vrrrrs/RL-CAT/docs/00-overview.md

# 项目总览（Overview）

> **文档编号**：DOC-OV-001 ｜ **版本**：v1.0 ｜ **日期**：2026-10-09
>
> **状态**：🟡 骨架 + 部分内容。完整内容待后续补齐（见文末「待补充」）。

---

## 1. 项目是什么

**RL-CAT 是一只 12 自由度四足机器人**，目标是走通"机械设计 → 仿真 → 强化学习训练 → sim-to-real 部署"的完整链路。

| 项 | 值 |
|---|---|
| **自由度** | 12（每腿 3：髋外摆 + 髋俯仰 + 膝） |
| **整机质量** | 1.386 kg（CAD 实测） |
| **机身尺寸** | 200 × 72 × 58 mm |
| **站立高度** | 约 133 mm（仿真实测） |
| **执行器** | 12 × Feetech ST-3215-C018（12V 版）总线舵机 |
| **上位机** | 树莓派 5 (4GB) —— 跑 RL 策略 |
| **下位机** | STM32F103C8T6 —— 100 Hz 实时控制 |
| **控制频率** | 100 Hz |
| **观测 / 动作** | 47 维 / 12 维 |

### 1.1 设计优先级

```
功能  >  小巧美观
（机械必须小、好看，但功能优先）
```

来源：`archive/方案_v1.md` §0「设计优先级」

---

## 2. 系统架构

```
┌─────────────────────────────────────────────────────────────┐
│  树莓派 5 (4GB)                                              │
│  · 运行 RL 策略（PyTorch / ONNX）                            │
│  · 100 Hz 推理 → 输出 12 维关节目标角                        │
└────────────────────┬────────────────────────────────────────┘
                     │ UART 500 kbps（自定义帧协议，交叉接线）
                     │ 下行：CMD_JOINT   上行：TEL_FAST (47 维观测)
┌────────────────────┴────────────────────────────────────────┐
│  STM32F103C8T6                                               │
│  · 100 Hz 控制环                                             │
│  · 舵机总线时序（SyncWrite / SyncRead）                       │
│  · 传感器采集（IMU 姿态、电池电压）                            │
│  · 安全保护（低压 / 超温 / 失联 → 趴下）                       │
└───────┬──────────────────────────┬──────────────────────────┘
        │ UART 500 kbps            │ 软件 I2C
        │ 直连（RX→RX, TX→TX）      │
┌───────┴──────────┐        ┌──────┴────────┐
│ 舵机控制板        │        │  JY901P IMU   │
│ (Waveshare A)    │        │ （内部融合）   │
│ 跳线 A 位         │        └───────────────┘
└───────┬──────────┘
        │ 半双工总线
┌───────┴──────────────────────────────────────┐
│  12 × ST-3215-C018 总线舵机                   │
│  供电：3S 电池经 16 AWG 粗线直供（绕过控制板）  │
└──────────────────────────────────────────────┘
```

### 2.1 职责边界（⚠️ 必须严格）

| 职责 | 树莓派 | STM32 |
|---|---|---|
| 策略推理 | ✅ | ❌ |
| 关节目标角生成 | ✅ | ❌ |
| 舵机总线时序 | ❌ | ✅ |
| PD 位置闭环 | ❌ | ✅（舵机内部 PID） |
| 传感器采集 | ❌ | ✅ |
| 姿态解算 | ❌ | ❌（JY901P 内部完成） |
| **安全保护** | ❌ | ✅ **（不依赖上位机）** |

**⚠️ 最重要：安全保护必须在 STM32 上独立完成，链路断了要能自己识别并趴下。**

---

## 3. 子系统导航

| 子系统 | 文档 | 代码/CAD 位置 |
|---|---|---|
| 机械 | [`10-mechanical.md`](10-mechanical.md) | [`hardware/mechanical/`](../hardware/mechanical/) |
| 电子 | [`20-electronics.md`](20-electronics.md) | [`hardware/electronics/`](../hardware/electronics/) |
| 固件 | [`30-firmware.md`](30-firmware.md) | [`firmware/`](../firmware/) |
| 仿真与训练 | [`40-simulation.md`](40-simulation.md) | [`Sim/`](../Sim/) |
| 部署 | [`50-deployment.md`](50-deployment.md) | — |

---

## 4. 技术路线

```
机械设计（SolidWorks）
   ↓  导出 URDF（SW2URDF）
URDF + 质量属性修正
   ↓  构建仿真环境（Isaac Gym + legged_gym）
RL 训练（PPO）
   ↓  域随机化
策略导出（ONNX）
   ↓
真机部署：Pi 跑策略 → STM32 控舵机
   ↓  系统辨识 → 反哺仿真 → 重训（迭代）
sim-to-real 完成
```

### 4.1 当前进展（最后更新：2026-10-16）

| 阶段 | 状态 | 说明 |
|---|---|---|
| 机械设计 | ✅ v1 完成 | |
| 电子设计 | ✅ 完成 | |
| URDF | ✅ 完成 | 质量/惯量按 SolidWorks 实测修正 |
| 仿真环境 | ✅ 完成 | Isaac Gym + legged_gym `rlcat` task |
| **RL 训练** | ✅ **已训出可行走策略** | 见 §5 |
| **STM32 固件** | ✅ **已交付** | 7966 行 / 7 层；1028 C 单测 + 161 Python 全绿；**真机验收进行中** |
| **舵机标定** | ✅ **已完成**（2026-10-16） | 12 关节 `offset`/`dir` 全部实测确认；零位语义见 [`30-firmware.md`](30-firmware.md) §3.3.1 |
| **ESP32 无线桥** | ✅ **已交付并上真机验证** | TX 链路 300/300 帧零 CRC 错；A4~A23 待执行 |
| **树莓派侧（基础层）** | ✅ **已交付** | 链路/遥测/标定/点动/姿态；离线 117 项 + 物理层 90 万字节零误码 |
| **真机部署** | 🟡 **进行中** | 见 §4.2 |

### 4.2 ⚠️ 当前卡在哪

**舵机标定已过关。剩余阻塞项：**

| # | 阻塞项 |
|---|---|
| 1 | ⚠️ **IMU 读不到** —— `safety_reasons = 0x40`（`RLCA_SAFE_R_IMU_STALE`）。寄存器配置与字节序均已核实正确，怀疑 `imu_poll()` 的陀螺离群值保护在反复丢帧。**它挡住 ACTIVE 准入门第 ④ 条。** |
| 2 | **12 个舵机逐个设 ID** —— 出厂全是 1，直接接 12 个会总线冲突 |
| 3 | **电池 ADC 标定** —— 万用表比对，目标误差 < 50 mV |
| 4 | **舵机侧软限位** —— 上位机设 `Min/Max Angle Limit`（留 10~15% 余量，**勿动 `OFS`**）。这是独立于固件的最后一道保险 |

**⚠️ 详细步骤与最新勘误见 [`42-pi-setup.md`](42-pi-setup.md) §D。**

**⚠️ 已知的固件行为偏差（19 处）与安全风险（`MODE_STAND` 无准入门）见 [`42-pi-setup.md`](42-pi-setup.md) §D2 与 [`../pi/README.md`](../pi/README.md) §8。**

---

## 5. 已取得的成果（仿真）

**在 Isaac Gym 上从零搭起训练环境，训出可稳定行走的策略。**

| 验收项 | 结果 |
|---|---|
| 步态结构 | ✅ 标准对角小跑（非蹦跳/跛行） |
| 左右对称 | ✅ 占空比差 0.08~0.14 |
| **速度跟踪误差** | ✅ **0.060 ~ 0.099 m/s**（−0.3 ~ +0.5 m/s 全段，含后退） |
| 稳定性 | ✅ 32 环境 × 15 s **零摔倒** |
| 机身高度 | ✅ 0.105~0.120 m（目标 0.13） |

**训练规模**：2048 并行环境，12–19 万 steps/s，1000 迭代约 6–8 分钟（RTX 4060 Laptop）。

**完整报告**：[`Sim/RL/RL-CAT-训练实施报告.md`](../Sim/RL/RL-CAT-训练实施报告.md) —— 含 **9 轮调参的完整记录**，包括失败案例与根因分析。

---

## 6. 后续推进顺序

```
[已完成] 机械 → 电子 → URDF → 仿真环境 → RL 训练（仿真侧走通）
   ↓
[已完成] 三端软件交付
         · STM32 固件（7 层 / 1028 C 单测 + 161 Python 全绿）
         · ESP32 无线桥（130 主机测试 + 真机 TX 链路验证）
         · 树莓派基础层（链路 / 遥测 / 标定 / 点动 / 姿态）
   ↓
[已完成] ⭐ 舵机标定（2026-10-16）
         · 12 关节 offset / dir 全部实测确认
         · 零位语义固化：URDF 零位 = 弯腿站姿 = q 0；标定姿态 = 腿伸直
         · 新增 K（安全总览 + 零位/限位）、W（原始步数写）两条调试命令
   ↓
[当前]   真机打通（⚠️ 剩余阻塞项）
         ① IMU 读不到（挡住 ACTIVE 准入门）
         ② 12 个舵机逐个设 ID
         ③ 电池 ADC 标定
         ④ 上位机设舵机 Min/Max Angle Limit（最后一道保险）
   ↓
[下一步] 树莓派侧验收
         pi_hello → status_panel → acceptance → acceptance --move
   ↓
[下一步] （可选）传统步态 —— 逆运动学在 Pi 上算
   ↓
[下一步] 接入 ONNX 策略（⚠️ 需先解决 4 处 RL 契约不一致，见 42-pi-setup §D）
   ↓
[下一步] 真机部署（吊起 → 落地 → 低速 → 放开）
   ↓
[下一步] 系统辨识 → 反哺仿真 → 重训（迭代 2~3 轮）
```

**⚠️ 详细步骤见：**

| 阶段 | 文档 |
|---|---|
| 真机打通 + 树莓派验收 | [`42-pi-setup.md`](42-pi-setup.md) §D4 |
| STM32 上机验收 | [`34-firmware-acceptance.md`](34-firmware-acceptance.md) |
| 固件调试命令 | [`41-firmware-debug-commands.md`](41-firmware-debug-commands.md) |
| 树莓派操作 | [`../pi/使用说明.md`](../pi/使用说明.md) |

---

## 7. 待补充

**⚠️ 本节列出本文档还缺什么，供后续补齐时参考：**

```
□ 项目背景（为什么要做这个项目、灵感来源）
□ 设计约束的完整列表（尺寸上限、成本预算、重量上限）
□ 与同类项目的对比（为什么选四足而不是轮式/双足）
□ 各个关键设计选择的理由汇总
□ 里程碑时间线
□ 硬件物料清单（BOM）与成本
□ 图片 / 渲染图 / 实物照片
```

**⚠️ 部分内容可从归档文档提炼：**

| 来源 | 可提炼内容 |
|---|---|
| `archive/方案_v1.md` §0 | 设计优先级、项目概要 |
| `archive/方案_v1.md` §10 | 推进顺序（已并入 §6） |
| `archive/项目流程_v1.md` | 分工流程、交接点 |

---

**文档结束。**
