vrrrrs/RL-CAT/docs/30-firmware.md

# 固件设计索引（Firmware Index）

> **文档编号**：DOC-FW-001
> **版本**：v1.0
> **日期**：2026-10-09
> **面向对象**：STM32 固件开发者 / Agent
>
> **⭐ 本文件是固件开发的【单一入口】。** 固件开发时反复要查的 5 张表都集中在这里，不需要去别的文档里拼。

---

## 1. 入口：4 份详细文档

**这 4 份是固件的实现规格，务必完整阅读：**

| # | 文档 | 内容 | 什么时候读 |
|---|---|---|---|
| **01** | [固件设计书.md](../firmware/doc/固件设计书.md) | 架构、模块划分、100 Hz 时序、中断优先级、标定、安全、开发阶段 | **先读这个** |
| **02** | [协议规范_树莓派通信.md](../firmware/doc/协议规范_树莓派通信.md) | 帧格式、7 种消息的精确字节布局、CRC-16、接收状态机 | 实现 `link_pi` 前 |
| **03** | [伺服总线模块设计.md](../firmware/doc/伺服总线模块设计.md) | STS 协议、官方库 4 个缺陷、DMA+IDLE 方案、验收测试 | 实现 `servo_bus` 前 |
| **04** | [CubeMX配置清单.md](../firmware/doc/CubeMX配置清单.md) | 配置核对、待改项、上电自检 | **开工第一步** |

**工程位置**：`firmware/stm32/`（CubeMX 工程 + Keil 工程）

---

## 2. ⭐ 表一：关节索引 ↔ 名称 ↔ 舵机 ID

### 2.1 逻辑索引（固件与协议统一使用）

```
索引  0   1   2   3  │  4        5         6         7  │  8       9        10       11
名称  lf  lb  rf  rb │  lf       lb        rf        rb │  lf      lb       rf       rb
类型  髋外摆 ×4       │  髋俯仰 ×4                        │  膝 ×4
```

| 索引 | 关节名 | 类型 | 腿 |
|---|---|---|---|
| **0** | `lf_hip` | 髋外摆 | 左前 |
| **1** | `lb_hip` | 髋外摆 | 左后 |
| **2** | `rf_hip` | 髋外摆 | 右前 |
| **3** | `rb_hip` | 髋外摆 | 右后 |
| **4** | `lf_thigh` | 髋俯仰 | 左前 |
| **5** | `lb_thigh` | 髋俯仰 | 左后 |
| **6** | `rf_thigh` | 髋俯仰 | 右前 |
| **7** | `rb_thigh` | 髋俯仰 | 右后 |
| **8** | `lf_calf` | 膝 | 左前 |
| **9** | `lb_calf` | 膝 | 左后 |
| **10** | `rf_calf` | 膝 | 右前 |
| **11** | `rb_calf` | 膝 | 右后 |

**⚠️ 所有 12 维向量（观测、动作、协议负载）一律用这个顺序。**

### 2.2 ⚠️ 三套"顺序"不要混淆

| 体系 | 排列 | 用在哪 |
|---|---|---|
| **A. 逻辑索引**（上表） | 按关节类型分组 | **固件数组、协议、观测/动作** |
| **B. URDF 声明顺序** | 按腿分组 | URDF 文件书写顺序 |
| **C. 训练侧顺序** | 按名字查表，自动处理 | legged_gym（不需要映射） |

**B 的实际顺序：**

```
0 lf_hip   1 lf_thigh  2 lf_calf   3 lb_hip   4 lb_thigh  5 lb_calf
6 rf_hip   7 rf_thigh  8 rf_calf   9 rb_hip  10 rb_thigh 11 rb_calf
```

**A → B 映射：**

```c
// A 索引 -> B 索引
const uint8_t A2B[12] = {0, 3, 6, 9, 1, 4, 7, 10, 2, 5, 8, 11};
```

**⚠️ 导出到固件时的映射（训练侧报告 §4.3 给出）：**

```
A2C = [3, 0, 9, 6, 4, 1, 10, 7, 5, 2, 11, 8]
```

### 2.3 舵机 ID 分配（⚠️ 建议方案，需人确认）

| A 索引 | 关节名 | 建议舵机 ID |
|---|---|---|
| 0 | `lf_hip` | 1 |
| 1 | `lb_hip` | 2 |
| 2 | `rf_hip` | 3 |
| 3 | `rb_hip` | 4 |
| 4 | `lf_thigh` | 5 |
| 5 | `lb_thigh` | 6 |
| 6 | `rf_thigh` | 7 |
| 7 | `rb_thigh` | 8 |
| 8 | `lf_calf` | 9 |
| 9 | `lb_calf` | 10 |
| 10 | `rf_calf` | 11 |
| 11 | `rb_calf` | 12 |

**⚠️ 舵机出厂 ID 通常是 1，直接接 12 个会冲突。必须逐个改 ID（改完立刻拔掉，再接下一个）。**

**⚠️ 如果实际 ID 与此表不同，只改 `joint_cfg_t.servo_id` 字段，代码逻辑不动。**

---

## 3. ⭐ 表二：关节限位

### 3.1 ⚠️⚠️ 两个 URDF 的 thigh 上限不同 —— 固件必须用哪个？

| 关节 | 硬件 URDF<br>`hardware/mechanical/URDF/robot.urdf` | 训练 URDF<br>`Sim/RL/urdf/robot_sim.urdf` |
|---|---|---|
| `*_hip` | 0 ~ +40° | 0 ~ +40° |
| **`*_thigh`** | **−35° ~ +30°** | **−35° ~ +90°** ⚠️ |
| `*_calf` | −60° ~ +60° | −60° ~ +60° |

**⭐ 结论：固件应采用【训练 URDF 的 90°】。**

**理由：** 训练好的策略是在 **90°** 限位下训出来的，它的摆腿动作依赖这 90° 的空间。如果固件按硬件 URDF 的 30° 限幅，真机上策略会被硬性削掉摆腿幅度，导致行走异常。

**⚠️ 这个不一致需要回填到硬件 URDF** —— 但目前 `hardware/mechanical/` 由人工负责整理，此处只记录结论。

### 3.2 固件应实现的限位（弧度与度）

| 关节类型 | lower (rad) | lower (°) | upper (rad) | upper (°) |
|---|---|---|---|---|
| **`*_hip`**（外摆） | `0` | 0° | `0.6981317` | **+40°** |
| **`*_thigh`**（髋俯仰） | `-0.61086524` | −35° | `1.5707963` | **+90°** |
| **`*_calf`**（膝） | `-1.0471975` | −60° | `1.0471975` | **+60°** |

**⚠️ `*_hip` 是不对称的（0 ~ +40°），不做内摆（负方向）。**

### 3.3 关节零位与偏置

```
URDF 的 q = 0  ←→  机器人处于【弯腿站立姿态】
```

**✅ 已实测确认**（`Sim/RL/RL-CAT-训练实施报告.md` §4.3）：`default_joint_angles` 全为 0，机器人确实站立成功。

**⚠️ 因此 `q_default = [0]*12`。**

**转换公式：**

```c
// 关节角(rad) → 舵机步数
int16_t joint_to_servo(uint8_t idx, float q_rad) {
    float steps = q_rad * (4096.0f / (2.0f * 3.14159265f));
    float s = g_joints[idx].dir * steps + g_joints[idx].offset;
    return (int16_t)(s + 0.5f);
}
```

**⚠️ `dir` 字段处理左右腿舵机安装方向差异（`+1`/`-1`），不要在上层写 if。**

#### 3.3.1 ⭐⭐⭐ 三个"零"必须分清（2026-10-16 上机验证通过，标定关结束）

**这一节是踩过多轮坑之后定下来的。混淆这三者会导致"标定完立刻大幅运动"。**

| 名字 | 姿态 | 关节角 | 舵机编码器读数 |
|---|---|---|---|
| **URDF 零位** | **弯腿站姿**（`default_joint_angles` 全 0） | **q = 0** | **= `offset`** ⭐ |
| **标定姿态** | **腿伸直、垂直向下、髋水平** | q = ±`q_calib`（**幅值**） | **2048**（上位机里设的） |
| 编码器零 | 舵机自己的 0 位 | 无关 | 0 |

**⇒ `offset[i]` 的精确含义：URDF 零位（弯腿站姿）下，舵机 i 的编码器步数。**
**⇒ 换算恒等式：`step(q) = dir × q × STEPS_PER_RAD + offset`。**

**转换公式（标定姿态 → offset）：**

```
已知 step(q_calib) = 2048（项目负责人在上位机里把"腿伸直"设成 2048）
⇒ offset = 2048 − dir × q_calib × STEPS_PER_RAD
```

**⚠️⚠️ `q_calib` 是【幅值，全为正】，符号完全交给 `dir` 表达。**

**这是本项目最容易搞错的一处，务必记住：**

> `dir` 本身编码了"关节角增大 → 编码器增大(+1) 还是减小(−1)"。
> 如果再给 `q_calib` 加上左右镜像符号，两个符号会**互相抵消**，
> 于是左右两侧的 `offset` 跑到 2048 的**同一侧** —— 那是错的。

**实测证据（项目负责人用 `W` 命令把关节送到 offset 看姿态）：**

| 关节 | dir | q_calib | offset | 与 2048 |
|---|---|---|---|---|
| lf_thigh | +1 | 45° | 2048 − 512 = **1536** | **< 2048** ✅ |
| rf_thigh | −1 | 45° | 2048 + 512 = **2560** | **> 2048** ✅ |
| lf_calf | −1 | 90° | 2048 + 1024 = **3072** | **> 2048** ✅ |
| rf_calf | +1 | 90° | 2048 − 1024 = **1024** | **< 2048** ✅ |

**左右分居 2048 两侧 = 物理镜像对称。**

**⚠️ 标定时机器人必须真的处于"腿伸直"姿态** —— 因为固件按 `q_calib` 反推。
若标定时腿是自然下垂/被外力顶住的，`q_calib` 的假设就不成立。

#### 3.3.2 关节方向表（`dir`，实测确定）

**`dir` 不能只从 URDF 推断**（它取决于舵机安装朝向），**必须实测**。

**⚠️ 2026-10-16 最终确定值（按舵机 ID）：**

```
1↔+1   2↔−1   3↔−1   4↔+1      ← hip    外摆时编码器增/减
5↔+1   6↔+1   7↔−1   8↔−1      ← thigh  前摆时编码器增/减
9↔−1   10↔−1  11↔+1  12↔+1     ← calf   （相对 thigh 的符号关系）
```

**⚠️ calf 那四个（ID 9~12）在 2026-10-16 被**整体翻转**过一次** —— 初版按"与 thigh 同号"猜测，实测定为反向。**这是"不能靠推断、必须实测"的最好例证。**

**集中定义在 `firmware/stm32/Core/Inc/rlcat_config.h` 的 `RLCA_JOINT_DIR_INIT`。上层代码不含任何 `if (左/右)`。**

**⚠️ 验证方法（`W` 命令，见 `docs/41-firmware-debug-commands.md`）：**

```
T 1                 ← 打开手动力矩覆盖（否则 ⑥b 会掐断位置帧）
W <j> <offset_j>    ← 把关节 j 送到它自己的 offset
K                   ← 确认停住 + 目视姿态
```

**若送到的位置正好是"弯腿站姿里该关节该在的位置"，则 `dir` 与 `offset` 都正确。**

**标定方法：** 机器人自然站立 → 卸载力矩 → 等稳定 → 读 12 个舵机位置 → 存为 `offset`。详见设计书 §6。

---

## 4. ⭐ 表三：引脚分配

**MCU**：STM32F103C8T6（Blue Pill，LQFP48）

| 引脚 | 配置 | 用途 | 备注 |
|---|---|---|---|
| **PA0** | `ADC1_IN0` | 电池分压采样 | R1=100k / R2=20k |
| PA1 | — | 空闲 | |
| **PA2** | `USART2_TX` | **舵机控制板**（TX→TX 直连） | 1 Mbps |
| **PA3** | `USART2_RX` | **舵机控制板**（RX→RX 直连） | 1 Mbps |
| PA4 / PA5 | — | 预留 | |
| PA6 / PA7 | — | 空闲（预留 SPI IMU） | |
| **PA8** | GPIO 输出 | 心跳 | 标签 `HEARTBEAT` |
| **PA9** | `USART1_TX` | 树莓派 RX（**交叉**） | 500 kbps |
| **PA10** | `USART1_RX` | 树莓派 TX（**交叉**） | 500 kbps |
| PA11 / PA12 | — | 空闲（USB DM/DP） | |
| **PA13** | SWDIO | 调试 | ⚠️ **绝不复用** |
| **PA14** | SWCLK | 调试 | ⚠️ **绝不复用** |
| PA15 | — | ⚠️ 默认被 JTAG 占用 | 需 `JTAGDisable` 才可用 |
| **PC13** | GPIO 输出（**低电平点亮**）| 状态 LED（板载）| ⚠️ 原文档误写为 PB0 |
| PB1 | — | 备用 | |
| **PB2** | — | ⚠️ **BOOT1，必须悬空** | 不配任何功能 |
| PB3 / PB4 | — | ⚠️ 默认被 JTAG 占用 | 需 `JTAGDisable` |
| PB5 | — | 空闲 | |
| **PB8** | GPIO 开漏 | 软件 I2C SCL → JY901P | 外部 4.7k 上拉到 3.3V |
| **PB9** | GPIO 开漏 | 软件 I2C SDA → JY901P | 外部 4.7k 上拉到 3.3V |
| **PB10** | `USART3_TX` | ESP32-C3 | **115200**（低频调试通道）|
| **PB11** | `USART3_RX` | ESP32-C3 | **115200**（低频调试通道）|
| PB12–PB15 | — | 预留足底开关 / 急停输入 | ⚠️ **本次未实现**，见下 |

**⚠️ 急停输入：本次固件【不实现】，仅保留编译开关。**

```
固件里的位置：rlcat_config.h 的 RLCA_ESTOP_INPUT_EN（当前 = 0）
⚠️ 该宏目前【没有任何代码使用它】—— 刻意如此：
   "留一个没人用的开关"比"留一段没人测过的代码"安全。
   将来实现时，pb12~pb15 任选一个：上拉输入 + EXTI 下降沿，
   中断优先级不低于舵机总线，动作 = 立即进 ESTOP。

⚠️ 因此当前的软件急停路径是：
   ① 链路失联 > 100 ms（link_pi）→ app_safety 缓慢趴下
   ② 电压 ≤ 9.3 V / 舵机 > 70 °C（app_safety）→ 缓慢趴下
   ③ 上位机主动发 CMD_MODE(mode=ESTOP)
   —— 没有"一根线直接拉低"的硬路径。
```

**⚠️ 三路 UART 的接线方式不同：**

| 链路 | 接线 |
|---|---|
| USART1 ↔ 树莓派 | **交叉**（TX→RX、RX→TX） |
| USART2 ↔ 舵机控制板 | **直连**（TX→RX 端子丝印 → 一对一）⚠️ 跳线必须在 **A** 位 |

---

## 5. ⭐ 表四：观测 / 动作向量布局

### 5.1 观测：**47 维**（⚠️ 不是 50 维）

**⚠️ 旧交接文档写的 50 维是【设计值】，实际实现是 47 维（"方案 C"）。固件必须按 47 维拼接。**

| 索引 | 内容 | 维度 | 缩放 | 数据来源 |
|---|---|---|---|---|
| **0–2** | 重力向量（机身系） | 3 | 1.0 | IMU 四元数 → **Pi 反算** |
| **3–5** | 机身角速度（陀螺） | 3 | **×0.25** | IMU |
| **6–8** | 速度指令 (vx, vy, ωz) | 3 | 1.0 | **Pi 自己产生** |
| **9–20** | 关节位置（**相对 `q_default`**） | 12 | 1.0 | 舵机反馈 |
| **21–32** | 关节速度 | 12 | **×0.1** | 舵机反馈 |
| **33–44** | 上一帧动作 | 12 | **×4.0** | **Pi 自己缓存** |
| **45–46** | 步态相位 sin / cos | 2 | 1.0 | ⭐ **STM32 产生，经 TEL_FAST 下发** |
| | **合计** | **47** | | |

**⚠️ 三个关键点：**

| # | 要点 |
|---|---|
| 1 | **关节位置是相对 `q_default` 的**（即 `q - q_default`）。因为 `q_default = 0`，实际就是 `q` 本身 |
| 2 | **关节速度缩放是 ×0.1**，⚠️ upstream legged_gym 默认是 0.05，已按本项目改为 0.1 |
| 3 | ⭐ **步态相位由 STM32 产生**（不是 Pi）—— 理由见 §5.1.1 |

### 5.1.1 ⭐ 为什么步态相位由 STM32 产生

| # | 理由 |
|---|---|
| **1** | **唯一源头** —— 如果两边各产生一份，数值会不一致 |
| **2** | **时钟精度** —— STM32 的 TIM 精确到晶振级（±20 ppm）；Pi 5 的 Linux 用户态循环抖动 0.1~1 ms，**会累积相位误差** |
| **3** | **STM32 本来就是节拍源** —— 100 Hz 周期由 STM32 发起 |
| **4** | **成本极低** —— 查表或 `arm_sin_f32`，每周期 2 次 |

**⚠️ 相位算法（必须与训练侧严格一致，来自 `rlcat_env.py:104-106`）：**

```c
// 训练侧：phase = (phase + dt * gait_freq) % 1.0
//         sin_p = sin(2*pi*phase);  cos_p = cos(2*pi*phase)
// gait_freq = 3.0 Hz（rlcat_config.py 的 control.gait_freq）
// ⚠️ 每【控制周期】推进 3.0/100 = 0.03

#define GAIT_FREQ_HZ  3.0f
static float s_phase = 0.0f;

s_phase += GAIT_FREQ_HZ / 100.0f;      // += 0.03
if (s_phase >= 1.0f) s_phase -= 1.0f;

int16_t gait_sin = (int16_t)(arm_sin_f32(2.0f*PI*s_phase) * 32767.0f);
int16_t gait_cos = (int16_t)(arm_cos_f32(2.0f*PI*s_phase) * 32767.0f);
```

**⚠️ 推导（验证 0.03 正确）：**

```
训练侧每物理步推进：dt × f = (1/200) × 3.0 = 0.015
decimation = 2 → 每 2 个物理步组装一次观测
→ 每控制周期推进：2 × 0.015 = 0.03
一个完整周期 = 1/0.03 ≈ 33.3 周期 = 0.333 s  → 3.0 Hz  ✅ 自洽
```

**⚠️ 完整定义（含 TEL_FAST 字节偏移）见 [`firmware/doc/协议规范_树莓派通信.md`](../firmware/doc/协议规范_树莓派通信.md) §4.4.1。**

**⚠️ 旧文档的 50 维里那 3 个"保留维"，将来若要加，直接往后接（索引 47–49），已有顺序一字不动。**

**⚠️ legged_gym 原生 48 维里有 3 维机身线速度，已被**删除** —— 真机没有这个传感器，策略一旦依赖它在 sim-to-real 时必崩。**

### 5.2 动作：12 维

```
q_target[i] = q_default[i] + 0.25 * action[i]        // rad
然后 clamp 到软限位
```

**⚠️ `action` 经 tanh 后落在 [-1, 1]，所以单步最大改变 0.25 rad（14.3°）。**

**⚠️ `q_default = 0`，所以实际就是 `q_target[i] = 0.25 * action[i]`。**

### 5.3 策略网络

| 项 | 值 |
|---|---|
| 算法 | PPO |
| Actor | MLP [256, 128, 64] |
| Critic | MLP [256, 128, 64]（**部署时不需要**） |
| 控制频率 | **100 Hz**（decimation=2，sim dt=1/200） |
| **部署格式** | **ONNX**（⭐ 已决策：便于开源与跨平台） |
| 备用格式 | TorchScript（`policy.pt`）、numpy 权重（`policy_weights.npz`） |

**已导出的策略位置**：`Sim/RL/exported/`

**⚠️ ONNX 导出** —— 现有 `13_export_policy.py` 导出的是 TorchScript + numpy 权重，**需要补一条 ONNX 导出路径**（`torch.onnx.export`，`dynamic_axes=None`，固定 batch=1 × 47 维输入）。

**⚠️ 导出后必须做数值一致性验证：** 同一组输入下，ONNX 输出与 PyTorch 输出的最大偏差 **< 1e-5**。ONNX 导出偶有算子差异，这一步不能省。

---

## 6. ⭐ 表五：关键参数（频率 / 超时 / 阈值）

### 6.1 时序

| 参数 | 值 |
|---|---|
| **控制周期** | **100 Hz（10 ms）** |
| 物理步长（仿真） | 200 Hz |
| 舵机总线波特率 | 1 Mbps |
| 树莓派链路波特率 | 500 kbps |
| ESP32 链路波特率 | **115200**（2026-10-10 由 921600 下调，低频调试通道）|
| IMU 带宽 | 上位机设 `BANDWIDTH`@0x1F = 2（**98 Hz**，最高档） |
| IMU 输出速率 | 上位机设 `RRATE`@0x03 = 9（**100 Hz**）—— ⚠️ 默认仅 10 Hz |
| IMU 字节序 | **小端**（实测确认，手册未写）；`imu_i16()` 已按小端实现 |
| IMU 四元数 | 模块直接给 q0~q3@0x51~0x54（`raw/32768`），当前固件走欧拉角路径 |
| 系统时钟 | 72 MHz |

### 6.2 超时

| 参数 | 值 | 说明 |
|---|---|---|
| **舵机总线整帧超时** | **3 ms** | ⚠️ 官方库没有整帧超时，必须外挂 |
| IMU 读取超时 | 5 ms | |
| **树莓派链路失联（降级）** | **30 ms** | 连续 3 个周期无指令 |
| **树莓派链路失联（急停）** | **100 ms** | 强制趴下 |
| 协议帧接收超时 | 5 ms | 收半个帧后复位状态机 |

### 6.3 中断优先级（`NVIC_PRIORITYGROUP_4`）

| 中断 | 抢占优先级 | 状态 |
|---|---|---|
| `DMA1_Channel1`（ADC） | 5 | ✅ 已配 |
| **`USART2`（舵机总线）** | **6** | ⚠️ **待改**（当前是 0） |
| `USART1`（树莓派） | 7 | ⚠️ **待改**（当前是 0） |
| `USART3`（ESP32） | 8 | ⚠️ **待改**（当前是 0） |
| `TIM2`（1 kHz 节拍，可选） | 9 | 未配 |
| `SysTick` | 15 | ✅ 已配 |

**⚠️ 优先级数字越小 = 越高。舵机总线必须高于树莓派链路。**

### 6.4 电池电压阈值

| 电压 | 级别 | 动作 |
|---|---|---|
| > 10.5 V | 正常 | — |
| **≤ 10.5 V** | L1 警告 | LED 慢闪 + 上报 |
| **≤ 9.9 V** | L2 | 上报 + 限制动作幅度 |
| **≤ 9.3 V** | L3 强制 | **卸载力矩 → 趴下** |

**⚠️ 分压比 = (100 + 20) / 20 = 6.000。需两步标定：先量 3.3V 实际值填 `ADC_VREF`，再对比万用表微调分压比（目标误差 < 50 mV）。**

### 6.5 舵机参数

| 参数 | 值 |
|---|---|
| 型号 | **Feetech ST-3215-C018（12V 版）** ⚠️ 只有这个型号能用 3S |
| 位置分辨率 | 4096 步 / 360°（0.0879°/step） |
| 位置范围 | 0–4095（多圈会回绕，需处理） |
| 位置更新周期 | 最快 1 ms |
| 堵转扭矩 | 2.942 N·m @12V / 2.721 N·m @11.1V |
| 空载转速 | 45 RPM = 4.71 rad/s |
| URDF effort | 3 N·m（安全上限，略大于物理堵转） |
| URDF velocity | 8 rad/s（可收紧到 4.71） |
| 过流保护 | >2 A 持续 2 s 切断 |
| 过温保护 | >70 °C |

### 6.6 STS 协议关键地址（来自官方 `ST.h`，已核实）

| 地址 | 宏名 | 说明 |
|---|---|---|
| 40 | `SMS_STS_TORQUE_ENABLE` | 力矩使能 |
| 41 | `SMS_STS_ACC` | 加速度 |
| **42** | `SMS_STS_GOAL_POSITION_L` | **目标位置** |
| **46** | `SMS_STS_GOAL_SPEED_L` | 运行速度 |
| **55** | `SMS_STS_LOCK` | 锁标志（写 0 才能改 ID/偏置） |
| **56** | `SMS_STS_PRESENT_POSITION_L` | **当前位置反馈** |
| 58 | `SMS_STS_PRESENT_SPEED_L` | 当前速度 |
| 60 | `SMS_STS_PRESENT_LOAD_L` | 当前负载 |
| **62** | `SMS_STS_PRESENT_VOLTAGE` | 电压（0.1 V） |
| **63** | `SMS_STS_PRESENT_TEMPERATURE` | 温度（°C） |
| 66 | `SMS_STS_MOVING` | 移动标志 |
| 69 | `SMS_STS_PRESENT_CURRENT_L` | 电流 |
| **5 / 6** | `SMS_STS_ID` / `SMS_STS_BAUD_RATE` | EPROM：ID / 波特率 |
| **31–32** | `SMS_STS_OFS_L/H` | EPROM：中位偏置 |

**指令码**：`INST_PING=0x01`、`INST_READ=0x02`、`INST_WRITE=0x03`、`INST_REG_WRITE=0x04`、`INST_REG_ACTION=0x05`、**`INST_SYNC_READ=0x82`**、**`INST_SYNC_WRITE=0x83`**

**波特率索引（地址 6）**：`0`=1 Mbps、`1`=0.5M、`2`=250k、`3`=128k、`4`=115200、`5`=76800、`6`=57600、`7`=38400

---

## 7. 开工前必须确认的 4 件事

| # | 事项 | 怎么确认 |
|---|---|---|
| **1** | **舵机 ID 分配方案** | ⚠️ 需人确认（见 §2.3） |
| **2** | **HSE 晶振真的是 8 MHz** | 看板子丝印，或用 MCO 输出量 |
| **3** | **舵机控制板：跳线在 A 位；接线直连（RX→RX、TX→TX）** | 看硬件 + [官方文档](https://docs.waveshare.com/Bus_Servo_Adapter_A/Product-Wiring-Example) |
| **4** | **PB8/PB9 的外部 4.7 kΩ 上拉已装** | 看 PCB |

---

## 8. 推荐推进顺序

```
第 1 步  按 [CubeMX配置清单] 修配置 + 跑通上电自检      ← 时钟/中断/缓冲是地基
   ↓
第 2 步  BSP 层：UART 中断 + 环形缓冲，用串口自测
   ↓
第 3 步  servo_bus：先控 1 个舵机 → 再到 12 个         ← 最难，留足时间
   ↓
第 4 步  link_pi：PC 端写 Python 模拟树莓派，跑通帧协议
   ↓
第 5 步  关节标定：读舵机位置 → 存 Flash
   ↓
第 6 步  app_mode + app_safety（状态机 + 安全机制）
   ↓
第 7 步  与树莓派联调
```

**⚠️ 第 3 步和第 4 步可以并行**（一个调舵机、一个调通信），互不阻塞。

**⚠️ 但第 1 步必须先做完** —— 8 MHz 时钟或未配对的中断会让后面每一层性能不足，排查时容易误判。

---

## 9. ✅ 实施状态（2026-10-10 更新）

**七步已全部实现并离线验证完毕**，产物与验收单见：

| 步骤 | 状态 | 交付物 / 验收 |
|---|---|---|
| 第 1 步 CubeMX + 上电自检 | ✅ | [`34-firmware-acceptance.md`](34-firmware-acceptance.md) P2 节（8 项） |
| 第 2 步 BSP 层 | ✅ | 同上；三路 UART + DWT µs + 软件 I2C + Flash + 上电自检 |
| 第 3 步 servo_bus | ✅ | 同上 P3 节（9 项）；含 143 项假总线单测 |
| 第 4 步 link_pi | ✅ | 同上 P4 节（9 项）；含树莓派侧模拟器 `pi/sim_esp32.py` |
| 第 5 步 关节标定 | ✅ | 同上 P6-2；含完整标定状态机 + 假舵机端到端测试 |
| 第 6 步 app_mode + app_safety | ✅ | 同上 P6 节（6 项）；**含缓慢趴下与独立超时兜底** |
| 第 7 步 与树莓派联调 | 🟡 | 代码与模拟器就绪；**实际联调待硬件** |

**离线验证规模（PC 上可复现）：**

```
C 侧单元测试  1009 项全绿（6 个套件）
Python 侧测试  161 项全绿（协议自检 141 + 模拟器回环 20）
固件构建      0 error 0 warning，FLASH 65%、RAM 31%
```

**⚠️ 上线前必读两份新文档：**

| 文档 | 内容 |
|---|---|
| [`34-firmware-acceptance.md`](34-firmware-acceptance.md) | 逐项上机验收单（P2~P6，共 37 项） |
| [`35-firmware-deployment.md`](35-firmware-deployment.md) | ⭐ **联调与部署手册**：接口契约、调试顺序、故障决策树、部署步骤 |

**✅ 已核实并上机通过（2026-10-11）**：JY901P 手册到手（`reference/JY901P_I2C协议.md`）后
逐条核对，查出并修正 **3 个真 bug**（器件 ID 寄存器、角度换算系数、**字节序**）。
映射与量程集中在 `firmware/stm32/Core/Inc/rlcat_config.h` 的 §3b。
⚠️ 结论之一是 **I2C 寄存器是小端**（手册未写，靠上机原始字节实测确定）。
核对方法与实测证据见验收单 P5-2 与 [`39-firmware-handover.md`](39-firmware-handover.md) §5.7。

---

## 9. 三个最容易搞错的技术点

### 9.1 `SC.c` 和 `SCSerail.c` 是两个不同的文件

```
SC.c        = 协议层（组帧、校验、syncReadBegin、malloc 缺陷在这里）
SCSerail.c  = 串口底层（readSC、readSCTimeOut、IOTimeOut、SCDelay）← 拼写错误，实为 SCSerial
```

**搜超时相关代码去 `SCSerail.c`。**

### 9.2 官方 `uart.c` 必须整体替换

```
原因①：基于 StdPeriph 库，与 CubeMX 的 HAL 冲突
原因②：自带 USART1_IRQHandler / USART2_IRQHandler，与 stm32f1xx_it.c 重复定义
```

**确切签名（来自官方 `uart.h`）：**

```c
void    Uart_Init(uint32_t baudRate);
void    Uart_Flush(void);
int16_t Uart_Read(void);                      // ⚠️ 读【单字节】，空时返回 -1
void    Uart_Send(uint8_t *buf, uint8_t len); // ⚠️ len 是 uint8_t
```

### 9.3 ⚠️ 关节限位有个"两个 URDF 不一致"的坑

**见 §3.1：train URDF 的 thigh 上限是 90°，硬件 URDF 是 30°。固件用 90°。**

---

## 10. 相关文档（项目其他部分）

| 文档 | 路径 | 内容 |
|---|---|---|
| 项目总览 | [`docs/00-overview.md`](00-overview.md) | 项目全貌、路线图 |
| 电子设计 | [`docs/20-electronics.md`](20-electronics.md) | 电源架构、通信架构 |
| 机械设计 | [`docs/10-mechanical.md`](10-mechanical.md) | 关节构型、坐标系约定 |
| 仿真与训练 | [`docs/40-simulation.md`](40-simulation.md) | Isaac Gym、RL 流程 |
| 术语表 | [`docs/99-glossary.md`](99-glossary.md) | ⭐ **命名歧义澄清** |
| 设计决策记录 | [`docs/90-decisions.md`](90-decisions.md) | 为什么这么设计 |
| URDF | [`hardware/mechanical/URDF/robot.urdf`](../hardware/mechanical/URDF/robot.urdf) | 关节定义、质量属性 |
| 官方舵机库 | [`reference/servo/STServoBCL_keil_f103/`](../reference/servo/STServoBCL_keil_f103/) | 待移植的原始库 |
| 舵机规格书 | [`reference/servo/ST-3215-C018.pdf`](../reference/servo/ST-3215-C018.pdf) | 电气参数 |
| STM32 手册 | [`reference/stm32/STM32f103.pdf`](../reference/stm32/STM32f103.pdf) | 寄存器细节 |
| **已归档旧文档** | [`archive/README.md`](../archive/README.md) | ⚠️ 含已知错误的文档在这里，**不要作为设计依据** |

---

**文档结束。开工前请先读 4 份详细文档 + 确认 §7 的 4 件事。**
