vrrrrs/RL-CAT/docs/34-firmware-acceptance.md

# 固件上机验收单（Firmware Bring-up Acceptance）

> **文档编号**：DOC-FW-ACCEPT-001 ｜ **版本**：v1.0 ｜ **日期**：2026-10-10
> **面向对象**：执行上机验证的人（负责人）
> **配套文档**：[`33-firmware-plan.md`](33-firmware-plan.md)（施工方案）
>
> **用法：** 每完成一个阶段（P），本文档对应增加一节。**按顺序做，每条都要留下结论。**
> 固件方无法接触硬件，所以**这一份就是"代码是否真的能用"的唯一判据**。
> 任何一条不通过，把现象（含串口输出、示波器读数）贴回来，固件方据此修。

---

## 通用准备

```
□ 硬件
  · STM32F103C8T6（Blue Pill），已焊/已插好
  · USB-TTL 串口模块 1 个（3.3V 电平！不要 5V）
  · ST-Link（或其它 SWD 下载器）
  · 万用表
  · 3S 电池 + 舵机控制板 + 至少 1 个 ST-3215-C018 舵机（P3 需要）
  · 示波器（P2 的 I2C 项、P3 的总线项需要；没有的话按"替代判据"做）

□ 串口工具（PC 端）
  · 推荐 PuTTY / MobaXterm / minicom
  · 波特率 1000000（1 Mbps），8N1，无流控
  · ⚠️ 很多工具的下拉框没有 1000000，要手动输入
  · 必须打开"本地回显"或用能看到自己输入的模式，否则敲命令看不到字

□ 烧写
  · 固件：firmware/stm32/build/stm32.hex（armclang 命令行构建产物）
    或 Keil 构建产物
  · ⚠️ 第一次烧写前先确认 BOOT0 = 0（从 Flash 启动）
  · ⚠️ PB2 (BOOT1) 必须悬空或下拉
```

---

## P2 —— BSP 层与上电自检

**本阶段验证：** 时钟、微秒计时、三路 UART 收发、软件 I2C 总线、Flash 标定页、LED/心跳。
**本阶段不涉及：** 舵机、树莓派协议、IMU 解析、状态机。

### 接线

```
USART1 PA9 (TX) ──→ USB-TTL 的 RX
USART1 PA10(RX) ←── USB-TTL 的 TX
GND           ────  USB-TTL 的 GND
（PA0 接电池分压、PA2/PA3 接舵机控制板 本阶段可不接）
```

---

### P2-1 LED 与心跳 ← 最先确认"程序在跑"

| 项 | 内容 |
|---|---|
| 动作 | 上电（或按复位） |
| 预期 | **PC13 上的板载 LED 灭**（自检全通过）或**慢闪**（I2C 总线异常）；**PA8 心跳以 1 Hz 翻转**（亮 0.5 s / 灭 0.5 s）|
| 判据 | 心跳必须是**稳定的 1 Hz**。用手机秒表数 10 次翻转 ≈ 10 s |
| ❌ 不通过的现象 | **PC13 以约 10 Hz 快闪** = 进了 `Error_Handler()`（时钟或外设初始化失败）；**完全不亮也不闪** = 程序没跑（查 BOOT0、供电、晶振）|

> ⚠️ **PC13 快闪（10 Hz）与慢闪（1 Hz）一定要分清** —— 这是固件唯一能告诉你的"启动失败"信号。
> ⚠️ **板载 LED 在 PC13 且是【低电平点亮】**（引脚拉低才亮）。
> 固件用 `RLCA_LED_ACTIVE_LOW` 统一处理极性，全模块只通过一个
> `led_write()` 碰 LED 引脚 —— 换板子只改这一个宏。
> ⚠️ 早期版本把 LED 错配在 PB0 且按高电平点亮写，导致**状态灯永远不亮、
> 所有状态指示（含"启动失败"提示）全部静默**。详见
> [`39-firmware-handover.md`](39-firmware-handover.md)。

---

### P2-2 时钟 = 72 MHz

| 项 | 内容 |
|---|---|
| 动作 | 串口敲 `s` |
| 预期 | `sysclk_hz = 72000000`、`pclk1_hz = 36000000`、`pclk2_hz = 72000000` |
| 判据 | 三个数**完全相等**才算通过（差一点都是晶振或 PLL 配置不对） |
| 替代判据 | 心跳周期若明显不是 1 Hz（比如 2 倍快/慢），几乎一定是时钟不对 |

**⚠️ 这一条是所有后续测试的地基。** 时钟不对时，1 Mbps 波特率会有误差、微秒延时全错、
心跳周期也不对 —— 后面每一条都会跟着失败，排查时会误判成别的问题。

---

### P2-3 DWT 微秒计时

| 项 | 内容 |
|---|---|
| 动作 | 串口敲 `s` |
| 预期 | `dwt_ok = 1` |
| 判据 | 必须为 1。为 0 说明 Cortex-M3 的 DWT 没使能，舵机总线的 3 ms 整帧超时会退化成 1 ms 分辨率 |
| 失败后果 | P3 的总线超时会不精确（但不会崩） |

---

### P2-4 串口 shell 能收发

| 项 | 内容 |
|---|---|
| 动作 | 串口敲 `h` |
| 预期 | 打印出命令帮助（`RL-CAT STM32 shell`…） |
| 判据 | 能看到完整帮助文本 |

**⚠️ 如果乱码：** 99% 是波特率不对（工具没设成 1000000），或 USB-TTL 是 5V 电平。
**⚠️ 如果能收到但敲进去没反应：** 检查 PA10(RX) 是否接到 USB-TTL 的 TX。

```c
// 用这条命令看接收计数是否在动
动作：敲 s
看   ：pi_total 的值
```

| 项 | 内容 |
|---|---|
| 动作 | 敲任意几个字符，再敲 `s` |
| 预期 | `pi_total` 每次都比上次**大**（增量 = 你敲的字符数） |
| 判据 | 计数在涨 = RX 通路正常 |
| 关注 | `pi_overflow` 必须**保持 0**。不涨说明 512 B 环缓够用 |

---

### P2-5 三路 UART 自发自收 1 万字节无丢失 ⭐

**这是 P2 的门槛项**（固件设计书 §8 阶段 A 验收标准）。

| 项 | 内容 |
|---|---|
| 动作 | 串口敲 `p 10000` |
| 预期 | 固件会往 USART1 发 10000 个递增字节（0x00…0xFF 循环） |
| 判据 | PC 端收到 10000 字节，**无缺失、无错序** |

**做法（有 Python 的话最省事）：**

```python
# 把 COM 口改成你的
import serial, time
s = serial.Serial('COM3', 1000000, timeout=3)
s.reset_input_buffer()
s.write(b'p 10000\r')
data = s.read(10000)
print("got", len(data), "bytes")
expect = bytes(i & 0xFF for i in range(10000))
print("match:", data == expect)
# 如果 match=False，打印第一个不匹配的位置
if data != expect:
    for i,(a,b) in enumerate(zip(data, expect)):
        if a != b:
            print("first mismatch at", i, hex(a), hex(b)); break
```

**⚠️ USB-TTL 模块的注意点：** 很多 CH340/CP2102 模块在 1 Mbps 下会丢字节。
**丢字节时先换一个模块或换成 FT232 再判固件的问题** —— 别急着改固件。

**判据：**
```
□ 收到 10000 字节
□ 内容与期望序列完全一致
□ 固件侧 rx_overflow = 0（敲 s 看）
□ 固件侧 pi_errors    = 0
```

---

### P2-6 软件 I2C 总线电平与上拉 ⭐（不需要 IMU 就能查硬件）

| 项 | 内容 |
|---|---|
| 动作 | 串口敲 `i` |
| 预期 | `bus_released_high = 1`，且逐个探测 0x50 / 0x51 / 0x68 / 0x6A / 0x6B |
| 判据 | **`bus_released_high` 必须为 1** |

**⚠️ 这一条的价值：** `bus_released_high = 0` 说明 PB8/PB9 释放后没有被拉高
→ **外部 4.7 kΩ 上拉没装、或接错、或总线被拉死**。
这比"读不到 IMU 数据"要早得多、也明确得多。

| 现象 | 含义 | 处理 |
|---|---|---|
| `bus_released_high = 0` | 上拉缺失/短路 | 用万用表量 PB8、PB9 对 3.3V 的电阻，应为 4.7 kΩ |
| 有 ACK | IMU 在线且地址正确 | 把应答的那个地址记下来，P5 用 |
| 全部 no ack | IMU 没接好 / 地址不在这几个里 / 供电没上 | 查 JY901P 的 VCC 与 GND；查手册确认从机地址 |

**示波器项（有条件就做）：**

```
测点：PB8 (SCL)
动作：敲 i（会触发 I2C 访问）
看  ：SCL 频率
判据：100 ~ 400 kHz（固件设计书 §5.4 目标区间）
现状：BSP_I2C_HALF_US = 1 µs ⇒ 理论 ~500 kHz，实测因 GPIO/上拉会更低
调整：偏离区间时改 rlcat_config.h 附近的 bsp_softi2c.h 里的 BSP_I2C_HALF_US
```

---

### P2-7 Flash 标定页读写

| 项 | 内容 |
|---|---|
| 动作 ① | 初次上电后敲 `s` |
| 预期 ① | `loaded = 0`，`hdr : FF FF FF FF FF FF FF FF …`（整页擦除态） |
| 动作 ② | 敲 `e`（擦除） |
| 预期 ② | `erased`，`loaded` 仍为 0 |
| 判据 | `hdr` 全 FF = 页确实被擦干净了 |

**⚠️ 注意：** P2 阶段还没有"写标定"的命令 —— 写入要等 P6（标定流程）才有。
本阶段只验证**擦除与读取路径**通了。

**替代判据（没有串口时）：** 用 ST-Link 的调试器直接看 `0x0800FC00` 处的内存，
应为 `0xFF` 填满。

---

### P2-8 遥测统计合理性

| 项 | 内容 |
|---|---|
| 动作 | 敲 `s`，看 `servo_*` 与 `esp_*` 两组计数 |
| 预期 | 未接舵机控制板时 `servo_total` 应该**基本不涨**（总线静默）；`servo_overflow` 必须为 0 |
| 判据 | 悬空线不应该产生大量随机字节。若 `servo_total` 飞快上涨 → 有噪声/接地问题 |

**⚠️ 这一条能提前暴露"舵机总线接线错/地环路"的问题。**

---

### P2 验收结论表（请填写）

```
□ P2-1  LED + 心跳 1 Hz                         现象：____________
□ P2-2  时钟 72 MHz                             现象：____________
□ P2-3  DWT 可用                                现象：____________
□ P2-4  shell 收发 + pi_total 增长               现象：____________
□ P2-5 ⭐ 10000 字节自发自收无丢失               现象：____________
□ P2-6 ⭐ I2C bus_released_high = 1              现象：____________
□ P2-7  Flash 擦除 + hdr 全 FF                  现象：____________
□ P2-8  servo/esp 计数合理（无噪声）             现象：____________

不通过项的现象描述（越具体越好，附串口原始输出）：
____________________________________________________________
```

---

## P3 —— 舵机总线（servo_bus）

**本阶段验证：** 能否在真实总线上 Ping 到 12 个舵机、SyncWrite 12 个目标位置、SyncRead 12 份反馈。

### ⚠️ 开工前的三件事

```
① 舵机 ID 必须逐个改好（出厂默认都是 1，直接并接 12 个会全部冲突）
   用 Feetech 官方上位机：改一个 → 立刻拔掉 → 再接下一个
   目标 ID：逻辑索引 i → ID i+1
     索引 0..3  = lf_hip=1  lb_hip=2  rf_hip=3  rb_hip=4
     索引 4..7  = lf_thigh=5 lb_thigh=6 rf_thigh=7 rb_thigh=8
     索引 8..11 = lf_calf=9 lb_calf=10 rf_calf=11 rb_calf=12

② 舵机控制板跳线必须在【A 位】（A = UART 控制，B = USB 控制）

③ 接线是【直连】：PA2(TX) → 控制板 TX 端子、PA3(RX) → 控制板 RX 端子
   ⚠️ 控制板端子丝印是按 MCU 侧标注的，照丝印一对一接就是直连
   ⚠️ 与 USART1↔树莓派那条【交叉】接线不同，别搞混
```

### ⚠️ 安全（第一次上电务必这样做）

```
□ 机器人【吊起来】或【架空】，轮子不承重、腿能自由摆动
□ 3S 电池先不接舵机动力，只给控制板与 STM32 供电
   —— 先确认通信通了，再上舵机动力
□ 手边能随时拔掉动力线
```

---

### P3-1 总线 Ping（12 个 ID）⭐

| 项 | 内容 |
|---|---|
| 动作 | 串口敲 `A` |
| 预期 | 逐个打印 `id 1 -> ACK` … `id 12 -> ACK`，末尾 `found 12 / 12` |
| 判据 | **found = 12** |

**按现象定位问题：**

| 现象 | 最可能的原因 |
|---|---|
| `found 0`，全部 no response | ① 跳线不在 A 位 ② TX/RX 接反了（该直连却交叉了）③ 控制板没供电 ④ 没共地 |
| 只有 `id 1` 应答，其余全无 | **舵机 ID 没改**（12 个都是出厂 ID 1，同时接上就冲突） |
| 应答的 ID 与预期不符 | 改 ID 时记错了；固件侧只改 `RLCA_SERVO_ID(i)` 一个宏即可，逻辑不动 |
| 间歇性 ACK / 时好时坏 | 地环路、供电不足、或线太长；量一下逻辑地对电池负极的压差（应 < 50 mV） |

---

### P3-2 力矩卸载 / 使能

| 项 | 内容 |
|---|---|
| 动作 ① | 敲 `T 0` |
| 预期 ① | `torque OFF (all)`；**用手能轻松转动每个关节**（舵机变软） |
| 动作 ② | 敲 `T 1` |
| 预期 ② | `torque ON (all)`；**关节变硬、用手掰有明显阻力** |

**⚠️ 这一步必须先于任何控位动作** —— 力矩没使能时舵机不动，看起来会像"通信坏了"。

---

### P3-3 单关节控位 ⭐（验证方向与限幅）

| 项 | 内容 |
|---|---|
| 准备 | 敲 `T 1` 使能力矩 |
| 动作 | 敲 `P 8 0`（把逻辑索引 8 = `lf_calf` 写到步数 0） |
| 预期 | 该舵机移动到其编码器 0 位附近 |
| 再试 | `P 8 500`、`P 8 1000`，观察是否单调移动、方向是否与 URDF 正方向一致 |

**⚠️ 现在还没有标定，所以 `step` 是【编码器绝对位置】**，不是"相对站姿的角度"。
本步只验证"能控、能动、方向合理"，精确的角度对应关系要等 P6 标定。

| 判据 | 说明 |
|---|---|
| ✅ | 目标舵机动、其余不动 |
| ✅ | 给的步数变大时朝同一方向移动 |
| ❌ 现象：舵机嗡嗡响但不动 | 目标位置超出该舵机的机械/寄存器限位；换一个步数 |
| ❌ 现象：动了但方向与 URDF 相反 | **记下是哪个关节** —— 这就是 P6 要把 `RLCA_JOINT_DIR_INIT` 里对应项改成 `-1` 的依据 |

---

### P3-4 SyncWrite 12 个舵机同时动作 ⭐

| 项 | 内容 |
|---|---|
| 动作 | 敲 `F 2048 0` |
| 预期 | **12 个舵机同时**开始运动到 2048 附近（不是依次、不是有先有后） |
| 判据 | 同时性用肉眼判断；要量化就用示波器看信号线上的帧 |

**⚠️ 如果看到"依次动"**，说明帧被拆成了 12 条单机指令 —— 那是 `servo_bus_write_one` 的路径，
不是 `start_cycle` 的 SyncWrite 路径。检查 `P`/`F` 的用法区别。

**⚠️ 这一步会真的让 12 个舵机同时上电堵转电流**，务必确保电池能提供 ≥25 A 连续，
且舵机动力走 16 AWG 粗线直供（绕过控制板）。

---

### P3-5 SyncRead 反馈 + 统计 ⭐

| 项 | 内容 |
|---|---|
| 动作 | 等 1 秒，敲 `B` |
| 预期 | `state = 0`（空闲）、`ok_reads` 在稳定增长、`failed_reads`/`timeouts`/`crc_err` 保持很小 |
| 判据 | **连续跑 1 分钟，`crc_err` 与 `timeouts` 应该基本不涨** |

**关键字段解读：**

```
tx_frames     发出去的帧数（SyncWrite + SyncRead 各算一次）
rx_frames     成功解析的【舵机反馈帧】数（每轮正常是 12）
ok_reads      完整读回 12 帧的轮次  ← ⭐ 这个应该 ≈ tx_frames/2
failed_reads  没读全 12 帧的轮次
timeouts      整帧 3 ms 硬超时次数（应为 0）
idle_timeouts 靠"短暂静默"提前判结束的次数（正常情况会有，属正常）
crc_err       校验错（应为 0；不为 0 说明丢字节或噪声）
short         丢弃的杂散字节（正常为 0）
last_txn_us   上一轮事务耗时（预期 2000~3000 µs）
max_txn_us    最大事务耗时（预期 < 3000）
last_txn_us 必须 < 3000  ← ⭐ 验收 #12
```

**下面这行是最有信息量的：**

```
动作：敲 B
看  ：j0 id=1 pos=... spd=... load=... V=... T=... err=... V
判据：12 行末尾都应该是【V】（valid）
      pos 值应与你刚才 P/F 命令指定的步数接近
      V 列（电压，0.1 V 单位）应 ≈ 电池电压 × 10（例如 11.5 V → 115）
      T 列（温度）应接近室温
```

**⚠️ 若 `V=` 读数明显不对**（比如 0 或几百），说明反馈帧里的字节偏移理解错了 —— 把 `B` 的完整输出贴回来。

---

### P3-6 掉线恢复 ⭐（验收 #7）

| 项 | 内容 |
|---|---|
| 动作 ① | 保持 `B` 在跑，**热拔掉一个舵机的线** |
| 预期 ① | `failed_reads` 开始增长，`rx_frames` 每轮变 11；**其余 11 个舵机的 `V` 仍为 valid** |
| 动作 ② | 插回去 |
| 预期 ② | `failed_reads` 停止增长，`ok_reads` 恢复增长 |
| 判据 | **掉一个舵机不能让总线停摆**，也不能让 STM32 卡住 |

**⚠️ 关键点：** 拔掉一个舵机后，回复只有 11 帧。
固件用"短暂静默（200 µs）"判回复结束，所以**不需要等满 3 ms** 就能解析完 11 帧 ——
这也是 `partial round took xxxx us` 那类统计的意义。

---

### P3-7 总线断开（全部丢帧）⭐（验收 #8）

| 项 | 内容 |
|---|---|
| 动作 | **拔掉控制板的信号线**（或拔舵机总线），敲 `B` |
| 预期 | `timeouts` 开始增长；`last_txn_us ≈ 3000` 量级；`err_flags` 出现 BUS_TIMEOUT 位 |
| 判据 | **每一轮必须在 ~3 ms 内返回**，不能无限等 |

**⚠️ 这一条是官方库的致命缺陷所在**（伺服总线模块设计 §3 缺陷 1）：
官方 `readSC` 的超时是"字节间隔"，12 个舵机全失联会累计 6~12 ms，直接吃掉整个 10 ms 周期。
我们的实现是外层 3 ms 整帧硬超时。

**量化判据：**
```
□ last_txn_us ≤ 3200
□ max_txn_us  ≤ 3500
□   —— 超过就说明整帧超时没生效，必须回传
```

**⚠️ 还要看周期有没有被拖长：** 敲 `s` 看 `uptime_ms`，
让它跑 60 s，`uptime_ms` 应该涨 60000 左右（±1%）。若涨得慢很多，说明周期被阻塞了。

---

### P3-8 舵机错误码上报（验收 #9）

| 项 | 内容 |
|---|---|
| 动作 | 用手**按住/顶住**某个关节，让它憋住，然后敲 `T 1` + `P <j> <远处步数>`，观察 `B` |
| 预期 | 该舵机的 `err=` 变成非 0（过载/角度错误位），`err_accum` 增长 |
| 判据 | 错误码能被读出来并汇总上报 |

**⚠️ 不要长时间堵转**（过流 >2 A 持续 2 s 舵机会自己切断）。
顶 1~2 秒看到 `err` 非零就够了，然后立刻松开。

---

### P3-9 长时间稳定性（验收 #11）

| 项 | 内容 |
|---|---|
| 动作 | 让固件空跑 30 分钟（不接舵机动力也行，只跑总线事务） |
| 判据 | `timeouts`/`crc_err`/`short` 不出现单调增长；`uart_overflow` 保持 0 |

---

### P3 验收结论表（请填写）

```
□ P3-1 ⭐ Ping 12 个 ID          found = ___/12        现象：__________
□ P3-2    力矩卸载/使能                                 现象：__________
□ P3-3 ⭐ 单关节控位 + 方向                              现象：__________
          方向与 URDF 不一致的关节（如果有）：____________________
□ P3-4 ⭐ SyncWrite 12 个同时动作                        现象：__________
□ P3-5 ⭐ SyncRead 反馈 valid 全 1                       现象：__________
          last_txn_us = ______  max_txn_us = ______
□ P3-6 ⭐ 掉一个舵机，其余仍正常                         现象：__________
□ P3-7 ⭐ 总线断开 3 ms 内超时返回                       现象：__________
          last_txn_us（断开时）= ______
□ P3-8    舵机错误码可读                                现象：__________
□ P3-9    30 min 无累积错误                             现象：__________

不通过项的现象描述（附 B 命令的完整输出）：
____________________________________________________________
```

---

## P4 —— 与树莓派链路（link_pi）

**本阶段验证：** 100 Hz 双向收发、模型 A 的 4 ms 窗口、丢帧/错帧恢复、失联降级。

### ⚠️ 本阶段的两端准备

```
□ 固件侧：烧 firmware/stm32/build/stm32.hex
    ⚠️ shell 与协议帧可以共存于 USART1：
       shell 只吃可打印 ASCII，协议帧以 0xAA 开头，两者不会互相干扰。

□ PC 侧（先装依赖）：
    pip install pyserial
    只有装了这个才能跑串口模拟器；pi/selfcheck.py 不需要它。
```

---

### P4-1 协议一致性（不需要硬件）⭐

**这一步先证明"两端的字节布局是同一套"**，否则后面所有联调都在猜。

| 项 | 内容 |
|---|---|
| 动作 | 在项目根目录运行三条命令 |
| 命令 | `powershell -ExecutionPolicy Bypass -File firmware/tools/test-host.ps1`<br>`powershell -ExecutionPolicy Bypass -File firmware/tools/test-python.ps1` |
| 预期 | C 侧 4 个套件全绿（698 项）；Python 侧 2 个套件全绿（161 项） |
| 判据 | 全绿 |

**⚠️ 重点：`selfcheck.py` 里的期望字节与 `test_link_proto.c` 完全对应**
（TEL_FAST 的 86/88/90/92/94/95 偏移、CMD_JOINT 的 2/26/27/29 偏移）。
任一端改动而另一端没同步，这里立刻失败。

---

### P4-2 上行遥测能被 PC 收到 ⭐

| 项 | 内容 |
|---|---|
| 接线 | USART1：PA9→USB-TTL RX、PA10←USB-TTL TX、共地 |
| 动作 | `python pi/sim_esp32.py --port COM5 --seconds 10 --mode stand` |
| 预期 | 跑完后打印统计，`TEL_FAST` 计数 ≈ 1000（10 s × 100 Hz） |
| 判据 | **TEL_FAST > 900**，且 CRC 错 = 0 |

**按现象定位：**

| 现象 | 原因 |
|---|---|
| `TEL_FAST = 0` | ① 波特率不是 1000000 ② TX/RX 接反（这条是【交叉】接线）③ 没共地 |
| 计数只有一半左右 | 波特率不匹配（常见：工具默认 115200）或 USB-TTL 在 1 Mbps 下丢字节 |
| CRC 错很多 | 线太长/无屏蔽/地环路；或 USB-TTL 电平是 5V |
| `未知 TYPE` 很多 | 帧同步错位：检查固件是否真的在用 TEL_FAST（type=0x02） |

---

### P4-3 cycle_cnt 连续性（等价于"固件没丢周期"）⭐

| 项 | 内容 |
|---|---|
| 动作 | 同上，跑 30 s |
| 预期 | 报告里 `cycle_cnt 跳变` 接近 0 |
| 判据 | **丢帧总数 < TEL_FAST 总数的 1%** |

**⚠️ 这一项能区分两类问题：**
```
cycle_cnt 连续但 TEL_FAST 收得少  → 链路丢字节（物理层/上位机缓冲）
cycle_cnt 有跳变                  → 固件的 100 Hz 周期真的被吞了（固件问题）
```
> 协议 §4.4.1 设计 `cycle_cnt` 就是为了这个区分。

---

### P4-4 模型 A 的 4 ms 窗口 ⭐⭐（P4 最关键的一项）

| 项 | 内容 |
|---|---|
| 动作 | `python pi/sim_esp32.py --port COM5 --seconds 30 --mode active --verbose` |
| 预期 | 报告里打印"回复耗时"的 mean / P50 / P95 / P99 / max |
| 判据 | **P99 ≤ 4000 µs** |

模拟器会自动判定并打印：
```
✅ P99 xxxx us <= 4000 us —— 模型 A 可行
❌ P99 xxxx us > 4000 us —— 模型 A 不可行，需切模型 B
```

**看固件侧是否配合：**

| 项 | 内容 |
|---|---|
| 动作 | 跑模拟器的同时，另开一个串口终端敲 `L` |
| 预期 | `wait_timeouts` 保持很小（说明固件每次都在窗口内拿到指令） |
| 判据 | `wait_timeouts / cmd_joint` < 1% |

**⚠️ 若 PC 上 P99 就超 4 ms：**
先排除 PC 侧 Python 的 GIL/调度抖动（这跟 Pi 5 上的真实表现不同），
但**不能因此就认为没问题** —— 按 docs/33-firmware-plan.md §2① 的约定，
把 `RLCA_LINK_MODE_B` 改成 1 切到模型 B（代价是端到端延迟 +10 ms），
并把这个决定记进 ADR。

---

### P4-5 丢帧与错帧恢复（验收协议 §10 测试 4/5）⭐

| 项 | 内容 |
|---|---|
| 动作 | 跑模拟器时**中途拔掉 TX 线 1 秒再插回** |
| 预期 ① | 固件侧 `L` 的 `rx_timeouts` 增长（半帧超时复位），但**不卡死** |
| 预期 ② | 插回后 `rx_frames` 与 `cmd_joint` 恢复正常增长 |
| 预期 ③ | PC 侧 `接收超时` 增长，但链路自动恢复 |
| 判据 | **不需要复位固件**就能恢复 |

**⚠️ 这一条是协议 §6 容错③（整帧超时）的唯一真机验证机会。**
如果不能自动恢复，说明状态机卡在某个中间态 —— 必须回传。

---

### P4-6 失联降级与急停阈值 ⭐

| 项 | 内容 |
|---|---|
| 动作 ① | 让模拟器正常跑，然后 **Ctrl-C 停掉它**（固件不再收到任何指令） |
| 预期 ① | 30 ms 后 `STAT_LINK_OK` 位应清零 → TEL_STATUS 的 status 不再有 LINK_OK |
| 动作 ② | 保持 100 ms 不发指令 |
| 预期 ② | 固件侧 `link_pi_check_link()` 返回 2（应进入急停） |
| 判据 | 阈值准确：30 ms 是降级、100 ms 是急停 |

**怎么观察：**
```
① 停掉模拟器后，重新用串口终端敲 L
② 看 alive / lost_ms，以及 status 位
```
> ⚠️ **P4 阶段只上报状态位，不做"趴下"动作** ——
> 真正的保护动作在 P6 的 app_safety 里实现。
> 这一点负责人需要明确知情：**现在拔掉树莓派，机器人不会自己趴下。**

---

### P4-7 32 位 CRC 表与标准向量（两端一致）

| 项 | 内容 |
|---|---|
| 动作 | 两条测试命令（P4-1）已经覆盖 |
| 判据 | C 侧 `crc16("123456789") == 0x29B1`；Python 侧同一断言 |
| 说明 | 两端必须同源，否则每一帧都会被对方丢掉 |

---

### P4-8 1 万帧连续收发无误码（协议 §10 测试 9）

| 项 | 内容 |
|---|---|
| 动作 | `python pi/sim_esp32.py --port COM5 --seconds 100 --mode stand`（≈1 万帧） |
| 预期 | CRC 错 0、未知 TYPE 0、cycle_cnt 丢帧 < 1% |
| 判据 | 见上 |

**⚠️ 这项要 100 秒。可以只在最后联调时跑一次。**

---

### P4-9 固件侧资源占用没有恶化 ⭐

| 项 | 内容 |
|---|---|
| 动作 | 每次构建后看 `firmware/tools/build.ps1` 的输出 |
| 预期 | FLASH < 60 KB（当前 45.1%）、RAM < 18 KB（当前 27.6%） |
| 判据 | 构建脚本会在超预算时**直接把构建判失败** |

> 构建脚本内置了预算门禁：FLASH > 64 KB 或 RAM > 18 KB 就返回非 0。
> 所以"构建通过"本身就意味着资源还有余量。

---

### P4 验收结论表（请填写）

```
□ P4-1 ⭐ 两端协议一致性（C 698 项 / Py 161 项）        现象：__________
□ P4-2 ⭐ 上行 TEL_FAST 能被 PC 收到                     现象：__________
          TEL_FAST 计数 = ______ / 预期 ______
□ P4-3 ⭐ cycle_cnt 连续性                               现象：__________
          跳变 ______ 次，累计丢 ______ 帧
□ P4-4 ⭐⭐ 模型 A 的 4 ms 窗口
          P50 ______  P95 ______  P99 ______  max ______  (µs)
          固件侧 wait_timeouts = ______
□ P4-5 ⭐ 拔线 1 秒 → 自动恢复（不需复位）                现象：__________
□ P4-6    失联降级 30 ms / 急停 100 ms 阈值              现象：__________
          ⚠️ 确认已知：P4 阶段失联【不会】让机器人趴下
□ P4-7    CRC 标准向量两端一致                           现象：__________
□ P4-8    1 万帧连续收发无误码                           现象：__________
□ P4-9    资源占用 FLASH ______ / RAM ______            现象：__________

不通过项的现象描述（附模拟器的完整报告输出）：
____________________________________________________________
```

---

## P5 —— 传感器（IMU + 电池）

**本阶段验证：** JY901P 姿态能读对、电池电压准到 50 mV 以内、分级阈值正确。

### ✅ 本阶段的"未核实项"已关闭（2026-10-11）

```
早期状态：reference/ 里没有 JY901P 手册，所以 IMU 的寄存器映射是按
"WIT 标准 I2C 协议"的经验值猜的，【未经核实】。

现状：手册已到手（reference/JY901P_I2C协议.md），逐条核对 + 上机验证完毕。
      ⚠️ 结果查到 3 个真 bug —— 说明"猜"确实不可靠：
```

| # | 项 | 曾经的错 | 现在（已核实） |
|---|---|---|---|
| 1 | 器件 ID 寄存器 | 读 `0x00` | **`0x00` 是 SAVE（可写！）**；只读版本号在 **`0x2E`** |
| 2 | 角度换算 | `raw × 0.01°/LSB` | **`raw/32768 × 180°`**（原来的错了 1.83 倍） |
| 3 | ⭐ 字节序 | 按**大端**解析 | **实测是小端**（原来姿态全错、加速度模 15.6 g）|

**现在生效的映射**（`rlcat_config.h` §3b，全部已核实）：

```
RLCA_IMU_I2C_ADDR      0x50    7 位从机地址（手册 §IICADDR 默认 0x50）
RLCA_IMU_REG_VERSION   0x2E    VERSION，只读 16 位  ← 自检读这个，不校验固定值
RLCA_IMU_REG_ACC       0x34    AX/AY/AZ 各 16 位，连读 6 字节
RLCA_IMU_REG_GYRO      0x37    GX/GY/GZ 各 16 位，连读 6 字节
RLCA_IMU_REG_ANGLE     0x3D    Roll/Pitch/Yaw 各 16 位，连读 6 字节
RLCA_IMU_REG_QUAT      0x51    q0~q3（备用路径，模块已融合好）

⚠️ 字节序：【小端】（低字节在前）—— 手册没写，靠上机原始字节实测确定
⚠️ 量程：ACC ±16g、GYRO ±2000°/s、ANGLE 满量程 ±180°（与手册公式一致）
```

**⚠️ 两项必须在上位机设、固件改不了的：**

```
· 带宽   BANDWIDTH@0x1F = 2  （98Hz，上位机最高档）
· 回传速率 RRATE@0x03   = 9  （100Hz）
  ⚠️ 出厂默认 6 = 仅 10Hz，不改会让姿态观测呈阶梯状、策略会抖
  ⚠️ 面板里的"通讯速率"（4800）是【串口】波特率，I2C 用不到，不用改
```

**⭐ 排查姿态问题的正确姿势**：敲 `I` 看**原始字节**。
它会同时打印 `|BE:`（大端）与 `|LE:`（小端）两栏解释 ——
哪一栏数值合理，字节序就是哪种。只看换算后的数值区分不了
"地址错 / 字节序错 / 换算系数错"这三种病因。

---

### P5-1 IMU 能被探测到

| 项 | 内容 |
|---|---|
| 动作 | 串口敲 `i`（P2 就有的 I2C 自检） |
| 预期 | `bus_released_high = 1`，且 `probe 0x50 -> ACK` |
| 判据 | 0x50 应答 |

| 现象 | 原因 |
|---|---|
| `bus_released_high = 0` | 4.7 kΩ 上拉没装/接错（P2-6 已能查） |
| 0x50 无应答 | ① 从机地址不是 0x50（试 0x51/0x68/0x6A/0x6B）② IMU 没供电 ③ PB8/PB9 接反 |
| 有 ACK 但 `M` 全 0 | 地址对了但寄存器映射不对 → 见 P5-2 |

---

### P5-2 ✅ 寄存器映射核对（**2026-10-11 已通过**）

| 项 | 内容 |
|---|---|
| 准备 | 把机器人**水平静止**放好，**不要晃动**、不要手扶 |
| 动作 | 敲 `I`（看原始字节）再敲 `M`（看解析结果） |
| **关键判据** | `M` 最后一行 `gravity(body): ≈ 0.000 0.000 -1.000` |

#### ⚠️ 这一节的判据换过一轮（旧判据有两处是错的）

| 旧判据 | 为什么错 | 现在用什么 |
|---|---|---|
| `chip_id = 80`（0x50） | 固件原来读 `0x00` 当器件 ID，**而 0x00 是 SAVE**（可写，写它=重启/恢复出厂）。只读的版本号在 **`0x2E`**，且手册明说"不同产品版本号不一样" | 改看 **`I` 的 `VERSION (0x2E)`** 能否读到；**不校验固定值** |
| "**大端**解析对不对" | **实测是小端**。旧固件按大端解析，导致姿态全错、加速度模 15.6 g | 看 `I` 的 **`|BE:` 与 `|LE:` 两栏**，哪一栏数值合理就是哪种 |

**⭐ 用 `I` 的原始字节一次性定性三种病因：**

| 现象 | 结论 |
|---|---|
| `BE` 与 `LE` 差别巨大，且 `LE` 合理 | 字节序是**小端**（本例） |
| 原始值量级离谱（如 ACC 满量程） | 量程假设错，或寄存器地址错 |
| 原始值合理但换算结果不对 | 换算系数错 |

#### ✅ 实测通过的证据（2026-10-11）

```
IICADDR   (0x1A) = 50 00  -> LE 0x50      ✅ 从机地址
RRATE     (0x03) = 09 00  -> LE 9 = 100Hz ✅
BANDWIDTH (0x1F) = 02 00  -> LE 2 = 98Hz  ✅
ORIENT    (0x23) = 00 00  -> 水平安装      ✅
AXIS6     (0x24) = 00 00  -> 九轴          ✅

ACC   小端 -> (0.42, 0.16, 0.91) g, |a| = 1.013 g      ✅ 静止应为 ~1g
ANGLE 小端 -> roll +13.0°, pitch -16.5°                 ✅ 合理小角度

交叉验证（两条独立路径，必须一致）:
  加速度计推出的重力 = (-0.417, -0.154, -0.896)
  欧拉角推出的重力   = (-0.284, -0.216, -0.934)
  点积 = +0.988  ->  夹角 8.7°                          ✅ 一致
```

**⚠️ 那 8.7° 是正常的传感器融合偏差**（模块用陀螺积分 + 加计滤波），
不是错误。判据是"两条独立路径方向一致"，不是"逐位相同"。

#### ⚠️ 若 gravity 不是 (0,0,-1)，按这个表定位

| 现象 | 结论 | 怎么办 |
|---|---|---|
| `valid = 0`，`n_err` 一直涨 | I2C 读全失败 | 回到 P5-1 |
| `I` 的 `VERSION` 读不到 | I2C 不通（地址或接线） | 查 `i` 的 probe 与上拉 |
| `quat` 恒为 `1 0 0 0` | 角度寄存器读到全 0 | 查 `I` 的 `ANGLE` 原始字节 |
| gravity ≈ `(0, 0, +1)` | 符号反了 | 坐标系约定问题，**必须回传** |
| gravity ≈ `(0, ±1, 0)` | 轴映射不对 | 查 `I` 的 `ANGLE` 三轴顺序 |
| `BE` 与 `LE` 只有一栏合理 | 字节序 | 改 `imu_i16()` |
| `|acc|` ≈ 16 g | 量程假设错 | 查 `I` 的 `ACCRANGE` 与手册公式 |
| `n_spike` 持续增长 | 读到错位字节 | I2C 时序不稳（降 SCL 频率） |

#### ⚠️ 两项必须在上位机设（固件设不了）

```
① 带宽   BANDWIDTH@0x1F = 2  （98Hz，上位机最高档）
② 回传速率 RRATE@0x03   = 9  （100Hz）
   ⚠️ 出厂默认是 6 = 仅 10Hz；不改的话 100Hz 控制环会把同一份姿态读 10 次
⚠️ 面板里的"通讯速率"（4800）是【串口模式】的波特率，I2C 用不到，不用改
```

#### ⚠️ 两个遗留观察（不阻塞 P5-2，但值得跟）

| 项 | 现状 | 说明 |
|---|---|---|
| `RSW = 0x0008` | 只开了 ANGLE 输出 | 不影响固件（固件直接读寄存器）。但**开着 ACC/GYRO（改回 0x001E）能让你用 USB-TTL 接模块串口独立复现读数**，便于交叉验证 |
| `M` 的 `version` 显示 0 | 而 `I` 每次都能读到 `05 C1` | 逻辑上应显示 0xC105。**待重烧固件后复看**；若仍为 0 需深挖 |

### P5-3 I2C 时序实测（有条件就做）

| 项 | 内容 |
|---|---|
| 测点 | PB8（SCL） |
| 动作 | 敲 `M`（会触发 I2C 访问） |
| 判据 | **SCL 频率 100 ~ 400 kHz** |
| 现状 | `BSP_I2C_HALF_US = 1` ⇒ 理论 ~500 kHz，实测受 GPIO/上拉会更低 |
| 调法 | 偏离区间时改 `firmware/stm32/Core/Inc/bsp_softi2c.h` 的 `BSP_I2C_HALF_US`（值越大越慢） |

**⚠️ IMU 读一帧的耗时预算（固件设计书 §5.4）：**
```
读 acc(6) + gyro(6) + angle(8) = 20 数据字节，
加地址/寄存器/ACK 开销约 12 字节等效：
  @ 400 kHz ≈ 0.72 ms   ← 目标
  @ 100 kHz ≈ 2.9 ms    ← 占 10 ms 周期的 29%，偏多
```
**周期耗时怎么量：** 敲 `s` 看…（P5 还没有直接的周期耗时输出）
**替代判据：** 观察 `S`（心跳）是否仍然稳定 1 Hz；若明显变慢，说明 IMU 读占了太多时间。

---

### P5-4 ⭐ 电池电压标定（两步，必须做）

**第一步：量 3.3 V 实际值**

| 项 | 内容 |
|---|---|
| 动作 | 万用表量 STM32 模块的 3.3 V 引脚（对 GND） |
| 记录 | 实测值 = ________ mV（标称 3300，实际常 3260~3340） |
| 处理 | 若与 3300 差超过 20 mV，改 `rlcat_config.h` 的 `RLCA_ADC_VREF_MV` |

**第二步：对比电池电压**

| 项 | 内容 |
|---|---|
| 准备 | 接上 3S 电池（**舵机动力可以不接**，只给分压器供电） |
| 动作 ① | 万用表量**电池正负极**的实际电压，记 `V_meter` |
| 动作 ② | 串口敲 `V`，读 `mv_filtered`，记 `V_fw` |
| 判据 | **\|V_fw − V_meter\| < 50 mV** |

**不达标时怎么调：**

```
若 V_fw 系统性偏低/偏高一点 → 微调 rlcat_config.h 的 RLCA_BATT_DIV_NUM
   （默认 122.0，即 (100+22)；实际电阻有 1% 误差，可在 120~124 之间微调）
若偏差很大（> 200 mV）    → 先怀疑硬件：分压电阻值是否真是 100k/20k、
                             PA0 是否真的接到分压中点（docs/20-electronics.md §5 遗留项）
```

**⚠️ `adc_raw` 是对照标定的关键量**，`V` 命令会把它打出来。
一个健康的读数：电池 12.0 V 时 `adc_raw` 应约 2685（= 12.0 × 22/122 / 3.3 × 4095）。

---

### P5-5 ⭐ 分级阈值验证

| 项 | 内容 |
|---|---|
| 方法 A（推荐，安全） | 用可调直流电源代替电池，从 12.6 V 缓慢往下调 |
| 方法 B | 用真的 3S 电池放电到低于 10.5 V |

| 动作 | 预期 |
|---|---|
| 调到 10.6 V | `V` 的 `level = 0`（OK），`status_bits = 0` |
| 调到 **10.5 V** | `level = 1`（WARN），`status_bits = 16`（0x10） |
| 调到 **9.9 V** | `level = 2`（STOP），`status_bits = 48`（0x30） |
| 调到 **9.3 V** | `level = 3`（FORCE），`status_bits = 112`（0x70） |
| 调到 12.0 V | `level = 0`，`status_bits = 0`（恢复） |

**⚠️ 阈值语义是"≤ 触发"**，所以**恰好等于**阈值时必须触发（这一点有单测覆盖）。

**⚠️ P5 阶段只上报级别，不做任何动作** ——
L3 的"卸载力矩 → 趴下"在 P6 的 app_safety 里实现。
**这一点负责人需要明确知情：现在把电池拉到 9 V，机器人不会自己趴下。**

---

### P5-6 遥测里的姿态与电压

| 项 | 内容 |
|---|---|
| 动作 | `python pi/sim_esp32.py --port COM5 --seconds 10 --mode stand` |
| 预期 ① | 报告里 `电压 = xxxx mV` ≈ 万用表读数 |
| 预期 ② | `status` 的位标志里出现 **`READY,CALIBRATED,IMU_OK`**（如果已标定并且 IMU 在读） |
| 预期 ③ | 报告里最后几帧的 `quat` 随机身姿态变化（拿起来转一下再跑一次对比） |
| 判据 | 见上 |

**⚠️ 注意 `IMU_OK` 位**：它是 Pi 侧启动自检的硬条件
（`31-pi-runtime.md` §5.1 第④步）。**没有这个位，Pi 会拒绝进入 ACTIVE。**
这正是设计意图：没接 IMU 就别跑策略。

---

### P5-7 IMU 100 Hz 无丢帧（验收 固件设计书 §8 阶段 C）

| 项 | 内容 |
|---|---|
| 动作 | 让固件跑 5 分钟，期间每隔 30 s 敲一次 `M` |
| 预期 | `n_ok` 持续增长（每分钟约 6000 次）；`n_err` 与 `n_spike` 基本不涨 |
| 判据 | `n_err` 增长率 < 1% |

**⚠️ `n_ok` 每分钟只涨约 6000 而不是 60000** —— 因为 `imu_poll()` 是在
**100 Hz 控制周期里**调用的，不是主循环每圈都调。这是刻意的：
姿态只要 100 Hz，读太快纯属浪费总线时间。

---

### P5 验收结论表

```
✅ P5-1    IMU 能被探测到（0x50 ACK）
          bus_released_high = 1，probe 0x50 -> ACK              【已通过 2026-10-11】
✅ P5-2 ⭐⭐ 寄存器映射核对
          ⚠️ 判据已更新：不再看 chip_id（0x00 是 SAVE，不是器件 ID），
             改看 I 的 VERSION(0x2E) 能否读到（不校验固定值）
          IICADDR = 0x50   RRATE = 9(100Hz)   BANDWIDTH = 2(98Hz)
          ACC 小端 |a| = 1.013 g          （静止应 ~1g）
          ANGLE 小端 roll = +13.0 deg  pitch = -16.5 deg   （倾斜放置）
          加计推出重力 vs 欧拉角推出重力 夹角 = 8.7 deg   （应一致）
          待补：水平静止时的 gravity(body) = (______, ______, ______)  want (0,0,-1)
          待补：倾 90° 后 gravity = (______, ______, ______)
          待补：绕竖直轴转 90° 后 gravity 是否不变：是 / 否
          待补：n_spike 增长情况：__________
□ P5-3    SCL 实测频率 = ______ kHz（目标 100~400）       现象：__________
□ P5-4 ⭐  电池标定
          3.3V 实测 = ______ mV（固件里填的是 ______ mV）
          V_meter = ______ mV   V_fw = ______ mV   误差 = ______ mV（<50）
□ P5-5 ⭐  分级阈值 10.5 / 9.9 / 9.3 V 逐点触发           现象：__________
          ⚠️ 已知：P5 阶段低于阈值【不会】让机器人趴下
□ P5-6    遥测里能看到电压与姿态、status 含 IMU_OK        现象：__________
□ P5-7    IMU 5 分钟无丢帧（n_err < 1%）                 现象：__________

⚠️ 两个遗留观察（不阻塞 P5-2，但值得跟）：
   · RSW = 0x0008（只开了 ANGLE 输出）—— 不影响固件，
     但改回默认 0x001E 后可用模块串口独立复现读数做交叉验证
   · M 的 version 显示 0，而 I 每次都能读到 05 C1（应显示 0xC105）
     -> 待重烧固件后复看；若仍为 0 需深挖

不通过项的现象描述（附 I / M / V 命令的完整输出）：
____________________________________________________________
```

---

---

## P6 —— 关节标定 + 模式状态机 + 安全保护

**本阶段验证：** 标定能不能真的算出 offset/dir、模式能不能正确切换、
**⭐ 安全保护能不能在【拔掉树莓派】的情况下自己让机器人停下来。**

### ⚠️ 本阶段是"安全"的落地阶段，请按这个顺序做

```
① P6-1 先确认模式状态机（不发任何运动指令）
② P6-2 标定（机器人会动，幅度约 0.15 rad）
③ P6-3 安全触发逐项验证 ← ⭐ 本阶段最重要的部分
④ P6-4 缓慢趴下
⑤ P6-5 安全链路自检（拔掉树莓派）
```

### ⚠️ 安全前提（每一步都要遵守）

```
□ 机器人【吊起来或架空】，腿能自由摆动且不会砸到东西
□ 3S 电池能提供 ≥25 A；舵机动力走 16 AWG 粗线
□ 手边能随时拔掉动力线
□ 做 P6-3 的电压项时，用可调直流电源而不是真电池（要拉到 9.3 V 以下）
```

---

### P6-1 模式状态机 ⭐（不产生运动，先做这个）

| 项 | 内容 |
|---|---|
| 动作 | 敲 `R` |
| 预期 | 打印 `mode_requested` / `mode_active` / `torque_on` / `active_block` / `safety_*` / `calib_*` |

**逐个模式试一遍：**

| 动作 | 预期（看 `R` 的 `mode_active` 与 `torque_on`） |
|---|---|
| 敲 `N idle` | `mode_active = 0`，`torque_on = 0`（**关节可以用手轻松转动**） |
| 敲 `N stand` | `mode_active = 1`，`torque_on = 1`（**关节变硬，保持在站姿**） |
| 敲 `N damp` | `mode_active = 3`，`torque_on = 0`（关节软下去） |
| 敲 `N active` | ⚠️ **现在应该进不去**：`mode_active` 会停在 `1`（STAND） |

**⭐ 最关键的一条：`active_block` 必须解释"为什么进不了 ACTIVE"**

```
0 = 通过          1 = 未标定          2 = 链路不活
3 = IMU 不可用    4 = 安全层禁止      5 = 舵机反馈不新鲜
```

| 现象 | 含义 | 处理 |
|---|---|---|
| `active_block = 1` | 没标定 | 做 P6-2 |
| `active_block = 2` | 树莓派没连着/没发指令 | 正常（PC 上没 Pi）。跑 `python pi/sim_esp32.py` 就会有链路 |
| `active_block = 3` | IMU 不可用 | 回到 P5-1/P5-2 |
| `active_block = 5` | 舵机反馈读不全 | 回到 P3-5，看 `ok_reads` 是否在涨 |

**⚠️ ACTIVE 的设计意图就是"条件不满足就降级到 STAND，而不是掉到 IDLE"。**
站着比瘫着安全，而且操作者一眼能看出"力矩还在"。

---

### P6-2 ⭐ 关节标定

#### 方式 A（推荐先用）：手动零点

| 项 | 内容 |
|---|---|
| 准备 | 敲 `N idle` 卸力矩，**用手把机器人摆成装配好的弯腿站姿**（与 URDF 的 q=0 一致） |
| 动作 | 扶稳后敲 `C zero` |
| 预期 | `manual zero recorded from current positions` |
| 再敲 | `R` 看 12 行的 `off=` 值 |

**判据：**
```
□ 12 个 off= 值各不相同（完全相同说明读的是同一个舵机 → ID 有冲突）
□ off= 值在 0~4095 之间
□ 重新上电后敲 R，flash_loaded = 1，off= 值不变 ← 证明落盘成功
```

**⚠️ `C zero` 只定 offset，`dir` 保持默认（全 +1）。**
接着做方式 B 才能把方向测出来。

#### 方式 B：全自动（测方向）

| 项 | 内容 |
|---|---|
| 准备 | 机器人架空；清场，**每个关节会动约 0.15 rad** |
| 动作 | 敲 `C start` |
| 预期 | `calibration started (~10 s)`；约 10 s 后敲 `R`，`calib_state = 8`（DONE）、`calib_err = 0` |
| 判据 | 见下 |

**标定状态码（`R` 里的 `calib_state`）：**
```
0 IDLE  1 UNLOAD  2 SETTLE  3 SAMPLE  4 DIR_TEST
5 DIR_SETTLE  6 FINAL_READ  7 VERIFY  8 DONE  9 FAILED
```

**失败码（`calib_err`）：**
```
0 无错   1 读位置失败   2 写位置失败
3 舵机没动（力矩没使能/机械卡死）   4 位移太小，方向判不出   5 结果超出合理范围
```

| `calib_err` | 含义与处理 |
|---|---|
| 1 | 读位置失败 → 回到 P3-5 看反馈是否稳定 |
| 3 | **舵机没动** → 力矩没使能（查 12V 动力、`T 1`）、或机械卡死 |
| 4 | 位移太小 → 该关节阻力大/被限位挡着；确认它是自由的 |
| 5 | 结果不合法 → 把 `R` 的输出贴回来 |

**⭐ 标定成功的判据：**

```
□ calib_state = 8（DONE）、calib_err = 0
□ R 的 12 行 dir= 与【物理现实】一致：
    用手把某个关节往正方向推（关节角增大），读 R 的 off= 应该
      · dir=+1 → off 增大
      · dir=-1 → off 减小
  ⚠️ 这是"dir 到底对不对"的唯一真判据 ——
     如果反了，机器人会朝指令的反方向走，非常危险。
□ 重新上电后 flash_loaded = 1，off/dir 都被保留
```

---

### P6-3 ⭐⭐ 安全触发逐项验证（本阶段最重要）

**每一项只验证一个触发条件。**

#### ① 链路失联 → 100 ms 后趴下 ⭐（核心要求）

| 项 | 内容 |
|---|---|
| 准备 | PC 上跑 `python pi/sim_esp32.py --port COM5 --seconds 60 --mode stand`，让链路活起来 |
| 动作 | **Ctrl-C 停掉模拟器**（树莓派不再发任何指令） |
| 预期 ① | 30 ms 后：`safety_severity = 2`、`safety_reasons` 含 `LINK_LOST` |
| 预期 ② | 100 ms 后：`safety_severity = 3`、`sitdown_active = 1`，**机器人开始缓慢趴下** |
| 预期 ③ | 趴到位后：`sitdown_done = 1`、`sitdown_torque_off = 1`、`torque_on = 0` |
| 判据 | **全程不需要 PC 参与** —— 这正是"安全保护不依赖上位机"的证明 |

**⚠️ 这一条是 P6 的门槛项。不通过就不能上真机。**

#### ② 电池 L3（≤9.3 V）→ 强制趴下

| 项 | 内容 |
|---|---|
| 准备 | 用可调直流电源代替电池；先 `N stand` |
| 动作 | 从 12.0 V 缓慢往下调到 9.3 V |
| 预期 | 到 9.3 V 时 `safety_reasons` 出现 `VOLT_FORCE`，`severity = 3`，开始趴下 |
| 判据 | 阈值精确（9.4 V 不该触发） |

#### ③ 电池 L2（≤9.9 V）→ 只限幅，不趴下

| 项 | 内容 |
|---|---|
| 动作 | 调到 9.9 V |
| 预期 | `severity = 2`、`amp_scale_x100 = 50`（限幅到 50%）、**不趴下** |
| 判据 | `sitdown_active = 0` |

#### ④ 电池 L1（≤10.5 V）→ 只告警

| 项 | 内容 |
|---|---|
| 动作 | 调到 10.5 V |
| 预期 | `severity = 1`、`amp_scale_x100 = 100`、不趴下 |
| 判据 | 见上 |

#### ⑤ 舵机过温（>70 °C）→ 强制趴下

| 项 | 内容 |
|---|---|
| 动作 | 把某个舵机加热到 70 °C 以上（**或**轻堵转 1~2 秒让它自己升温） |
| 预期 | `servo_max_temp > 70`、`safety_reasons` 含 `OVERTEMP`、`severity = 3`、趴下 |
| 判据 | 见上 |
| ⚠️ | **不要长时间堵转**（过流 >2 A 持续 2 s 舵机自己会切断） |

#### ⑥ IMU 失效 → 禁 ACTIVE，但**不**趴下

| 项 | 内容 |
|---|---|
| 动作 | 拔掉 IMU 的 SDA 或 SCL |
| 预期 | `safety_reasons` 含 `IMU_STALE`、`blocks_active = 1`、`active_block = 3` |
| 判据 | **`sitdown_active` 必须为 0** —— IMU 坏了不该让机器人瘫倒 |

**⚠️ 这一条体现的是"分级"的设计意图：**
"姿态不可信"该拦的是"别跑策略"，而不是"现在就趴下"。
把它当急停会让"IMU 线松了"变成"机器人趴下"，既危险又掩盖真问题。

#### ⑦ 急停后能恢复

| 项 | 内容 |
|---|---|
| 动作 | 把原因修好（插回 IMU / 电压调回 12 V / 重跑模拟器），然后敲 `N stand` |
| 预期 | `severity` 回到 0、`torque_on = 1`，机器人重新站起来 |
| 判据 | **不需要复位固件** |

---

### P6-4 ⭐ 缓慢趴下（不是"直接断电"）

| 项 | 内容 |
|---|---|
| 目的 | 验证"趴下是插值下去的，不是砸下去的" |
| 动作 | 触发一次急停（例如停掉模拟器），**用手机录像** |
| 预期 | 机器人以稳定速度把腿收起来、机身下降；**录像里能看到明显的中间姿态**，约 2~3 s 到位 |
| 判据 | 不是"瞬间掉下去" |

**⚠️ 对照设计意图：** 直接卸力矩会让 1.386 kg 的机身从 133 mm 砸下，
可能摔坏舵机或结构。所以宁可多花 2~3 秒。

**⚠️ 独立兜底验证（重要）：**

| 项 | 内容 |
|---|---|
| 动作 | 把舵机动力**断掉**（保留 STM32 供电），然后触发急停 |
| 预期 | 舵机不动（没动力），但 `sitdown_torque_off` 必须在 **4 s 内**变成 1 |
| 判据 | **绝不允许"因为趴不下去就一直硬撑着使能"** |

---

### P6-5 安全链路自检（拔掉树莓派）

**这是把 P6-1~P6-4 合起来的一次端到端验证。**

```
□ 1. 上电，N stand，机器人站住
□ 2. 树莓派（或模拟器）在跑，链路活
□ 3. 直接【拔掉树莓派的串口线】（模拟上位机崩溃）
□ 4. 目视：100 ms 后机器人开始缓慢趴下，2~3 s 后趴平、力矩卸掉
□ 5. 敲 R：safety_reasons 含 LINK_LOST，sitdown_done = 1，torque_on = 0
□ 6. 插回串口线，重跑模拟器
□ 7. 敲 N stand：机器人重新站起来
```

**⚠️ 第 4 步全程不需要任何上位机参与 —— 这是本项目最重要的设计要求的验收。**

---

### P6-6 资源占用复核

| 项 | 内容 |
|---|---|
| 动作 | 看每次构建的输出 |
| 现状 | FLASH **42696 / 65536 B（65.1%）**、RAM **6304 / 20480 B（30.8%）** |
| 判据 | 构建脚本内置门禁：FLASH > 64 KB 或 RAM > 18 KB 直接判失败 |

**⚠️ Flash 已用到 65%。** 若 P7 逼近上限，第一步该砍的是 shell
（把 `RLCA_SHELL_EN` 置 0）—— 它占了不少字符串常量。

---

### P6 验收结论表（请填写）

```
□ P6-1 ⭐ 模式状态机 + active_block 解释        mode_active = ___  torque_on = ___
□ P6-2 ⭐ 标定
          A（C zero）：off= 各异：是/否   落盘后保留：是/否
          B（C start）：calib_state = ___   calib_err = ___
          ⭐ 手工核对 dir 与物理方向：一致 / 不一致
          不一致的关节：____________________
□ P6-3 ⭐⭐ 安全触发逐项
          ① 停掉树莓派 → 100 ms 后趴下        现象：__________
          ② ≤9.3 V → 强制趴下                 现象：__________
          ③ ≤9.9 V → 限幅 50%，不趴下          现象：__________
          ④ ≤10.5 V → 仅告警                  现象：__________
          ⑤ >70 °C → 强制趴下                 现象：__________
          ⑥ IMU 失效 → 禁 ACTIVE，不趴下       现象：__________
          ⑦ 修复后能恢复（不需复位）           现象：__________
□ P6-4 ⭐ 缓慢趴下（录像里有中间姿态）          现象：__________
          独立兜底：断动力后 4 s 内 torque_off：是/否
□ P6-5 ⭐⭐ 拔串口线端到端自检                 现象：__________
□ P6-6    资源 FLASH ______ / 65536   RAM ______ / 20480

不通过项的现象描述（附 R 命令的完整输出）：
____________________________________________________________
```

---

**文档结束。P7 验收单在 P6 通过后追加。**
