vrrrrs/RL-CAT/docs/51-opensource-plan.md

# 51 · 开源执行方案

> **状态：** 方案待评审，**尚未执行任何一步**。
> **日期：** 2026-10-18
> **适用范围：** 把当前仓库（377 跟踪文件 / 8.9 MB）整理成可公开发布的开源项目。

---

## 0 · 先给判断

### 0.1 这个项目值得开源，但卖点不是"算法"

| 卖点 | 稀缺性 | 说明 |
|---|---|---|
| **完整闭环** | 🔴 高 | 机械 + 电子 + 固件 + 树莓派 + 强化学习，**一条链全开源**的四足项目很少 |
| **25 个坑的根因分析**（`docs/49`） | 🔴 **很高** | 绝大多数开源项目只有"怎么用"，**没有"我们踩了什么、为什么"** |
| **可量化的验收方法**（`stand_test.py` 4 项指标） | 🟡 中 | "站住了"变成"到位 1.23°、漂移 0.00°"，比"能站稳"有说服力 |
| **1370 项无硬件测试** | 🟡 中 | 别人能 `run_checks.sh` 立刻验证，降低参与门槛 |
| 算法新颖性 | ⬜ 无 | 用的是 PPO + 标准 legged_gym 流程 |

**⇒ 定位建议：** **"一个完整、可复现、且诚实地记录了失败的四足机器人平台"**，而不是"一个新算法"。

### 0.2 三个阻塞项（不解决不能发）

| # | 阻塞项 | 严重性 |
|---|---|---|
| **B1** | **许可与第三方边界**没说清（legged_gym BSD-3 / isaacgym 专有 / 厂商 SDK） | 🔴 法律风险 |
| **B2** | **硬编码的个人环境**：`~/` 30+ 处、`C:\Users\<user name>\` 16+ 处 | 🔴 **别人 clone 下来跑不起来** |
| **B3** | **默认口令 / 个人信息**：AP 密码 `rlcat1234`、SSH 私钥路径 | 🟡 安全 |

**⚠️ B2 比 B3 更重要** —— 隐私只影响自己，**路径写死会让项目"看起来能跑、实际跑不了"，这是开源项目最常见的死因。**

---

## 1 · 许可选择（**需要你决定**）

### 1.1 三层许可（推荐组合）

| 层 | 推荐 | 备选 |
|---|---|---|
| **代码**（固件 / Pi / 训练脚本） | **Apache-2.0** | MIT（更宽松）/ GPL-3.0（更严格） |
| **硬件**（CAD / 电路 / URDF） | **CERN-OHL-S-2.0** | CERN-OHL-W（弱互惠）/ CC-BY-SA-4.0 |
| **文档** | **CC-BY-4.0** | CC-BY-SA-4.0 |

### 1.2 我的推荐理由

**代码选 Apache-2.0 而不是 MIT：**
- 多了**显式专利授权**和**专利报复条款** —— 机器人涉及舵机控制、步态，可能被别人申请专利
- 要求标注修改 —— 对"fork 后声称是自己做的"有一定约束
- 仍然允许商业使用（降低企业用户顾虑）

**⇒ 如果你更想要"最大传播"，选 MIT；如果担心"被人拿去申请专利再告你"，选 Apache-2.0。**

**硬件选 CERN-OHL-S：**
- 专为开源硬件写的，**明确覆盖"制造"这个行为**（CC 系列对硬件是模糊的）
- `-S`（强互惠）= 别人改了设计必须同样开源；`-W`（弱）= 只要求文件层面
- **⚠️ 如果你希望别人能做商业产品（卖机器人），选 `-W` 或 CC-BY-SA**

### 1.3 ⚠️ 第三方边界（**必须写进 NOTICE**）

| 组件 | 许可 | 我们怎么处理 |
|---|---|---|
| **legged_gym**（`Sim/legged_gym`） | 见其 `LICENSE`（BSD-3 系） | **保留原 LICENSE 与版权头**，在 NOTICE 里声明是衍生作品 |
| **Isaac Gym** | 🔴 **NVIDIA 专有 EULA，不可再分发** | **只 `import`，不复制**；README 明确要求用户自行向 NVIDIA 申请 |
| **STM32 HAL/CMSIS** | BSD-3（ST） | 已 `.gitignore`；README 说明用 CubeMX 重新生成 |
| **WitMotion SDK**（`reference/`） | 🔴 厂商资料 | 已 `.gitignore`，**永不发布** |
| **Waveshare / Feetech 资料** | 厂商 | 同上 |
| **Isaac Gym 示例资产**（`anymal_b` 等 mesh） | NVIDIA 资产 | 已 `.gitignore` |

**⚠️ 一条底线：不发布任何"别人没授权我们再分发"的二进制。**

---

## 2 · 清场（P0，阻塞项）

### 2.1 B2 · 硬编码路径（**优先做，因为它影响可用性**）

**现状：**

| 位置 | 问题 | 数量 |
|---|---|---|
| `Sim/RL/scripts/*.py` | `ASSET_ROOT = "$RLCAT_ROOT/urdf"` 等 | 10 个脚本 |
| `Sim/RL/scripts/env.sh` | `export RLCAT_ROOT="$RLCAT_ROOT"` | 1 |
| `Sim/RL/*.md` | 文档里全是 `~/...` 的 `cd` 命令 | 5 份 |
| `pi/*.md` | SSH 私钥绝对路径、`pi@169.254.100.2` | 3 份 |
| `firmware/esp32/*` | `C:\Users\<user name>\...`（说明 SUBST 绕过的原因） | 3 处 |
| `docs/36,38,42,90` | 同上 | 4 份 |

**处理方式：**

```
① 脚本改为"从环境变量读，缺省用相对路径"
     env.sh:  export RLCAT_ROOT="${RLCAT_ROOT:-$(cd "$(dirname "$0")/.." && pwd)}"
     脚本:    ASSET_ROOT = os.environ.get("RLCAT_URDF", os.path.join(ROOT, "urdf"))

② 文档里的绝对路径改成占位符
     $RLCAT_ROOT        →  $RLCAT_ROOT
     C:\Users\<user name>\...      →  <repo>
     ~/RL-CAT/pi         →  ~/RL-CAT/pi

③ 保留"为什么这么做"的解释（SUBST 绕过空格等），只去掉个人信息
     ⇒ 这些解释是本项目有价值的工程内容，不要删
```

### 2.2 B3 · 口令与个人信息

| 项 | 处理 |
|---|---|
| `RLCA_AP_PASSWORD "rlcat1234"` | 改为构建期可覆盖的弱默认，README 第一条警告"**改掉它**" |
| SSH 私钥路径（`pi/开发方式.md`） | 改成 `<your-key>` 占位 |
| 真实姓名 `<name>` | 🟡 **建议保留**（作者署名，开源项目正常）—— 但**桌面路径要改** |
| `169.254.100.2` | ✅ 保留（是配置示例，不是秘密） |
| `MDK-ARM/_quarantine/`、`startup_*.lst` | **不进 git**（含 Keil 本地绝对路径，且是构建产物） |

### 2.3 清场后的验收

```bash
# 这三个必须全部为空
git grep -n "C:\\\\Users"      -- ':!docs/49*'
git grep -n "/home/<user>"
git grep -n "rlcat1234"
```

---

## 3 · 仓库结构重构（P1）

### 3.1 现状问题

**当前是"个人工作区"结构：**

```
docs/          ← 好
firmware/      ← 好
hardware/      ← CAD 274 MB（不进 git）
pi/            ← 名字太随意，公共项目建议 software/ 或 raspberry_pi/
reference/     ← 厂商资料（不进 git）
Sim/           ← 大小写混用，且混了 scripts/ logs/ urdf/
archive/       ← 早期文档（对公共项目价值低）
```

### 3.2 建议的目标结构

```
RL-CAT/
├── README.md              ⭐ 英文为主 + 中文入口
├── README.zh-CN.md
├── LICENSE                (Apache-2.0)
├── LICENSE-hardware       (CERN-OHL-S)
├── LICENSE-docs           (CC-BY-4.0)
├── NOTICE                 ⚠️ 第三方组件声明（见 §1.3）
├── CONTRIBUTING.md
├── CITATION.cff
├── CHANGELOG.md
├── .github/
│   ├── workflows/ci.yml
│   ├── ISSUE_TEMPLATE/{bug,feature,question}.yml
│   └── PULL_REQUEST_TEMPLATE.md
│
├── docs/                  ← 保持现状（25 份），但：
│   ├── 00-overview.md
│   ├── ...
│   ├── 49-progress-review.md   ⭐ 项目的核心竞争力
│   └── pictures/          ← ⚠️ 新增：照片/框图/GIF
│
├── firmware/
│   ├── stm32/             (Core/ + tests/ + MDK-ARM 工程)
│   ├── esp32/             (src/ include/ test/ + platformio.ini)
│   └── tools/             (构建脚本)
│
├── software/              ← 原 pi/（改名，公共项目更清晰）
│   ├── rlcat_proto.py ... stand_test.py
│   ├── models/            (policy npz/onnx，400 KB)
│   ├── tests/
│   └── run_checks.sh
│
├── hardware/
│   ├── mechanical/
│   │   ├── URDF/          ⭐ URDF + STL（0.6 MB，进 git）
│   │   └── step/          ⚠️ STEP 导出（约 60 MB，进 Release 不进 git）
│   ├── electronics/       (原理图/PCB)
│   └── BOM.csv            ⚠️ 新增：物料清单
│
├── simulation/            ← 原 Sim/
│   ├── legged_gym/        (legged_gym + 我们的 rlcat env)
│   ├── rlcat/             (URDF 资源)
│   ├── scripts/           ⚠️ 已改为环境变量驱动
│   └── docs/              (训练报告、指南)
│
└── archive/               🟡 可选：早期方案（建议保留，见证演进）
```

**⚠️ 重命名 `pi/` → `software/` 会让所有文档里的路径失效** —— 要么一次性全改，要么**保留 `pi/`**。
**⇒ 我的建议：保留 `pi/`**（改动面太大，收益只是名字好看），**在 README 里解释"pi = 树莓派侧软件"**。

---

## 4 · 必须新增的文件（P1）

### 4.1 `README.md`（**决定 90% 的 star**）

**必需内容（按顺序）：**

```markdown
1. 一句话是什么 + 一张动图/GIF（⭐ 最重要，3 秒内决定别人要不要看）
2. 当前状态表（诚实）
     ✅ M1 地面站立（到位 1.23°、漂移 0.00°）
     🟡 行走策略训练中
     ⚠️ sim2real 尚未达到可用水平
3. 硬件规格（12 DOF、STM32F103、树莓派 5、ESP32-C3、380 mm 机身）
4. 架构图（一张 SVG/PNG）
5. 快速开始（三条命令）
     cd pi && ./run_checks.sh      # 无需硬件，1370 项
6. 目录说明（每个顶层目录一句话）
7. 复现路径（怎么从零到能站）
8. ⚠️ 已知限制（诚实列出 G1/G2）
9. 许可证与致谢
```

**⚠️ 反模式（要避免）：**
- 开头就讲"强化学习原理" → 读者想看的是"这东西能干嘛"
- 没有图 → 机器人项目没图等于不存在
- 夸大（"实现了自主行走"）→ 一旦被发现走不了，声誉损失远大于收益

### 4.2 其他必需文件

| 文件 | 作用 | 工作量 |
|---|---|---|
| `LICENSE` ×3 | 法律基础 | 10 分钟 |
| `NOTICE` | 第三方声明 | 30 分钟 |
| `CONTRIBUTING.md` | 怎么跑测试、提 PR 的规矩 | 1 小时 |
| `CITATION.cff` | 让论文能引用 | 20 分钟 |
| `CHANGELOG.md` | 从 `v0.1-m1-pass` 起 | 20 分钟 |
| `.github/workflows/ci.yml` | 自动跑 1370 项测试 | 1-2 小时 |
| `.github/ISSUE_TEMPLATE/*` | 减少无效 issue | 30 分钟 |
| `hardware/BOM.csv` | 别人能照着买 | 半天（要查价） |

---

## 5 · CI 方案（本项目的隐藏优势）

**⚠️ 很多机器人项目没法做 CI，因为依赖硬件。这个项目可以：**

| 测试 | 能否无硬件跑 | CI 命令 |
|---|---|---|
| 固件主机单测（7 套 1370 项） | ✅ | `gcc` 编译 + 运行 |
| Pi 侧 `run_checks.sh` | ✅ | `python3` 即可 |
| 策略对拍（`rl_policy.py --selftest`） | ✅ | 纯 numpy |
| 固件构建 | 🟡 | `arm-none-eabi-gcc` + 转 Makefile（现在只支持 Keil） |
| 训练环境 | ❌ | 需要 Isaac Gym（专有，CI 跑不了） |

**建议的 `ci.yml`：**

```yaml
jobs:
  host-tests:      # Ubuntu + gcc：firmware/tests 7 套
  pi-tests:        # Ubuntu + python3：pi/run_checks.sh
  policy-verify:   # 策略对拍仿真轨迹（验证观测布局没被改坏）
```

**⚠️ `policy-verify` 这一项特别有价值** —— 它保证"任何人都不会误改观测布局而不自知"。

**⚠️ 要补一个 Makefile 或 CMake 才能让固件在 CI 里构建**（现在只有 Keil 工程）。这是一个**中等工作量**（半天）但有长期收益的改动。

---

## 6 · 展示材料（P2，决定传播量）

| 材料 | 优先级 | 说明 |
|---|---|---|
| **站立视频 / GIF** | 🔴 **必须** | 5~10 秒，机器人站住不倒。GIF < 5 MB 放 README |
| 机器人照片 | 🔴 必须 | 正面 45°、有背景，不要纯白 |
| 架构图 | 🔴 必须 | 三个 MCU/SoC 的分工 + 数据流 |
| 关节坐标图 | 🟡 重要 | 12 关节编号 + 正方向（别人最容易搞错的） |
| 参数表 | 🟡 重要 | 质量、机身尺寸、舵机型号、电池 |
| 训练曲线 | 🟢 可选 | 9 轮调参的对比图 |

**⚠️ 视频必须诚实：** 如果只能吊着站，就拍吊着的；**不要剪成"看起来在走"**。

---

## 7 · 分阶段执行计划

### P0 · 清场（**阻塞项，1~2 天**）

| 步骤 | 产出 | 验收 |
|---|---|---|
| P0-1 | 脚本改用环境变量 + 相对路径 | `grep -r "/home/<user>" simulation/` 为空 |
| P0-2 | 文档路径占位符化 | `git grep "C:\\\\Users"` 只剩说明性引用 |
| P0-3 | AP 密码改为可覆盖 + README 警告 | `grep -r "rlcat1234"` 只剩注释 |
| P0-4 | 移除 `MDK-ARM/_quarantine`、`*.lst` | `git ls-files` 不含 |
| P0-5 | 新建干净仓库（**不带历史**，避免残留） | `git log` 只有 1 个提交 |

**⚠️ P0-5 需要你决定：保留当前 2 个提交的历史，还是重新开一个干净仓库？**
**⇒ 我建议【保留】** —— 当前只有 2 个提交且无敏感内容，历史干净且有价值（能看到 M1 通过这个节点）。

### P1 · 结构与许可（**2~3 天**）

| 步骤 | 产出 |
|---|---|
| P1-1 | 加 3 个 LICENSE + NOTICE |
| P1-2 | 加 `CONTRIBUTING.md`、`CITATION.cff`、`CHANGELOG.md` |
| P1-3 | 重写顶层 `README.md`（英文）+ `README.zh-CN.md` |
| P1-4 | 建 `.github/` + `ci.yml` |
| P1-5 | （可选）固件加 Makefile，让 CI 能构建 |

### P2 · 文档与展示（**3~5 天**）

| 步骤 | 产出 |
|---|---|
| P2-1 | 拍视频/照片，做 GIF + 架构图 |
| P2-2 | `hardware/BOM.csv` |
| P2-3 | CAD 导出 STEP，打成一个 Release 资产（~60 MB） |
| P2-4 | 修文档里的过时事实（波特率 1 Mbps→500k、分压比 22k→20k、测试 102→117） |
| P2-5 | （可选）把 `docs/49` 的坑整理成一篇英文博客 |

### P3 · 发布（**1 天**）

| 步骤 | 产出 |
|---|---|
| P3-1 | 先建**私有**仓库，推上去，自己 clone 一遍验证 | 
| P3-2 | 按 README 从零走一遍"快速开始"（**关键：用另一台干净机器或容器**） |
| P3-3 | 改公开 + 打 tag `v0.2.0-opensource` + Release（含 hex、npz、STEP） |
| P3-4 | 发公告（见 §9） |

---

## 8 · 需要你决定的 7 件事

| # | 问题 | 我的建议 |
|---|---|---|
| **1** | **代码许可：Apache-2.0 / MIT / GPL-3.0？** | **Apache-2.0**（专利保护，仍可商用） |
| **2** | **硬件许可：CERN-OHL-S（强互惠）/ -W（弱）/ CC-BY-SA？** | **CERN-OHL-W**（别人能做产品，降低门槛） |
| **3** | **文档许可证：CC-BY-4.0 / CC-BY-SA-4.0？** | **CC-BY-4.0** |
| **4** | **目录改名 `pi/` → `software/`？** | ❌ **不改**（改动面太大，收益小） |
| **5** | **保留 git 历史（2 个提交）？** | ✅ **保留**（干净且有 M1 节点） |
| **6** | **README 主语言？** | **英文为主 + `README.zh-CN.md`**（覆盖面最大） |
| **7** | **CAD 怎么给？** | **STEP 放 Release**（不进 git，~60 MB） |

---

## 9 · 发布与运营（P3 之后）

### 9.1 发布渠道

| 渠道 | 适合度 | 注意 |
|---|---|---|
| **GitHub** | ⭐ 首选 | 社区最大，Release/CI/Issue 齐全 |
| Hacker News（Show HN） | 🟡 中 | 英文、要诚实（"M1 standing, walking WIP"） |
| Reddit r/robotics | 🟡 中 | 同上 |
| 知乎 / B站 / 即刻 | 🟡 中 | 中文社区，视频优先 |
| **arXiv**（可选） | 🟢 低 | 除非要写成论文 |

**⚠️ 建议顺序：GitHub → 知乎（中文首发放这里，因为文档是中文）→ 英文社区。**

### 9.2 发布后要准备承受的

| 可能的质疑 | 准备 |
|---|---|
| "能走吗？" | 诚实回答：还不能，M1 站立已量化验收 |
| "为什么不用 XXX 算法" | 指向 `docs/46` 的方案取舍 |
| "舵机选型有问题" | 这正好是社区价值 —— 接受讨论 |
| "代码跑不起来" | **← 最关键**：P0 的清场就是为了这个 |

### 9.3 不要做的事

| ❌ 不要 | 原因 |
|---|---|
| 宣称"实现了 sim2real 行走" | 事实不支持，一旦被发现损失远大于收益 |
| 把 `reference/` 或 CAD SLDASM 传上去 | 许可问题 / 别人打不开 |
| 上传 402 MB 厂商 SDK | 同上 + 仓库会巨大 |
| 发布前不亲自 clone 验证 | **最常见的翻车点** |
| 一次性做完美再发 | 永远发不出去 —— 按 P0→P3 分阶段 |

---

## 10 · 最小可行路径（如果时间紧）

**如果只有 2 天，按这个顺序做，其余全部推后：**

```
Day 1 上午  P0-1 脚本环境变量化（让项目"能跑"）
Day 1 下午  P1-1 三个 LICENSE + P1-3 README（英文）
Day 2 上午  P2-1 拍视频 + GIF（让别人"想看"）
Day 2 下午  P3-1/2 私有仓库 → clone 验证 → 公开
```

**⇒ 这四步就能发出一个"能跑、有图、有许可、诚实"的项目。CI、BOM、文档修正都可以发布后再补。**

---

## 11 · 我的总体建议

**做，但按阶段做，而且把 P0 当成真正的门槛。**

**理由：**

1. **内容本身够格** —— 完整闭环 + 25 个坑的工程记录，这在开源四足里是稀缺的。
2. **最大风险不是"不够好"，而是"跑不起来"** —— 30+ 处 `~/` 会让 90% 的尝试者放弃，而且他们不会提 issue，直接关掉页面。
3. **诚实是资产** —— 明确写"sim2real 未达可用"，比含糊其辞更能获得信任；而且 `docs/49` 本身就是"我们失败过 25 次"的记录，这是最难得的部分。
4. **先发再完善** —— 开源项目在"半成品+诚实"状态下获得的第一批 issue，往往比自己闭门造车更有价值。

**⚠️ 唯一我不建议做的事：在 sim2real 没解决的情况下，把标题写成"能走的四足"。**
