vrrrrs/RL-CAT/docs/47-policy-export-report.md

# export_task 交付报告

> 执行环境：Ubuntu 22.04 / conda `isaacgym` / torch 1.12.1+cu113 / RTX 4060 Laptop
> 对应 [45-linux-tasks.md](45-linux-tasks.md) 的交付清单（§6）

---

## 0. 两个必须先说的发现

### ⚠️ 发现 1：文档推荐的检查点是**失败的那次训练**

45-linux-tasks.md §2.1 说：

> `Oct06_03-15-34_` 是后起的训练，通常是更优的那次。

**这条假设是错的。** `Oct06_03-15-34_` 正是本项目**第 8 轮实验**，我把它判定为失败并放弃了。实测三个候选的对比：

| run | 峰值平均回报 | 末期 episode 长度 | 末期 tracking(原始) | 判定 |
|---|---|---|---|---|
| `Oct06_02-58-05_`（第 7 轮） | 40.67 | 1909 | 0.801 | 可用，但中高速欠响应（误差 0.134/0.162） |
| **`Oct06_03-15-34_`（第 8 轮）** | **72.11 ← 全表最高** | **891 ← 会摔** | 0.547 | ❌ **失败** |
| **`Oct06_03-32-41_`（第 9 轮）** | 31.82 | **2002 ← 跑满** | 0.784 | ✅ **全部验收达标** |

**"峰值回报最高"的恰恰是坏的那个。** 原因：第 8 轮把 `tracking_lin_vel` 权重提到 6.0，训练后期机器人开始摔 —— episode 从 2002 掉到 891，惩罚累积变少，**平均回报反而被推高了**。

> 📌 **通用教训**：`Mean reward` 在不同 episode 长度下**不可比**。判断模型好坏必须
> **同时看 `Mean episode length`**；长度掉下来就是训练在变差，此时 reward 数字再高也没意义。

**⇒ 本次导出用的是 `Oct06_03-32-41_/model_500.pt`（第 9 轮，iter 499）。**
它经过完整的固定指令验收：−0.3 ~ +0.5 m/s 全段跟踪误差 0.060~0.099，零摔倒，左右占空比差 0.08~0.14。

### ⚠️ 发现 2：`export_policy.py` 有个 bug，"唯一不循环的检查"被静默跳过

`verify_with_rsl_rl()` 第 302 行原文：

```python
hidden = [W.shape[0] for W, _ in layers[1:]]      # ❌ 错
```

`layers[1:]` 包含了**输出层**，于是把输出维度 12 也当成隐藏层，构造出 `47→128→64→12→12` 的错误网络，`load_state_dict` 必然失败 → 异常被 `except` 吞掉 → **这段检查静默跳过**。

而 45-linux-tasks.md §2.4 明确说这条是"**唯一不循环的检查**"（前两个对比都建立在"层顺序假设"上，假设错了会一致地错）。**它被跳过 = 实际上没有独立验证。**

**已修复为 `layers[:-1]`**，并在旁边加了注释说明原因。修复后：

```
 ---- 可选：用 rsl_rl 真实 ActorCritic 复核 ----
   与 rsl_rl 真实 actor 的最大相对误差 = 0.000e+00
   ✅ 层顺序假设正确
```

---

## 1. §6 交付清单逐项回答

| # | 交付物 | 状态 |
|---|---|---|
| **1** | `pi/models/policy_rlcat_flat.npz` | ✅ **已产出**，199 KB |
| **2** | `pi/models/policy_rlcat_flat.onnx` | ✅ **已产出**，213 KB（opset 13） |
| **3** | 导出脚本完整输出（含三方验证 + rsl_rl 复核） | ✅ 见 §3 |
| **4** | L2 树莓派环境报告 | ⛔ **无法完成**（本机不是 Pi，也没有 Pi 的 SSH 访问） |
| **5** | L3 策略在仿真里能走吗 | ✅ 能走，见 §4 |
| **6** | `replay/*.npz` 轨迹 | ✅ **已产出**，364 KB |

---

## 2. 产物位置

```
pi/models/
├── policy_rlcat_flat.npz      199 KB  ← 拷到树莓派（Pi 运行时）
└── policy_rlcat_flat.onnx     213 KB  ← 提交进仓库（发布格式）

replay/
└── rlcat_flat_obs_action_trace.npz   364 KB
       obs(1000,47) action(1000,12) q_target(1000,12) q(1000,12) qd(1000,12)
       base_v(1000,3) base_w(1000,3) phase(1000,2) cmd(1000,3) dt meta
       条件：vx=+0.3，无噪声、无域随机化、平地，10 秒 / 1000 步
```

**npz 结构**（键名与 `pi/rl_policy.py` 的约定一致）：

```
n_layers = 4
W0 (256, 47)   b0 (256,)      47 → 256   ELU
W1 (128, 256)  b1 (128,)     256 → 128   ELU
W2 (64, 128)   b2 (64,)      128 → 64    ELU
W3 (12, 64)    b3 (12,)       64 → 12    无激活
参数总数 = 54220  ✅ 与文档 §2.3 的期望值完全一致
```

---

## 3. 导出脚本完整输出（修复后）

```
 rsl_rl → onnx + npz  策略导出
 输入 : ~/legged_gym/logs/rlcat_flat/Oct06_03-32-41_/model_500.pt
 onnx : pi/models/policy_rlcat_flat.onnx
 npz  : pi/models/policy_rlcat_flat.npz

 actor 结构：
   0: 47    → 256    ELU                  W(256, 47) b(256,)
   1: 256   → 128    ELU                  W(128, 256) b(128,)
   2: 128   → 64     ELU                  W(64, 128) b(64,)
   3: 64    → 12     （输出层，无激活）    W(12, 64) b(12,)
   参数总数 = 54220

   ONNX 导出成功（opset 13）
   大小 213 KB
   ✅ 已保存 pi/models/policy_rlcat_flat.npz（199 KB）

 ---- 三方一致性验证（torch / onnx / numpy）----
   #0  torch[0:3]=[ 1.892757  4.818825 -2.981021]  numpy[...]  rel=1.48e-07  onnx_rel=2.97e-07
   #1  torch[0:3]=[-1.988016 -1.312943  3.221242]  numpy[...]  rel=1.38e-07  onnx_rel=4.84e-07
   #2  torch[0:3]=[-0.110675 -1.026836 -1.676311]  numpy[...]  rel=1.29e-07  onnx_rel=4.18e-07
   #3  torch[0:3]=[ 1.34896   4.446736 -2.658054]  numpy[...]  rel=1.61e-07  onnx_rel=3.22e-07
   #4  torch[0:3]=[ 5.16248   4.109583 -3.386164]  numpy[...]  rel=1.82e-07  onnx_rel=1.82e-07

   torch vs numpy : 最大绝对 9.537e-07  最大相对 1.817e-07
   torch vs onnx  : 最大绝对 3.338e-06  最大相对 4.835e-07
   ✅ 一致（容差 1e-05）

 ---- 可选：用 rsl_rl 真实 ActorCritic 复核 ----
   与 rsl_rl 真实 actor 的最大相对误差 = 0.000e+00
   ✅ 层顺序假设正确

 ✅ 导出完成且验证通过
```

### §2.4 判据对照

| 检查 | 期望 | 实测 | 判定 |
|---|---|---|---|
| 第一层 `47 → 256` | 47 入、256 出 | ✅ | 通过（没选错检查点） |
| 最后一层 `→ 12` | 12 出 | ✅ | 通过 |
| 参数总数 | 54220 | **54220** | 通过 |
| `torch vs numpy` 相对误差 | = 0 | 1.8e-07 | 通过（浮点舍入，非算法差异） |
| `torch vs onnx` 相对误差 | < 1e-6 | 4.8e-07 | 通过 |
| **`rsl_rl 真实 actor` 相对误差** | **< 1e-5** | **0.000e+00** | ✅ **通过（这条之前是被跳过的）** |

---

## 4. L3 · 策略在仿真里能走吗

**能走，且已经过完整验收。**

| v_cmd (m/s) | −0.20 | 0.00 | +0.20 | +0.30 | +0.50 |
|---|---|---|---|---|---|
| 实测 vx | −0.204 | −0.021 | 0.159 | 0.239 | 0.418 |
| **跟踪误差** | **0.064** | **0.060** | **0.066** | **0.081** | **0.099** |

- 32 环境 × 15 秒，**全速度段零摔倒**
- 步态：标准对角小跑（`lb+rf` 与 `lf+rb` 两组配对），触地占空比 `[0.41, 0.19, 0.38, 0.32]`
- 左右占空比差 0.08~0.14
- 机身高度 0.105~0.120 m

> 视频与更细的数据见仓库根目录的 `videos/`、`plots/`、`RL-CAT-训练实施报告.md`。

---

## 5. L2 / L4 无法完成的原因

这两项需要**树莓派上的 shell 访问**（`ssh <pi>`）。当前 Linux 机器上：

```bash
$ ssh <pi> ...        # 没有可用的 Pi 地址/密钥
$ cat /proc/device-tree/model    # 这不是 Pi（是 x86 笔记本）
```

**L2（依赖 + CPU governor）和 L4（Pi 侧测试）必须在 Pi 上执行**，我这边做不到。
L2/L4 的命令原文在 45-linux-tasks.md §3 和 §5，照着跑即可 —— 它们都不依赖本次导出。

---

## 6. 一个额外的提醒：部署前必须补驱动器延迟

`45-linux-tasks.md` §9 提到"机器人必须在地面上稳定站住"这个前置条件。**还有一个同等重要的：**

**现在仿真里的舵机是"理想伺服"** —— 给了目标角度下一个物理步就到位。真机上：
- 总线 SyncWrite 约 1 ms
- 舵机内部 PID 响应
- 总延迟约 **1~3 个控制周期（10~30 ms）**

**后果**：真机上会震荡，而仿真里完全看不出来。建议在仿真里加一个动作延迟队列并纳入域随机化（每次 reset 随机 1~3 步），重训一版再部署。

这也和 45-linux-tasks.md 里"至今所有测试都是吊起的"呼应 —— 吊起时机器人不承重，延迟的影响被掩盖了，**落地后才会暴露**。
