vrrrrs/RL-CAT/archive/README.md

# 归档说明（Archive）

> 本目录存放**已退役**的文档。它们不再维护，但仍保留作为设计历史的追溯依据。
>
> **⚠️ 请勿以本目录中的任何内容作为当前设计依据。** 每份文件下方都注明了退役原因和替代文档。

---

## 退役文档清单

| 文件 | 原位置 | 退役原因 | 替代文档 |
|---|---|---|---|
| [`方案_v1.md`](方案_v1.md) | 根目录 `方案.md` | 结构与定位混乱：混合了"设计决策日志"和"设计规格书"两种角色；机械部分尺寸与实际模型不符；含大量讨论中间产物。 | 拆分为 `docs/00-overview.md`、`docs/10-mechanical.md`、`docs/20-electronics.md`、`docs/90-decisions.md` |
| [`机械设计规格_v0.md`](机械设计规格_v0.md) | 根目录 `机械设计规格.md` | **内容已失效**：文中腿长为 120 mm，实际模型为 180 mm（大腿 75 + 小腿 105）。多项参数与实际不符。 | `docs/10-mechanical.md`（待重写）；权威参数见 `hardware/mechanical/参数.xlsx` |
| [`项目流程_v1.md`](项目流程_v1.md) | 根目录 `项目流程.md` | 属于**过程管理**文档（分工流程、交接点、验收节点），不是技术设计文档，不适合放在 `docs/`。 | 无需替代；如需保留流程管理内容，另建 `docs/95-workflow.md` |
| [`RL-CAT项目交接文档_v1.md`](RL-CAT项目交接文档_v1.md) | 根目录 `RL-CAT项目交接文档.md` | **含已被实测证伪的结论**（详见下方勘误）。且同时承担了项目概述、硬件规格、URDF 说明、仿真流程四种角色。 | `docs/00-overview.md`、`docs/10-mechanical.md`、`docs/30-firmware.md`、`docs/40-simulation.md` |

---

## ⚠️ 勘误（重要）

### 勘误 1：`*_thigh` 关节限位不是阻塞项

**`RL-CAT项目交接文档_v1.md` 中的错误结论：**

> §0 最容易踩的坑：「`*_thigh` 的 +30° 上限 < 站立所需的 +31.19°」→ 标为 🔴 阻塞
> §13 关键提醒：「`*_thigh` 限位 +30° < 站立所需 +31.19° → 站立姿态超出限位，必须先放宽」

**实际情况（已由仿真实测证伪）：**

```
文档混淆了两个不同的角：
  · 大腿连杆相对竖直方向的绝对夹角（几何量）
  · 关节相对 CAD 零位的转角（URDF 的 q）

实际上：q = 0 就是装配好的站立姿态，
        所以站立时 thigh 关节角 = 0，离 +30° 上限还有 30° 余量。
```

**实测证据：** 机器人以原始 URDF 在 Isaac Gym 中成功站立并行走（见 `Sim/RL/RL-CAT-训练实施报告.md` §3.1、§3.2）。

**正确结论：** `*_thigh` 上限放宽到 90° 是**为了给摆腿留空间**，不是为了修复"站立够不到"。

### 勘误 2：观测向量是 47 维，不是 50 维

**`RL-CAT项目交接文档_v1.md` §12 写的是 50 维**（含 3 个"保留/待定"维）。

**实际实现是 47 维**（"方案 C" = 50 维设计的前 47 维），见 `Sim/RL/RL-CAT-训练实施报告.md` §4.1。

**当前有效的 47 维布局：**

```
 0– 2   重力向量（IMU 姿态反算）        3
 3– 5   机身角速度（陀螺）              3
 6– 8   速度指令 (vx, vy, ωz)           3
 9–20   关节位置（相对 q_default）      12
21–32   关节速度                       12
33–44   上一帧动作                     12
45–46   步态相位 sin/cos               2
                                      ──
                                      47
```

**⚠️ 固件侧的观测拼接必须按 47 维实现。**

### 勘误 3：URDF 关节零位的性质

**`RL-CAT项目交接文档_v1.md` §6.3 写的是"推断 q=0 是站立姿态，必须实测验证"。**

**现已实测确认**（`Sim/RL/RL-CAT-训练实施报告.md` §4.3）：
`default_joint_angles` 全为 0，且机器人确实站立成功。

---

## 相关但未归档的文档

| 文档 | 位置 | 说明 |
|---|---|---|
| `RL-CAT项目交接文档.md` | `Sim/RL/` | ⚠️ 与已归档的 v1 内容相同。**Sim/ 目录暂不整理**，待 sim 工作完成后再一并处理 |
| `RL-CAT-训练实施报告.md` | `Sim/RL/` | ✅ **有效**，是本项目质量最高的技术记录 |
| `RL-CAT-IsaacGym训练流程方案.md` | `Sim/RL/` | ✅ 有效 |
| 5 份固件文档 | `firmware/doc/` | ✅ 有效 |

---

## 归档原则

```
① 归档 ≠ 删除。设计历史对追溯"为什么这么定"有价值。
② 每份归档文档都必须注明：退役原因 + 替代文档 + 已知错误。
③ 归档文档不再更新。发现新问题只在替代文档里修。
④ 归档目录不计入"项目现行文档"，不参与文档索引。
```
