vrrrrs/RL-CAT/archive/RL-CAT项目交接文档_v1.md

# RL-CAT 项目交接文档

> **用途**：交给 Ubuntu 上的 AI agent（或未来的自己），使其能在没有 Windows 端上下文的情况下接手仿真与训练工作。
>
> **生成日期**：2026-10-05
> **当前阶段**：URDF 已完成，准备进入 Isaac Gym 仿真验证

---

## 0. 给 Ubuntu Agent 的阅读指南

**你现在要做的事（按优先级）：**

```
1. 读第 5 节（URDF 现状）→ 了解资产文件在哪、结构如何
2. 读第 7 节（Isaac Gym 加载要点）→ 知道有哪些坑
3. 读第 9 节（当前待办）→ 明确下一步
4. 需要背景时查第 2/3/4 节
```

**⚠️ 两个必读警告：**

| # | 警告 | 位置 |
|---|---|---|
| 1 | **`q = [0]*12` 很可能就是站立姿态，但必须实测验证** | §6.3 |
| 2 | URDF 只描述了力矩/速度饱和，**延迟必须手工加** | §8.1 |

**⚠️ 最容易踩的坑（按优先级）：**

| 优先级 | 事项 | 位置 |
|---|---|---|
| 🔴 | **`*_thigh` 限位 +30° < 站立所需 +31.19° → 站立姿态超出限位，必须先放宽** | §5.6 / §9 步骤 6 |
| 🔴 | `q_default` 未验证（推断是 `[0]*12`） | §9 步骤 5 |
| 🟡 | DOF 顺序与文档索引不同，必须做映射 | §2.4 |
| 🟡 | 驱动器延迟未实现 | §8.1 |

**⚠️ 已排除的疑点（不要重复怀疑）：**

| 项 | 结论 | 证据 |
|---|---|---|
| **mesh 路径** | ✅ 已是相对路径 `meshes/part_N.stl` | 新版 `robot.urdf` |
| **mesh 单位** | ✅ **新版 STL 是毫米，`scale="0.001 0.001 0.001"` 是【必需的】** | 实测顶点：新版 76.0（mm）vs 旧版 0.076（m） |
| XML 语法 / link 数 / joint 数 | ✅ 正确 | 13 / 12，引用全部有效 |
| 质量属性数值 | ✅ 与 SolidWorks 实测一致 | 总质量 1.386 kg |
| 关节限位 | ✅ 已重新生成，12 个全部包含站立姿态 (q=0) | §5.3 |

**⚠️ 勘误记录：** 本文档早期版本曾说"STL 是米、不要加 scale"——那个判断来自**旧版**文件（旧版 STL 确实是米）。**新版 STL 改成了毫米，所以 `scale="0.001"` 必须保留。** 详见 §7.2。

---

## 1. 项目概述

**RL-CAT** 是一只 12 自由度四足机器人：

```
形态：四足，每腿 3 关节（髋外摆 + 髋俯仰 + 膝）
尺寸：机身 200 × 72 × 58 mm，站立高度 216 mm
重量：CAD 计 1.386 kg（含 12 个舵机、Pi 5、电池、PCB）
算力：树莓派 5 (4GB) 跑策略，STM32F103C8 做下位机
执行：12 个 Feetech ST-3215-C018 总线舵机
目标：强化学习训练 → sim-to-real 部署
```

**整体技术路线：**

```
SolidWorks 建模 → URDF → Isaac Gym 仿真 → PPO 训练 → 域随机化
                                                          ↓
真机部署 ← 系统辨识 ← 仿真验证 ←───────────────────────────┘
```

---

## 2. 硬件规格（影响仿真的部分）

### 2.1 执行器：Feetech ST-3215-C018

| 参数 | 值 | 对仿真的意义 |
|---|---|---|
| **型号** | **ST-3215-C018（12V 版）** | ⚠️ 只能用这个型号，C001/C044 是 7.4V 会被 3S 过压保护切断 |
| 尺寸 | 45.2 × 24.7 × 35 mm | 质量 55±1 g |
| 供电 | 6–14 V | 用 3S（9.0–12.6 V） |
| **堵转扭矩** | **30 kg·cm / 2.942 N·m @12V** | URDF 里 effort 设 3 N·m |
| 额定扭矩 | 10 kg·cm / 0.981 N·m | 站立时关节力矩应远小于此 |
| **空载转速** | **45 RPM = 4.71 rad/s** | ⚠️ 真机速度上限，仿真里要加限制 |
| 堵转电流 | 2.7 A | |
| 额定电流 | 900 mA | |
| 力矩常数 Kt | 11 kg·cm/A ≈ 1.079 N·m/A | 用于从电流反推力矩 |
| **编码器** | **12-bit 磁编码器**（非电位器） | 0.088°/step，4096 步/360° |
| 回程间隙 | ≦0.5° | 仿真里可加小死区 |
| 通信 | 半双工异步串口 8N1，默认 1 Mbps | |

**可读回的反馈量（用于系统辨识）：**

```
Present Load      (地址 60/61)   → 力矩
Present Position  (地址 56/57)   → 位置
Present Speed     (地址 58/59)   → 速度
Present Voltage   (地址 62)      → 电压
Present Temperature(地址 63)     → 温度
Moving            (地址 66)
Present Current   (地址 69/70)
```

**保护机制（真机行为，仿真里可选模拟）：**

```
过流：>2 A 持续 2 s → 切断输出
过压：>14 V 或 <4 V
过温：>70 °C
```

### 2.2 控制系统架构

```
┌──────────────┐  UART 1 Mbps   ┌──────────────┐  总线 1 Mbps  ┌─────────┐
│ Raspberry Pi 5│ ─────────────→ │ STM32F103C8  │ ────────────→ │ 12 舵机 │
│  (策略推理)   │ ←───────────── │  (100 Hz 控制)│ ←──────────── │         │
└──────────────┘                └──────────────┘               └─────────┘
                                        │
                                        │ 软件 I2C (PB8/PB9)
                                        ↓
                                   JY901P IMU
                                   (内部融合，输出姿态)
```

| 参数 | 值 |
|---|---|
| **控制频率** | **100 Hz** |
| 通信方式 | USART1 → Pi (1 Mbps)、USART2 → 舵机 (1 Mbps)、USART3 → ESP32-C3 (921600) |
| IMU | JY901P，**内部做姿态融合**，MCU 只需读结果 |
| ⚠️ IMU 波特率 | 必须设成 921600（默认 115200 会占 19% CPU） |

**时序预算（1 Mbps，12 舵机）：**

```
SyncWrite 下发：1.02 ms
syncRead 回读： 1.53 ms
合计 2.55 ms = 100 Hz 周期的 26%    ← 可接受
```

### 2.3 电池与供电

| 参数 | 值 |
|---|---|
| 电池 | 3S1P 18650，**必须 ≥25 A 连续放电**（Molicel P26A / Sony VTC5A / P28A） |
| 电压范围 | 9.0 – 12.6 V |
| 容量 | 约 27.8 Wh，续航约 14 min |
| ⚠️ 低压阈值 | 10.5 V 警告 / 9.9 V 建议停 / 9.3 V 强制趴下 |

### 2.4 关节定义

**腿编号：lf = 左前、lb = 左后、rf = 右前、rb = 右后。**

**⚠️ 三套"顺序"是不同的，不要混淆：**

| 顺序体系 | 排列方式 | 用途 |
|---|---|---|
| **A. 固件/训练索引** | **按关节类型分组**（0–3 外摆、4–7 髋俯仰、8–11 膝） | 观测/动作向量、固件数组 |
| **B. URDF 声明顺序** | **按腿分组**（lf_hip, lf_thigh, lf_calf, lb_hip, …） | URDF 文件里的书写顺序 |
| **C. Isaac Gym DOF 顺序** | 待实测，可能等于 B，也可能重排 | `get_asset_dof_names()` 的返回顺序 |

**👉 推荐做法：以 A 为"逻辑索引"，把 B/C 都视为物理顺序，在代码里做映射。**

#### A. 固件/训练索引（推荐作为逻辑索引）

```
0–3   髋外摆 (abduction)：lf_hip, lb_hip, rf_hip, rb_hip
4–7   髋俯仰 (hip pitch)：lf_thigh, lb_thigh, rf_thigh, rb_thigh
8–11  膝     (knee)     ：lf_calf, lb_calf, rf_calf, rb_calf
```

#### B. URDF 声明顺序（实测，共 12 个）

```
索引: 0        1         2         3        4          5         6
名字: lf_hip   lf_thigh  lf_calf   lb_hip   lb_thigh   lb_calf   rf_hip

索引: 7         8         9        10        11
名字: rf_thigh  rf_calf   rb_hip   rb_thigh  rb_calf
```

**即"按腿分组"（lf → lb → rf → rb，每条腿内 hip → thigh → calf），与 A 的"按类型分组"完全不同。**

#### ⚠️ 映射表（A ↔ B）

**从逻辑索引 A 到 URDF/物理索引 B：**

```python
# A 索引 -> URDF 名
A_to_name = [
    "lf_hip", "lb_hip", "rf_hip", "rb_hip",           # 0-3  外摆
    "lf_thigh", "lb_thigh", "rf_thigh", "rb_thigh",   # 4-7  髋俯仰
    "lf_calf", "lb_calf", "rf_calf", "rb_calf",       # 8-11 膝
]

# URDF 声明顺序（B）
B_names = [
    "lf_hip", "lf_thigh", "lf_calf",
    "lb_hip", "lb_thigh", "lb_calf",
    "rf_hip", "rf_thigh", "rf_calf",
    "rb_hip", "rb_thigh", "rb_calf",
]

# 建立映射：A 索引 -> B 索引
A2B = [B_names.index(n) for n in A_to_name]
# 实测结果（Isaac Gym 若与 URDF 声明顺序一致）：
# A2B = [0, 3, 6, 9, 1, 4, 7, 10, 2, 5, 8, 11]
```

**⚠️ 如果 Isaac Gym 的 DOF 顺序不等于 B，先做 B→C 的映射，再套 A2B。**

**机身坐标系：X 向前、Y 向左、Z 向上，原点 = 机身中段中心的地面投影。**

---

## 3. 机械关键参数

### 3.1 设计目标值（来自设计文档，⚠️ 与实测模型有偏差，见 §3.3）

| 参数 | 值 |
|---|---|
| **腿长 L** | **180 mm**（大腿 75 mm + 小腿 105 mm，比值 1.40） |
| 站立姿态 h/L | 0.88 → 髋高 158.4 mm |
| **站立膝夹角** | **122.4°**（大腿与小腿之间的夹角，此时腿是弯的） |
| 大腿与垂直夹角 | 34.03° |
| 小腿与垂直夹角 | 23.6° |
| 膝力矩臂 | 42.0 mm |
| 站立时膝力矩 | 0.432 N·m（@1.386 kg 总重，动态系数 2.5） |
| **膝可动范围** | **距完全伸直 0° ~ 120°** ⚠️ 见下方说明 |
| 髋外摆范围 | 0° – +30°（**不对称，不做内摆**） |
| 髋间距 | **横向 ±55 mm；纵向 ±100 mm**（前轴到后轴 200 mm） |
| 机身 | 200 × 72 × 58 mm |
| 足端 | 球形橡胶，半径 9 mm |

### 3.2 ⚠️ 关于"膝角"的两个不同参考（极易混淆）

**必须区分这两个角，它们的参考系不同：**

| 名称 | 参考 | 站立时的值 | 说明 |
|---|---|---|---|
| **膝夹角** | 大腿与小腿之间的夹角 | **122.4°** | 180° = 完全伸直 |
| **膝屈曲量** | 距完全伸直的旋转量 | **57.6°** | = 180° − 122.4° |

**所以"膝活动范围 60°–150°"这个说法本身是矛盾的：**

```
如果它指【膝屈曲量】：站立需要 57.6°，而 60° 下限 > 57.6° → 站立姿态【够不到】
如果它指【膝夹角】  ：站立 122.4° 落在 60–150 内 ✅，但 150° 意味着腿比站立还弯
```

**👉 结论：设计文档里那个"60°–150°"的取值范围定义不清晰，必须以仿真实测为准（见 §6.4）。**

**可用的物理约束（更可靠）：**

| 约束 | 值 | 来源 |
|---|---|---|
| 膝最大屈曲 | 腿最短时 ≈ 60° 膝夹角（深蹲） | 设计目标 |
| 膝完全伸直 | 180° 膝夹角（= 屈曲 0°，机械上可能顶死） | 机构 |
| **站立** | **122.4° 膝夹角** | 必须可达 |

### 3.3 ⚠️ 设计目标值 vs URDF 实测值（对不上，以 URDF 为准）

**从 URDF 的 joint `<origin>` 反推出的实际连杆长度：**

| 量 | 设计值 | **URDF 实测** | 说明 |
|---|---|---|---|
| 髋外摆轴 → 髋俯仰轴 | ~20 mm（外摆臂） | **64.96 ~ 71.07 mm** | ⚠️ 这段含的外摆臂 + 髋部结构，不等于纯外摆臂长 |
| **髋俯仰轴 → 膝轴** | 大腿 75 mm | **63.61 ~ 64.96 mm** | 偏短约 10~15% |
| **膝轴 → 踝/足端** | 小腿 105 mm | **75.78 mm** | ⚠️ 偏短约 28% |

**⚠️ 这个偏差说明：**

```
① 设计文档里的 75/105 是"连杆的物理长度"（零件外形尺寸）
② URDF origin 长度是"关节轴心之间的距离"
③ 两者不等，因为轴心不在零件端点（舵机输出轴有偏心、踝部有偏置）
```

**👉 计算站立姿态的关节角时，必须用 URDF 的轴心距（63.61 / 75.78），不能用 75/105。**

**⚠️ 用 §3.1 的 34.03° / 57.6° 等角度值之前，要用实际轴心距重新算一遍。**

### 3.4 堵转扭矩的三个数值（都对，参考条件不同）

| 值 | 条件 | 用途 |
|---|---|---|
| **2.942 N·m** | 12 V（舵机标称电压） | 官方规格书值 |
| **2.721 N·m** | 3S 标称 11.1 V | 实际电池下的估算（电压低 → 扭矩低） |
| **3.0 N·m** | — | **URDF `effort` 设的上限，取整并留余量** |

**⚠️ URDF 的 `effort = 3.0` 略大于物理堵转扭矩，这是有意为之：** 它作为安全上限，真正的限幅由 PD 控制器和舵机自身的过流保护完成。

---

## 4. 质量属性（已实测，已写入 URDF）

**总质量：1.386 kg**（13 个 link 之和）

| link | 质量 (kg) | CoM (m) | 惯性量级 (kg·m²) |
|---|---|---|---|
| `base_link` | 0.730 | (0, 0, 0.013404) | 1e-3 |
| `lf_hip` | 0.080 | (0.004612, 0.005229, 0.046914) | 5e-5 |
| `lb_hip` | 0.080 | (0.004612, 0.005229, -0.045414) | 5e-5 |
| `rf_hip` | 0.080 | (0.004612, -0.005229, 0.045414) | 5e-5 |
| `rb_hip` | 0.080 | (0.004612, -0.005229, -0.045414) | 5e-5 |
| `lf_thigh` | 0.070 | (0.037957, 0.035159, -0.005235) | 3e-5 |
| `lb_thigh` | 0.070 | (0.039072, 0.033916, -0.005235) | 3e-5 |
| `rf_thigh` | 0.070 | (0.037513, 0.035632, 0.005235) | 3e-5 |
| `rb_thigh` | 0.070 | (0.039182, 0.033788, 0.005235) | 3e-5 |
| `lf_calf` | 0.014 | (0.028656, -0.031667, 0.007971) | 2e-5 |
| `lb_calf` | 0.014 | (0.030331, -0.030067, 0.007971) | 2e-5 |
| `rf_calf` | 0.014 | (0.029120, -0.031241, -0.007971) | 2e-5 |
| `rb_calf` | 0.014 | (0.031189, -0.029175, -0.007971) | 2e-5 |

**⚠️ 惯性张量来源**：SolidWorks 实测值，单位 kg·mm²，**已 ×1e-6 转换为 kg·m²**。
**⚠️ 参考系**：每个 link 自己的坐标系（不是 base_link）。

**⚠️ 已知待确认项：**

| # | 问题 | 影响 |
|---|---|---|
| 1 | `rb_hip` 的 CoM 原始数据缺失（导出为 0,0,0），现用 `lb_hip` 镜像值 | 影响小 |
| 2 | 电池/线缆等附加质量未完全计入，真机可能比 1.386 kg 重 | 需重新称重 |

---

## 5. URDF 现状（⭐ Ubuntu Agent 必读）

### 5.0 已验证的基线（截至交接时）

**以下项目已在 Windows 端验证通过，Ubuntu 端可以信任：**

| # | 检查项 | 结果 |
|---|---|---|
| 1 | **XML 语法** | ✅ 解析成功，无报错 |
| 2 | **link 数 / joint 数** | ✅ 13 / 12 |
| 3 | **joint 的 parent/child 引用** | ✅ 全部有效，无悬空引用 |
| 4 | **mesh 引用数** | ✅ 26 个（13 visual + 13 collision） |
| 5 | **质量属性单位** | ✅ 质量 kg、CoM m、惯性 kg·m² |
| 6 | **总质量** | ✅ 1.3860 kg（13 个 link 之和） |
| 7 | **关节 limit / effort / velocity** | ✅ 12 个关节全部有值，无 0/0 死锁 |
| 8 | **限位包含站立姿态 (q=0)** | ✅ **12 个关节全部包含 0** |
| 9 | **mesh 路径** | ✅ 已是相对路径 `meshes/part_N.stl`，Isaac Gym 可直接用 |
| 10 | **mesh 单位 / scale** | ✅ STL 是 mm，`scale="0.001"` 已正确写入 |
| 11 | **`lf_thigh` 的转轴方向** | ✅ 正向运动学验算为世界 Y 轴（正确） |
| 12 | **`lf_calf` 的 axis** | ✅ 新版已改为 +1，与同侧其他关节一致（旧版的 -1 已消失） |

**⚠️ 以下项目【未】验证，是 Ubuntu 端的首要任务：**

| # | 待验证项 | 见 |
|---|---|---|
| 1 | 其余 11 个关节的转轴方向 | §9 步骤 4 |
| 2 | `q = [0]*12` 是否为站立姿态 | §9 步骤 5 |
| 3 | **限位的运动学余量是否够用**（已知：髋俯仰/膝各只有约 27° 余量） | §5.6 |

### 5.1 ⭐ 用这一版：`Mechanic/URDF/urdf/`

**⚠️ 项目里有两版 URDF，用【新的】这一版：**

| 版本 | 路径 | 状态 |
|---|---|---|
| **✅ 新版（用这个）** | `Mechanic/URDF/urdf/` | 限位已按运动学重新设定、mesh 是相对路径、scale 正确、visual/collision offset 完整 |
| ❌ 旧版（弃用） | `Mechanic/URDF/CAT_defeature.SLDASM/` | 限位错误、mesh 用 `package://`、无 scale。**仅作历史参考** |

#### 新版的目录结构

```
Mechanic/URDF/urdf/
├── robot.urdf              ← ⭐ 主文件（12 KB，334 行）
├── meshes/                 ← 26 个 STL，文件名 part_1.stl ~ part_26.stl
│   ├── part_1.stl    ← base_link 的 visual
│   ├── part_2.stl    ← base_link 的 collision
│   ├── part_3.stl    ← lf_hip 的 visual
│   ├── part_4.stl    ← lf_hip 的 collision
│   └── ... （每个 link 两个：奇数 visual、偶数 collision）
├── parts.json              ← 零件清单（15 KB）
├── user_model.json         ← 用户模型数据（24 KB）
└── export_report.json      ← 导出报告（状态 ok，无 warning）
```

**⚠️ 新版把每个 link 的视觉和碰撞网格【分开导出**（part_1/part_2 是同一个 link 的两份），所以是 26 个文件而不是 13 个。这是正常的。

#### export_report.json 的内容

```json
{
  "status": "ok",
  "coordinate_schema_version": 3,
  "coordinate_frame": "z_up_x_forward",
  "rotation_convention": "Rz(yaw) * Ry(pitch) * Rx(roll)",
  "rpy_unit": "radian",
  "warnings": [],
  "errors": [],
  "urdf_file": "robot.urdf",
  "mesh_mode": "per_part"
}
```

**✅ `warnings` 和 `errors` 都是空的。**

#### ⚠️ 要拷贝的目录

**把整个 `Mechanic/URDF/urdf/` 目录拷到 Ubuntu 即可**，目录内的相对结构（`robot.urdf` + `meshes/`）必须保持原样。

**⚠️ 加载时 `asset_root` 指向 `urdf/` 目录本身**（见 §7.1）。

### 5.2 树结构（13 link / 12 joint）

```
base_link (根)
├── lf_hip ──→ lf_thigh ──→ lf_calf
├── lb_hip ──→ lb_thigh ──→ lb_calf
├── rf_hip ──→ rf_thigh ──→ rf_calf
└── rb_hip ──→ rb_thigh ──→ rb_calf
```

### 5.3 关节参数（新版 `robot.urdf` 的实际值）

| 关节类型 | axis | lower (rad) | upper (rad) | effort (N·m) | velocity (rad/s) |
|---|---|---|---|---|---|
| `*_hip` | `0 0 ±1` | **0** | **0.6981317 (40°)** | 3 | 8 |
| `*_thigh` | `0 0 ±1` | **-0.61086524 (-35°)** | **0.52359878 (30°)** | 3 | 8 |
| `*_calf` | `0 0 ±1` | **-1.0471975 (-60°)** | **1.0471975 (60°)** | 3 | 8 |

**✅ 全部 12 个关节的限位都包含 0（站立姿态），无死锁。**

**⚠️ 但见 §5.6：`*_thigh` 的 +30° 上限小于站立所需的 +31.19°，站立姿态超出限位。**

**axis 符号规律（规律清晰）：**

```
lf_hip   : +1        lb_hip   : +1        rf_hip   : -1        rb_hip   : -1
lf_thigh : +1        lb_thigh : +1        rf_thigh : -1        rb_thigh : -1
lf_calf  : +1        lb_calf  : +1        rf_calf  : -1        rb_calf  : -1
```

**✅ 左侧三关节统一 +1、右侧统一 -1。**

**⚠️ 旧版里 `lf_calf = -1` 的异常已在新版修正。**

### 5.4 各关节的 origin（相对父 link，⚠️ 以新版 `robot.urdf` 为准）

| joint | origin xyz (m) | origin rpy (rad) | \|origin\| (mm) |
|---|---|---|---|
| `lf_hip` | (0.0395, 0.05523, 0.017865) | (0, 1.5707963, 0) | 70.21 |
| `lb_hip` | (-0.041, 0.05523, 0.017865) | (0, 1.5707963, 0) | 71.07 |
| `rf_hip` | (0.041, -0.05523, 0.017865) | (0, 1.5707963, 0) | 71.07 |
| `rb_hip` | (-0.041, -0.05523, 0.017865) | (0, 1.5707963, 0) | 71.07 |
| `lf_thigh` | **(0.01965, 0.02, 0.0586)** | (-1.5707963, 0, 0) | 64.96 |
| `lb_thigh` | **(0.01965, 0.02, -0.0571)** | (-1.5707963, 0, 0) | 63.61 |
| `rf_thigh` | **(0.01965, -0.02, 0.0571)** | (-1.5708, 0, 0) | 63.61 |
| `rb_thigh` | **(0.01965, -0.02, -0.0571)** | (-1.5707963, 0, 0) | 63.61 |
| `lf_calf` | **(0.055242405, 0.051169979, 0.0085)** | (0, 0, 0) | 75.78 |
| `lb_calf` | **(0.056865099, 0.049360415, 0.0085)** | (0, 0, 0) | 75.78 |
| `rf_calf` | **(0.054596062, 0.05185904, -0.0085)** | (0, 0, 0) | 75.78 |
| `rb_calf` | **(0.057025443, 0.049175084, -0.0085)** | (0, 0, 0) | 75.78 |

**⚠️ 只有 `*_hip` 的 origin 在左右腿间不同（x = ±0.0395/0.041），`*_thigh` 和 `*_calf` 都是"x/y 对称、z 取 ±"。**

**⚠️ 表里的 `|origin|` 是关节轴心距，不是零件长度 —— 见 §3.3。**

### 5.5 已验证的转轴方向

**用正向运动学验算过（结果为世界坐标系下的方向）：**

```
lf_thigh 的 axis=(0,0,1)  →  世界坐标 (0, 1, 0) = 沿 Y 轴 = 左右方向
                          →  大腿【前后摆】  ✅ 正确
```

**⚠️ 其余关节未逐一验算，需在 Isaac Gym 里实测（见 §9 步骤 4）。**

**⚠️ 新版 URDF 的 axis 符号（已修正，与旧版不同）：**

```
lf_hip  +1    lf_thigh  +1    lf_calf  +1
lb_hip  +1    lb_thigh  +1    lb_calf  +1
rf_hip  -1    rf_thigh  -1    rf_calf  -1
rb_hip  -1    rb_thigh  -1    rb_calf  -1
```

**✅ 左侧三关节统一 +1、右侧统一 -1 —— 规律清晰（旧版里 `lf_calf = -1` 的异常已修正）。**

### 5.6 ⚠️ 运动学余量分析（新限位的关键检查）

**我用 §5.4 的轴心距（63.61 / 75.78 mm）和站立髋高 158.4 mm 反推了站立姿态，再和限位对比：**

#### 站立姿态需要的关节角（估算）

**输入（全部来自 §5.4 的实测轴心距）：**

```
大腿（髋俯仰轴 → 膝轴）  A = 63.61 mm
小腿（膝轴 → 踝轴）      B = 75.78 mm
腿总长                    L = 139.39 mm
站立髋高（h/L = 0.88）    h = 122.66 mm
```

**计算过程（已用余弦定理和正弦定理交叉验证）：**

```
① 形成三角形：A=63.61, B=75.78, 第三边 h=122.66
② 大腿与垂直夹角 α（余弦定理）:
     cos α = (A² + h² − B²) / (2·A·h) = (4046.2 + 15045.5 − 5742.6) / (2×63.61×122.66)
           = 13349.1 / 15606.5 = 0.8553
     α = 31.19°

③ 膝夹角 θ（余弦定理）:
     cos θ = (A² + B² − h²) / (2·A·B) = (4046.2 + 5742.6 − 15045.5) / (2×63.61×75.78)
           = −5256.7 / 9640.7 = −0.5453
     θ = 123.05°

④ 站立时的膝关节屈曲量（正弦定理验证一致）:
     β = arcsin(A·sin α / B) = arcsin(63.61 × 0.5179 / 75.78) = 25.76°
```

| 量 | 结果 |
|---|---|
| 大腿与垂直夹角 α | **31.19°** |
| 膝夹角 θ | **123.05°** |
| **站立时的髋俯仰关节角** | **≈ +31.19°** |
| **站立时的膝关节角** | **≈ +25.76°** |

**⚠️ 这与 §3.1 的 34.03° / 122.4° 略有差异（因为轴心距 ≠ 设计连杆长度）。以本节为准，但仿真里必须实测确认。**

#### 余量对比

| 关节 | 限位 | 站立值 | **正向余量** | **反向余量** |
|---|---|---|---|---|
| `*_hip` | 0° ~ +40° | 0° | 40.0° | 0° ⚠️ |
| `*_thigh` | −35° ~ +30° | **≈ +31.19°** | **−1.19°** ⚠️⚠️ | 66.19° |
| `*_calf` | −60° ~ +60° | **≈ +25.76°** | 34.24° | 85.76° |

#### ⚠️⚠️ 结论：**髋俯仰的 +30° 上限【不够】—— 站立姿态超出限位**

```
站立姿态需要 +31.19°
而限位上限是 +30.00°
→ 站立姿态【超出限位 1.19°】！
→ 在严格限位的物理引擎里，机器人无法维持站立姿态
```

**这比"余量不足"更严重 —— 是【站立姿态本身不可达】。**

**👉 强烈建议把 `*_thigh` 的 `upper` 从 `0.52359878`(30°) 放宽。**

| 建议值 | 理由 |
|---|---|
| **`1.5707963`（90°）** | 与设计文档的原始意图一致，给摆腿、抬脚留足余量 |
| `1.0471975`（60°） | 最小可用值 |
| ~~`0.52359878`（30°）~~ | ❌ **不可用**，站立都够不到 |

**修改位置：`robot.urdf` 里 4 个 `*_thigh` joint 的 `<limit upper="...">`。**

**一行命令批量替换：**

```bash
# 先备份
cp robot.urdf robot.urdf.bak
# 把所有 thigh 的 upper 从 30° 改成 90°
sed -i 's|<limit lower="-0.61086524" upper="0.52359878" effort="3" velocity="8" />|<limit lower="-0.61086524" upper="1.5707963" effort="3" velocity="8" />|g' robot.urdf
# 校验：应该输出 4
grep -c 'upper="1.5707963"' robot.urdf
```

**⚠️ 但这个结论建立在"站立髋高比 h/L = 0.88"的假设上。**

**如果实际站立姿态比这个更高（腿更直），需要的角度会更小：**

```
h/L = 0.975（接近伸直） →  站立只需 +22.6°
h/L = 0.902             →  站立需要 +25.8°
h/L = 0.880（本假设）    →  站立需要 +31.2°
```

**所以仍然以 §9 步骤 5 的实测为准。** 但无论如何，**+30° 都太紧了**。

**⚠️ 另外 `*_calf` 的 ±60° 决定了下蹲能力：**

```
膝 0°   →  髋高 135.9 mm（接近伸直）
膝 +25.76°（站立）→ 髋高 125.7 mm
膝 +60°（上限）  →  髋高 102.5 mm
```

**如果训练需要更深蹲姿，膝盖上限可放宽到 +80° ~ +90°。**

---

## 6. ⚠️ 坐标系与关节零位（最容易搞错的部分）

### 6.1 URDF 的关节角定义

```
URDF revolute joint 的角度 = 该 link 相对【建模姿态】的旋转量

建模姿态 = SolidWorks 装配体里零件被装配好的那个姿态
```

### 6.2 本项目的零位

**从 URDF 的 `<origin>` 长度反推：**

```
hip   → thigh 的 origin 长度 = 64.96 mm   →  0° 时大腿【竖直朝下】
thigh → calf  的 origin 长度 = 75.78 mm   →  0° 时小腿【折着】
```

**结论：`q = 0` 时，机器人处于【弯腿站立姿态】。**

### 6.3 ⚠️ 这意味着什么（⚠️ 必须实测验证）

| 概念 | 含义 |
|---|---|
| **URDF 关节角 0** | CAD 装配姿态 —— **很可能就是弯腿站立姿态** |
| **`q_default`** | **理论上 = [0]*12**，但**必须实测验证** |
| **腿完全伸直** | 需要膝关节反向转约 **-0.6 ~ -1.0 rad** |

**⚠️⚠️ 以下是本文档里最需要小心的一条：**

```
【推断】q = 0 就是站立姿态  →  q_default = [0]*12
【依据】§6.2 的 origin 长度分析 + §5.6 的运动学余量分析
        （站立需要的关节角 +31.19° / +25.76° 与限位量级接近，说明零位在站立姿态附近；⚠️ 其中 +31.19° 恰好超出 +30° 上限）
【风险】这是【推断】，不是实测
```

**👉 必须做的验证（§9 步骤 5）：**

```
在 Isaac Gym 里下发 q = [0]*12，观察机器人姿态：

  ✅ 腿微弯、机身水平、四脚着地   →  零位 = 站立姿态，q_default = [0]*12
  ❌ 腿伸直 / 腿折叠 / 机身歪斜 / 倒下  →  零位不是站立姿态
                                          →  必须实测出真实的 q_default
```

**⚠️ 如果验证失败，§5.6 的整个余量分析都要重做 —— 因为它假设了零位在站立姿态附近。**

### 6.4 ✅ 限位已经修正（新版 `robot.urdf`）

**旧版那个错误的膝限位（`[1.0472, 2.6180]`）已经在网页版工具里重新生成，现在是：**

| 关节 | 新限位 | 含 0 |
|---|---|---|
| `*_hip` | 0 ~ +40° | ✅ |
| `*_thigh` | −35° ~ +30° | ✅ |
| `*_calf` | −60° ~ +60° | ✅ |

**✅ 12 个关节全部包含 0，站立姿态可达。**

**⚠️ 但见 §5.6：`*_thigh` 的 +30° 上限小于站立所需的 +31.19°，站立姿态超出限位 —— §9 步骤 6 有修复命令。**

**如果需要调整限位，直接改 `robot.urdf` 里对应 `<joint>` 的 `<limit lower=".." upper="..">`。**

**旧版备份（供参考，不要用）：**

```
Mechanic/URDF/CAT_defeature.SLDASM/urdf/CAT_defeature.SLDASM.urdf
Mechanic/URDF/CAT_defeature.SLDASM/urdf/CAT_defeature.SLDASM.urdf.bak
Mechanic/URDF/CAT_defeature.SLDASM/urdf/CAT_defeature.SLDASM.urdf.bak_limit
```

### 6.5 固件侧的对应关系

**真机部署时需要标定一个偏移量：**

```c
// 关节角 -> 舵机角
servo_angle[i] = joint_angle[i] + joint_offset[i];

// 标定方法：让机器人自然站立，读舵机位置
//   因为站立时 joint_angle == 0，所以 joint_offset == 舵机读数
```

**⚠️ 标定姿态就是站立姿态 —— 这是本设计的优点，不需要特殊夹具。**

**⚠️ 绝对不要用"腿完全伸直"作标定姿态**（机器人站不住、且是运动学奇异点）。

---

## 7. ⚠️ Isaac Gym 加载要点（避坑清单）

### 7.1 ✅ mesh 路径已经是对的（不需要改）

**新版 `robot.urdf` 里已经是相对路径：**

```xml
<mesh filename="meshes/part_1.stl" scale="0.001 0.001 0.001" />
```

**✅ 不需要做任何替换。** 旧版那个 `package://` 问题在新版里不存在。

**相对路径的解析基准是 `gym.load_asset` 的 `asset_root` 参数：**

```python
asset_root = os.path.expanduser("~/rlcat/urdf")     # 该目录下必须有 meshes/
asset = gym.load_asset(sim, asset_root, "robot.urdf", asset_options)
```

**⚠️ `asset_root` 指向包含 `robot.urdf` 和 `meshes/` 的那个目录。**

**校验命令：**

```bash
cd ~/rlcat/urdf
ls robot.urdf meshes/ | head            # 应看到 robot.urdf 和 meshes
ls meshes/*.stl | wc -l                 # 应该是 26
grep -c 'filename="meshes/' robot.urdf  # 应该是 26
```

### 7.2 ✅ mesh 单位已确认：毫米，`scale="0.001"` 必需

**实测两个版本的 STL 原始顶点数据（同一个 base_link 零件）：**

| 版本 | 第一个顶点 | 包围盒 | 单位 |
|---|---|---|---|
| 旧版 `base_link.STL` | `(0.0760, −0.0652, 0.0050)` | 0.164 × 0.130 × 0.068 | **米** |
| **新版 `part_1.stl`** | `(76.0000, −65.2300, 5.0000)` | **164.0 × 130.5 × 68.0** | **毫米** |

**⚠️⚠️ 关键：两版的 STL 原始单位【不同】，相差 1000 倍。**

```
新版 STL 用毫米      →  URDF 里 scale="0.001"  →  最终 0.164 m   ✅
旧版 STL 用米        →  URDF 里【没有】scale    →  最终 0.164 m   ✅

两版最终结果【相同】，但【不能混用】：
  把旧版 STL 配新版 URDF（有 scale） → 机器人缩小 1000 倍 ❌
  把新版 STL 配旧版 URDF（无 scale） → 机器人放大 1000 倍 ❌
```

**👉 必须【整套使用】：`urdf/robot.urdf` + `urdf/meshes/` 是配套的，不要和旧版混用。**

**加载后的校验判据：**

```
base_link 的包围盒应该是 0.164 × 0.130 × 0.068 m
如果看到 164 或者 0.000164  →  STL 和 URDF 不配套
```

**⚠️ 勘误：** 本文档早期版本曾误判"STL 是米、不要加 scale"——那是基于**旧版**文件得出的，对**新版不适用**。请以本节为准。

### 7.3 建议的加载参数

```python
asset_options = gymapi.AssetOptions()
asset_options.fix_base_link = False          # 调试 PD 时设 True
asset_options.default_dof_drive_mode = gymapi.DOF_MODE_POS
asset_options.use_mesh_materials = True
asset_options.vhacd_enabled = False          # 关闭凸分解（太慢）
asset_options.replace_cylinder_with_capsule = True
asset_options.thickness = 0.001
```

### 7.4 仿真参数（和固件对齐）

```python
sim_params = gymapi.SimParams()
sim_params.dt = 1.0 / 200.0                  # 物理 200 Hz
sim_params.substeps = 2                      # → 控制 100 Hz（和固件一致）
sim_params.up_axis = gymapi.UP_AXIS_Z
sim_params.gravity = gymapi.Vec3(0, 0, -9.81)
sim_params.physx.solver_type = 1
sim_params.physx.num_position_iterations = 4
sim_params.physx.num_velocity_iterations = 1
sim_params.physx.use_gpu = True
```

### 7.5 ⚠️ 碰撞体要换成基本几何体

**URDF 的 `<collision>` 用的是 STL 网格 → PhysX 处理极慢。**

```
视觉（visual）  → 保持 STL
碰撞（collision）→ 换成 box / sphere
    · base_link、thigh、calf  →  box
    · 足端                    →  sphere（半径 9 mm）
```

**⚠️ 尤其足端不能用网格，否则接触检测会出问题。**

### 7.6 ⚠️ DOF 顺序必须核对

**Isaac Gym 可能重排 DOF 顺序。加载后立刻打印：**

```python
print(gym.get_asset_dof_names(asset))
```

**和 §2.4 的定义对照。如果顺序不一致：**

```
❌ 不要改 URDF
✅ 在代码里建重映射表
```

---

## 8. 仿真环境需要"手工补上"的东西

### 8.1 URDF 不描述的内容

| 缺失项 | 补法 | 参数初值 |
|---|---|---|
| **PD 增益** | `dof_props["stiffness"]` / `["damping"]` | stiffness 20, damping 0.5 |
| **力矩饱和** | `dof_props["effort"]` | 3.0 N·m |
| **速度饱和** | `dof_props["velocity"]` | 8.0 rad/s（可收紧到 4.71） |
| **纯延迟** | 动作队列，延迟 N 步 | 1–3 步 |
| **回程间隙** | 位置死区 | ≦0.5°（可先不做） |
| **摩擦** | `dof_props["friction"]` / `["damping"]` | 先 0，标定后填 |

### 8.2 驱动器模型参考实现

```python
# PD 控制
tau = stiffness * (q_target - q) - damping * qd
tau = clip(tau, -effort, effort)

# 纯延迟
action_buffer.append(action)
delayed_action = action_buffer.pop(0)

# 速度饱和（Isaac 内部处理，但要确认 effort 设对）
```

**⚠️ PD 增益的物理来源：**

```
Kt = 1.079 N·m/A
额定电流 900 mA → 额定力矩 0.97 N·m
堵转 2.7 A → 2.9 N·m

stiffness 从"能站住的最小值"试起（15 ~ 25）
damping  ≈ stiffness / 20 ~ stiffness / 40
```

---

## 9. ⭐ 当前待办（Ubuntu Agent 从这里开始）

### 步骤 1：拷贝文件

**把整个 `Mechanic/URDF/urdf/` 目录拷到 Ubuntu（例如 `~/rlcat/urdf/`）：**

```bash
mkdir -p ~/rlcat
# 从 Windows 传输（三选一）：
#   A. scp（推荐）
scp -r "<user>@<Windows的IP>:'<repo>/Mechanic/URDF/urdf'" ~/rlcat/
#   B. 打包后 U 盘 / 网盘
#      Windows 端把 urdf/ 整个目录压成 zip，拷过去后 unzip
#   C. rsync（若已配 SSH）
rsync -avz user@win-host:"/c/Users/<user name>/Desktop/RL-CAT/Mechanic/URDF/urdf/" ~/rlcat/urdf/
```

**拷完后目录布局应该是：**

```
~/rlcat/urdf/
├── robot.urdf          ← 主文件
├── meshes/             ← 26 个 part_N.stl
├── parts.json
├── user_model.json
└── export_report.json
```

**⚠️ `robot.urdf` 和 `meshes/` 必须保持同级关系（URDF 里用的是相对路径 `meshes/part_N.stl`）。**

**⚠️ 不要带旧版目录 `CAT_defeature.SLDASM/`（限位错误、路径是 ROS 格式）。**

### 步骤 2：校验文件完整性

**新版 URDF 的路径已经是相对的，不需要做任何替换。** 直接校验：

```bash
cd ~/rlcat/urdf
ls meshes/*.stl | wc -l                 # 应该输出 26
grep -c 'filename="meshes/' robot.urdf  # 应该输出 26
grep -c 'scale="0.001 0.001 0.001"' robot.urdf   # 应该输出 26
```

**⚠️ 如果第三个命令不是 26，说明 `scale` 丢了 —— 那会得到 1000 倍大的机器人。**

### 步骤 2.5：离线检查 URDF（不用加载进仿真）

| 方式 | 依赖 | 说明 |
|---|---|---|
| **check_urdf** | `liburdfdom-tools` | `sudo apt install liburdfdom-tools && check_urdf robot.urdf`，验证语法和树结构 |
| **在线预览** | 浏览器 | 把目录打包成 zip 拖到 urdf.online。⚠️ 只能看，不能测物理 |
| **Isaac Gym viewer** | Isaac Gym | 最权威 —— 加载并渲染，同时能打印所有属性 |

**推荐顺序：`check_urdf` 验语法 → Isaac Gym 加载验物理。**

**`check_urdf` 的期望输出：**

```
root Link: base_link has 4 child(ren)
    child(1):  lf_hip
    child(2):  lb_hip
    child(3):  rf_hip
    child(4):  rb_hip
```

**⚠️ 如果 `check_urdf` 就报错，不要继续往下走 —— 先修 URDF 语法。**

### 步骤 3：写最小加载脚本，打印信息

**脚本要输出：**

```python
print("刚体数 :", gym.get_asset_rigid_body_count(asset))     # 期望 13
print("DOF 数 :", gym.get_asset_dof_count(asset))            # 期望 12
print("刚体名 :", gym.get_asset_rigid_body_names(asset))
print("DOF 名 :", gym.get_asset_dof_names(asset))
props = gym.get_asset_dof_properties(asset)
for i, n in enumerate(gym.get_asset_dof_names(asset)):
    print("  %-12s lower=%8.4f upper=%8.4f" % (n, props['lower'][i], props['upper'][i]))
print("总质量 :", sum(gym.get_asset_rigid_body_mass(asset, i)
                    for i in range(gym.get_asset_rigid_body_count(asset))))
```

**期望结果：**

| 项 | 期望值 |
|---|---|
| 刚体数 | **13** |
| DOF 数 | **12** |
| **总质量** | **1.386 kg** |
| DOF 名顺序 | 与 §2.4 的 B 表对照 |
| hip 限位 | 0 ~ 0.6981317 |
| thigh 限位 | -0.61086524 ~ 0.52359878 |
| calf 限位 | -1.0471975 ~ 1.0471975 |

**⚠️ 同时报告所有 warning / error。**

### 步骤 4：验证轴向（⚠️ 最重要）

**给每个关节一个正角度（如 +0.3 rad），观察运动方向：**

| 关节 | 期望运动 |
|---|---|
| `*_hip` | 腿**向外摆**（左右开合） |
| `*_thigh` | 大腿**前后摆** |
| `*_calf` | 小腿**弯曲** |

**⚠️ 关键判据：四条腿的运动方向必须【对称】。**

```
左前腿向外摆  →  右前腿也应该向外摆
如果有腿往反方向动  →  该关节的 axis 需要取负
```

**⚠️ 还要注意：`*_thigh` 的限位上限只有 +30°，给 +0.3 rad（17.2°）没问题，但不要给太大。**

### 步骤 5：确定 `q_default`（⭐ 决定后面所有工作）

**下发 `q = [0]*12`，看机器人姿态：**

```
✓ 腿微弯、机身水平、四脚着地  →  q_default = [0]*12  ✅ 与文档推断一致
✗ 腿伸直 / 腿折叠 / 机身歪斜 / 倒下  →  零位不是站立姿态
                                      →  必须实测出真实的 q_default
```

**⚠️ 如果结果不是"站立"，请立刻回传，因为 §5.6 的余量分析要重做。**

### 步骤 6：⚠️ 放宽 `*_thigh` 的限位上限（必须做）

**§5.6 的计算显示：站立姿态需要 `*_thigh ≈ +31.19°`，而限位上限是 +30° —— 站立姿态超出限位。**

```bash
cd ~/rlcat/urdf
cp robot.urdf robot.urdf.bak                       # 备份
sed -i 's|upper="0.52359878"|upper="1.5707963"|g' robot.urdf
grep -c 'upper="1.5707963"' robot.urdf             # 应该输出 4
```

**⚠️ 如果步骤 5 的实测显示站立姿态不是 `q=0`（例如需要负角度），上面的替换会不适用 —— 请先回传实测结果。**

**⚠️ 放宽限位不会引入风险**：真正的限幅由 PD 控制器和舵机过流保护完成，URDF 的 limit 只是仿真里的软约束。

### 步骤 7：换碰撞体

**新版 URDF 已经有独立的 collision mesh（`part_2/4/6/...`），但仍建议换成 box / sphere 以提升物理性能（见 §7.5）。**

### 步骤 8：PD 站立测试

```python
asset_options.fix_base_link = True    # 先焊死
q_target = q_default                  # 站立姿态
# 观察：关节是否稳定、力矩大小是否合理
```

**然后放开底座（`fix_base_link = False`），看能否站住。**

---

## 10. 后续路线图

```
[已完成] 机械设计 → URDF 导出 → 质量属性修正 → 限位修正（部分）
   ↓
[当前]   §9 的 8 个步骤（Isaac Gym 加载 + 验证）
   ↓
[下一步] PD 控制验证（不开 RL）
   ↓
[下一步] 环境工程化：并行环境、观测(50维)、动作(12维)、奖励
   ↓
[下一步] PPO 训练：站立 → 转向 → 行走 → 全向 → 地形
   ↓
[下一步] 域随机化（质量、摩擦、延迟、PD 增益、IMU 噪声）
   ↓
[下一步] 仿真压力测试（扰动、延迟扫描、长时间运行）
   ↓
[下一步] 真机系统辨识（阶跃响应、扫频、摩擦、延迟）
   ↓
[下一步] 反哺仿真 → 重训（迭代 2~3 轮）
   ↓
[最后]   真机部署（吊起 → 落地 → 低速 → 放开）
```

**⚠️ 三个最容易被跳过、但代价最大的环节：**

| # | 环节 | 后果 |
|---|---|---|
| 1 | **PD 控制验证** | RL 学不会时分不清是奖励问题还是物理问题 |
| 2 | **驱动器模型（延迟/饱和）** | 仿真里舵机是理想的，真机上震荡 |
| 3 | **系统辨识** | sim-to-real 差距全靠域随机化硬扛，策略过度保守 |

---

## 11. 附录：已有的工具脚本

**位置**：`Mechanic/URDF/`（Windows 端）

| 脚本 | 功能 | 用法 |
|---|---|---|
| `patch_mass.py` | 用实测值替换 URDF 的 mass / inertia | `python patch_mass.py` |
| `patch_limits.py` | 按关节类型批量补全 limit / effort / velocity | `python patch_limits.py` |

**⚠️ 两个脚本都会自动备份原文件（`.bak` / `.bak_limit`）。**

**质量属性原始数据**：`Mechanic/质量属性.txt`

---

## 12. 附录：观测/动作定义（RL 接口）

### 观测（50 维，⚠️ 固件与仿真必须位对齐）

| 索引 | 内容 | 缩放 | 维度 |
|---|---|---|---|
| **0–2** | **重力向量（机身系，从四元数反算）** | 1.0 | 3 |
| **3–5** | **机身角速度（陀螺）** | ×0.25 | 3 |
| 6–8 | 速度指令 (vx, vy, ωz) | 1.0 | 3 |
| 9–20 | 关节位置 (12) | 1.0 | 12 |
| 21–32 | 关节速度 (12) | ×0.1 | 12 |
| 33–44 | 上一帧动作 (12) | **×4.0** | 12 |
| 45–46 | 步态相位 sin / cos | 1.0 | 2 |
| **47–49** | **保留 / 待定** ⚠️ | — | **3** |
| | | **合计** | **50** |

**⚠️ 勘误：** 本文档早期版本的表格漏了第 47–49 行的 3 维，导致相加只有 47 维。**50 维是设计值，那 3 维的具体用途待定**（候选：机身线速度估计、足端接触标志、上一帧力矩）。

**⚠️ 关于 ×4.0 的解释：** 动作的实际尺度是 `0.25 rad/单位`（见下），所以观测里的"上一帧动作"要做**逆缩放**——把"被缩放后的动作"还原成约 ±1 的量级，即除以 0.25 = **×4.0**。两者是配套的，不是矛盾。

**⚠️ 关于 ×0.25 / ×0.1：** 这些缩放系数是让各维度的数值量级相近，便于网络学习。**固件和仿真必须用同一套系数**，否则策略行为不一致。

**⚠️ 重力向量不要用欧拉角**（±90° 附近有奇异）。

### 动作（12 维）

```
q_target[i] = q_default[i] + 0.25 * action[i]     # rad
然后 clamp 到软限位
```

**⚠️ `action` 经过 tanh 后落在 [-1, 1]，所以单步最大改变 0.25 rad（14.3°）。**

**⚠️ 软限位 = 硬限位再内缩一点**（例如内缩 5°），防止策略把关节顶到硬限位。**具体数值待定。**

### 策略网络

```
Actor:  MLP [256, 128, 64]
Critic: MLP [256, 128, 64]
算法:   PPO
推理:   ~200 Hz（真机上），导出 ONNX
```

**⚠️ 控制频率是 100 Hz（见 §2.2）—— "200 Hz" 指策略推理能力，实际下发仍按 100 Hz 控制周期。两者不冲突。**

---

## 13. 关键提醒汇总

**按新版权威文件（`Mechanic/URDF/urdf/robot.urdf`）重新评估：**

| # | 提醒 | 严重度 | 状态 |
|---|---|---|---|
| 1 | **`*_thigh` 的 +30° 上限 < 站立所需的 +31.19°** —— 站立姿态超出限位 | 🔴 阻塞 | **§9 步骤 6 有修复命令** |
| 2 | `q_default` 必须实测验证（推断是 `[0]*12`） | 🔴 高 | 待验证 |
| 3 | 其余 11 个关节的轴向未验证 | 🔴 高 | 待验证 |
| 4 | DOF 顺序几乎肯定与 §2.4 的分组顺序不同，必须做映射 | 🟡 中 | 已给映射表 |
| 5 | 驱动器**延迟**必须手工加（URDF 里没有） | 🟡 中 | 待实现 |
| 6 | `velocity = 8` 高于真机空载 4.71 rad/s，可按需收紧 | 🟡 中 | 可选 |
| 7 | 碰撞体建议换成 box / sphere（已独立导出，但仍较大） | 🟡 中 | 待优化 |
| 8 | 观测第 47–49 维的用途待定 | 🟡 中 | 待定义 |
| 9 | `rb_hip` 的 CoM 是镜像推断值 | 🟢 低 | 可接受 |
| 10 | 总质量 1.386 kg 可能比真机轻（电池/线缆未完全计入） | 🟢 低 | 待重新称重 |

**✅ 已解决、不用再管的问题：**

| # | 曾经的疑点 | 现状 |
|---|---|---|
| 1 | mesh 路径 `package://` | ✅ 新版已是相对路径 |
| 2 | mesh 单位 / `scale` | ✅ 已确认是 mm，`scale="0.001"` 已写入 |
| 3 | 限位数值错误（膝 60°~150°） | ✅ 新版已重新生成 |
| 4 | `lf_calf` 的 axis 符号异常 | ✅ 新版已统一 |
| 5 | 12 个关节限位是否含 0 | ✅ 全部包含 |
| 6 | XML 语法 / 引用有效性 | ✅ 已验证 |

---

**文档结束。有问题请在 §9 的步骤中标注，或直接向 Windows 端的作者提问。**
