vrrrrs/RL-CAT/archive/方案_v1.md

# RL-CAT 强化学习四足机器人 — 方案基准

> 本文档汇总方案讨论阶段的全部结论。
> **标注规则**
> - ✅ **已定稿** — 已经过推导或规格书确证，可以直接据此设计
> - ⚠️ **待实测** — 需要硬件到手后验证，验证方法已写明
> - ❌ **已否决** — 讨论中排除的方案，附否决理由（避免以后重复讨论）
>
> 最后更新：方案讨论阶段结束

---

## 0. 项目概要

| 项 | 内容 |
|---|---|
| 目标 | 12 自由度舵机四足，可做强化学习（sim-to-real） |
| 总重 | **≈ 1.775 kg** |
| 尺寸 | 腿长 120 mm；机身芯 230 × 80 × 58 mm；整体站立高 ≈ 164 mm |
| 控制环 | **100 Hz**（STM32 侧），策略推理 100 Hz（Pi 侧） |
| 上位机 | Raspberry Pi 5 4GB（已有） |
| 下位机 | STM32F103C8（复用 Cat 项目那块） |
| 舵机 | Feetech ST-3215-C018 × 12（12V 版） |
| 电源 | 3S 21700（11.1 V 标称） |
| ROS 2 | **不使用**（日后接 LiDAR 时再引入） |

### 设计优先级
**功能最优先，力求小巧美观。** 外观优化推迟到功能跑通之后。

---

## 1. 机械尺寸与关节距离

### 1.1 坐标约定

```
机身坐标系（世界坐标，单位 mm）
  原点 = 机身中段中心在地面上的投影
  X 轴 = 向前（机头方向）
  Y 轴 = 向左
  Z 轴 = 向上（地面 = 0）

腿的横向位置：左前 LF / 左后 LH 在 y > 0；右前 RF / 右后 RH 在 y < 0
```

### 1.2 关节轴定义

| 关节 | 转轴方向 | 功能 |
|---|---|---|
| **髋外摆** Hip Abduction | **沿 X（前后）** | 腿在额状面内外摆 |
| **髋俯仰** Hip Pitch | **沿 Y（左右）** | 腿在矢状面前后摆 |
| **膝** Knee | **沿 Y（左右）** | 小腿前后摆 |

> ⚠️ 这是本节最容易搞错的地方。外摆轴是**前后方向**，所以外摆舵机的输出轴指向前后，其 40.2 mm 的机体长度落在**机身长度方向**上，不是宽度方向。

### 1.3 站立姿态下的关节坐标（以左前腿 LF 为例）

| 关节 | X | Y | Z |
|---|---|---|---|
| 髋外摆轴 | +75 | +30.2 | 105.6 |
| 髋俯仰轴 | +75 | +40 | 90.6 |
| 膝 | +103.5 | +40 | 37.8 |
| 足端 | +75 | +40 | 0 |

左后腿 LH 的 X 取 −75，Y 相同。

### 1.4 关节间距离（核心）

| # | 距离 | 数值 | 说明 |
|---|---|---|---|
| 1 | 髋外摆轴 → 髋俯仰轴 | **16.6 mm** | 水平外偏 9.8，垂直下沉 15.0 |
| 2 | **髋俯仰轴 → 膝（大腿）** | **60.0 mm** | 轴心到轴心 |
| 3 | **膝 → 足端（小腿）** | **60.0 mm** | 轴心到足端 |
| 4 | **髋俯仰轴 → 足端（总腿长 L）** | **120.0 mm** | 站立姿态直线距离 |
| 5 | 足端相对髋俯仰轴的水平偏移 | **0 mm** | 站立时足在髋正下方 |
| 6 | **足端相对膝的水平偏移（膝力臂 b）** | **28.5 mm** | 决定膝扭矩的几何量 |

### 1.5 髋轴间距

| 项 | 数值 |
|---|---|
| **纵向髋距 Lh**（前轴到后轴） | **150 mm**（= 1.25 × 腿长） |
| **横向髋距 Wh**（左轴到右轴） | **60.4 mm** |
| 横向髋距（靠髋俯仰轴算） | 80 mm |

⚠️ **建议把外摆臂从 16.6 mm 加大到 20~22 mm**，横向髋距变成 74~78 mm，静态侧向稳定裕度大幅改善；**外摆扭矩只从 19 mN·m 涨到 28 mN·m，仍可忽略。**

### 1.6 站立姿态关节角

| 关节 | 角度 | 说明 |
|---|---|---|
| 髋外摆 | 0° | 腿平面竖直 |
| 髋俯仰 | 28.4° | 与垂直方向夹角 |
| **膝** | **123.3°** | 大腿与小腿夹角（落在 90~130° 力矩最优区） |
| 站姿比 h/L | 0.88 | 髋高 105.6 / 腿长 120 |
| 大腿与垂直夹角 α | 28.4° | |
| 小腿与垂直夹角 β | 28.4° | |

### 1.7 工作空间

| 项 | 数值 |
|---|---|
| 腿完全伸直长度 | 120 mm |
| **建议膝活动范围** | **60° ~ 150°** |
| 对应腿长范围 | 60 ~ 120 mm |
| 对应站高范围 | 52.8 ~ 114 mm |
| 足端可达半径 | 60 ~ 120 mm |
| 足端形式 | 球形橡胶足，半径 8~10 mm |
| **足端预留（v1 不装，只留结构）** | 脚垫内留 **8×8×3 mm 空腔**给微动开关；小腿/大腿侧面留 **2×3 mm 走线槽**；**膝、髋两处各留 ≥15 mm 的走线松弛环** |

### 1.8 机身尺寸

| 项 | 数值 |
|---|---|
| **机身芯（长×宽×高）** | **230 × 80 × 58 mm** |
| 含肩部总宽 | ≈ 125 mm（舵机嵌入侧壁可到 105） |
| 含肩部总长 | ≈ 250 mm |
| 整体站立高度 | ≈ 164 mm |
| 机身底面离地 | ≈ 47.7 mm |

**宽度由 3S 电池横排决定**：Pi 5 板宽 56 → 需求 68；**3S 21700 ×3 横排 66 → 需求 78**；PCB 58 → 需求 70。取最大 = 78~80 mm。

**高度下限 66 mm（逐层堆叠），认真优化后 58 mm**：
```
底部 PCB(元件朝下) 5.6 + 间隙 3 + Pi5 17 + 散热片 5 + 间隙 3
+ 21700(横向2颗) 21.3 + 支架 3 + 间隙 3 + 顶盖 2 ≈ 63 mm
降到 58 mm 的办法：Pi 竖装(-12) / 电池拆分 2+1(-9) / 连接器侧开窗(-3)
```

### 1.9 重心与稳定性

| 项 | 数值 | 评价 |
|---|---|---|
| 重心高度 | **≈ 54 mm** | 远低于髋轴 105.6 mm ✅ 有利 |
| 支撑多边形 | 150 × 60.4 mm | |
| 静态稳定裕度（侧向） | 30.2 mm | 偏小，靠加大外摆臂改善 |

⚠️ **机身长度 230 mm 和横向偏移 40 mm 必须用 CAD 试装配确认**，其余是从运动学唯一解出的。

---

## 2. 重量预算

| 项 | 重量 | 备注 |
|---|---|---|
| 舵机 ST-3215-C018 × 12 | **660 g** | 规格书实测 55±1 g |
| 21700 电芯 × 3 | 210 g | P42A / 40T 级 |
| 3S 电池支架 + 镍带 | 50 g | |
| Pi 5 + 主动散热 + 128G SSD | 135 g | |
| STM32 + IMU + PCB + 电源 | 60 g | |
| 结构件（机身 + 4 腿 + 髋支架） | 380 g | 尼龙 / PETG |
| 舵盘 / 轴承 / 紧固件 × 12 组 | 100 g | **舵盘必须金属**（25T/OD5.9） |
| 线缆 / 接插件 / 去耦 | 90 g | |
| 外壳 / 防撞 / 足垫 | 90 g | |
| **合计** | **≈ 1775 g** | |

**注意：舵机占总重 37%**，这是小型四足无法回避的物理约束。

---

## 3. 舵机选型

### 3.1 选定型号：**Feetech ST-3215-C018**

| 参数 | 值 | 来源 |
|---|---|---|
| 名称 | 12V 30KG.CM 塑料壳金属齿磁编码双轴 TTL 串型舵机 | 规格书 |
| 工作电压范围 | **6 ~ 14 V** | 规格书 |
| 典型工作电压 | 12 V | 规格书 |
| 空载速度 | 0.222 sec/60°（45 RPM） | 规格书 |
| 空载电流 | 200 mA | 规格书 |
| **堵转扭矩** | **30 kg·cm = 2.942 N·m** @12V | 规格书 |
| **堵转电流** | **2.7 A** | 规格书 |
| 静态电流 | 30 mA | 规格书 |
| **额定扭矩** | **10 kg·cm = 0.981 N·m** | 规格书 |
| **额定电流** | **900 mA** | 规格书 |
| Kt 常数 | 11 kg·cm/A | 规格书 |
| 电机内阻 | 7.9 Ω | 规格书 |
| 角度传感器 | **12 Bit 磁编码**（非电位器）✅ | 规格书 |
| 齿轮材质 | **铜**（金属齿） | 规格书 |
| 轴承 | 滚珠轴承 | 规格书 |
| **齿轮虚位 Back Lash** | **≦ 0.5°** ✅ | 规格书 |
| 出力轴 | 25T / OD 5.9 mm | 规格书 |
| 尺寸 / 重量 | **45.2 × 24.7 × 35 mm / 55±1 g** | 规格书 |
| 分辨率 | 0.088°（360°/4096） | 规格书 |
| 反馈字段 | Load / Position / Speed / 电压 / **电流** / 温度 | 规格书 |
| 控制算法 | PID（**支持修改**） | 规格书 |
| 接口 | 5264-3P，线长 15 cm | 规格书 |
| 引脚定义 | **1=GND, 2=Vcc, 3=Signal/TTL** | 规格书 |
| 协议 | 半双工异步串行，8bit/1stop/无校验 | 规格书 |
| 波特率 | 38400 ~ 1 Mbps（**出厂默认 1 Mbps**） | 规格书 |
| **最大位置更新率** | **1 ms** | 规格书 |
| 信号电平 | 高 2~5 V，低 0~0.45 V（**3.3V 直连兼容**） | 规格书 |
| **过流保护** | **>2 A 持续 2 s → 关输出**（可自定义） | 规格书 |
| 过压保护 | >14 V 或 <4 V 进入保护 | 规格书 |
| 过热保护 | >70 °C 关扭矩输出 | 规格书 |
| 可设波特率 | 1000000 / 500000 / 250000 / 128000 / 115200 / 76800 / 57600 / 38400 | 官方文档 |

### 3.2 为什么选 C018（同系列三款的对比）

| 型号 | 额定电压 | 堵转扭矩 | 空载转速 | 堵转电流 | 齿轮 | 能否上 3S |
|---|---|---|---|---|---|---|
| **ST-3215-C018** | **12 V（6~14V）** | **30 kg·cm @12V** | 45 RPM | 2.7 A | 铜 | ✅ **可以** |
| STS3215-C001 | 7.4 V（4~7.4V） | 19.5 kg·cm @7.4V | 52 RPM | 2.5 A | 铜 | ❌ 12.6V 超上限 |
| ST-3215-C044 | 7.4 V（5~8.4V） | 16.0 kg·cm @7.4V | 86 RPM | 3.8 A | 铜 | ❌ 12.6V 超上限 |

**决定性理由：3S 满电 12.6 V，只有 C018 的电压范围（6~14 V）兼容。** C001 / C044 是 7.4 V 器件，接 3S 会被过压保护切断。

**而且 C018 在扭矩上也是三款里最强的**（额定扭矩 0.981 N·m vs C001 0.490 / C044 0.510）。

**三款尺寸重量完全相同（45.2×24.7×35 mm，55 g），所以换型号不影响机械设计。**

### 3.3 扭矩校核（按 3S 实际电压）

**3S 电压范围 9.0 V（空电）~ 12.6 V（满电），扭矩与电压近似线性：**

| 电压 | 堵转扭矩 | **额定扭矩** | 膝关节余量（需求 0.620 N·m） |
|---|---|---|---|
| 12.6 V（满电） | 31.5 kg·cm = 3.09 N·m | 1.030 N·m | 40% |
| **11.1 V（标称）** | **27.8 kg·cm = 2.72 N·m** | **0.907 N·m** | **32%** ✅ |
| 9.0 V（空电） | 22.5 kg·cm = 2.21 N·m | 0.736 N·m | 16% ⚠️ |

**各关节扭矩需求（机体 1.775 kg，D=2.5）：**

| 关节 | 需求扭矩 | 占 11.1V 额定 | 判定 |
|---|---|---|---|
| **膝**（唯一关键关节） | **0.620 N·m** | **68%** | ✅ 余量 32% |
| 髋俯仰（足偏 30 mm） | 0.326 N·m | 36% | ✅ 充裕 |
| **髋外摆**（臂 15 mm，摆 25°） | **0.019 N·m** | **2%** | ✅ 可忽略 |

**膝扭矩公式（已验证）：**
```
τ_knee = D · (m·g/4) · b        b = 膝力臂 = 28.5 mm（站立姿态）
       = 2.5 · (1.775·9.81/4) · 0.0285 = 0.620 N·m
```

⚠️ **低压报警建议设在 9.9 V（3.3 V/cell）**，不要用到接近空电（9 V 时余量只剩 16%）。

### 3.4 采购清单

| 项 | 数量 | 备注 |
|---|---|---|
| **ST-3215-C018** | **13 个** | 12 装机 + 1 备件。**一定要确认是 C018（12V 版），外观与 C001/C044 完全相同** |
| 金属舵盘 25T | 12 + 2 | 塑料舵盘会滑齿，不能省 |
| 5264-3P 延长线 | 若干 | 原配 15 cm 对 120 mm 腿长可能偏短 |
| USB 调试板 | 1 | 改 ID / 标定用 |

### 3.5 ❌ 已否决的舵机方案

| 方案 | 否决理由 |
|---|---|
| PWM 舵机（MG996R 等） | **无位置反馈** → RL 观测缺 `q, q̇`，根本做不了 |
| 幻尔 HTS-35H / LX-824HV | 官方页明确写 **"采用进口高精度电位器作为角度反馈"** → 电位器会零位漂移、分辨率低、速度差分信号是噪声 |
| Hiwonder LX-16A | 240° 限幅 + 疑似电位器 |
| Dynamixel XM430-W350-T | 性能好但 12 个约 ¥25000，是 C018 方案的 10 倍 |
| 混用不同型号 | 同一总线只能有一个电压；混用要两套电源两套固件，省不到 ¥200 |

---

## 4. 电源与配电

### 4.1 电源架构

```
3S 21700 (11.1V 标称 / 9.0~12.6V)
  │
  ├─→ [TVS SMBJ15A] ─→ [P-MOS 反接保护] ─→ 电源开关
  │
  ├─→ 舵机动力（粗线直供，见 4.3）
  │      C018 × 12，3S 全程在 6~14 V 范围内 ✅
  │
  ├─→ 驱动板供电（细线，20~50 mA）
  │      Bus Servo Adapter (A)，9~12.6 V 输入 ✅
  │
  └─→ 5V/5A 降压模块（带散热片）
         └─→ USB-C 母座（CC 各 5.1kΩ 下拉）──→ Pi 5 的 USB-C 口
         └─→ 独立 3.3V 降压（≥800mA）──→ STM32 + JY901P + ESP32-C3
```

### 4.2 电流预算

| 负载 | 电流 |
|---|---|
| 12 舵机最坏（2 A 保护上限 × 12） | 24.0 A |
| 12 舵机额定常态 | 10.8 A |
| 12 舵机空载 | 2.4 A |
| Pi 5 峰值（25 W @12V，降压 85%） | 2.5 A |
| **母线最坏总电流** | **≈ 26.5 A** |

**但舵机自身的 2 A 过流保护会先动作，所以电芯和线材按 24 A 设计即可。**

### 4.3 配电方案（解决驱动板 5 A 限制）

⚠️ **Waveshare 官方 FAQ 明确：Bus Servo Adapter (A) 最大电流 5 A。** 而且它**没有板载稳压**（输入多少输出多少），所以它只是通路，不是配电盘。

**解决办法：电源旁路。** 从驱动板电源端子引粗线，直接连到舵机接口。

```
电池 + ──┬── 细线 ──→ 驱动板 DC/端子（仅供板子自身 20~50mA）
         └── 粗线 ──→ 舵机 V（各舵机）
电池 − ──┬── 细线 ──→ 驱动板 GND
         └── 粗线 ──→ 舵机 G   ← 必须与 V 成对旁路！
驱动板 D ──→ 舵机 1 D ──→ 舵机 2 D ──→ ...（12 个菊花链）
```

**三个前提：**
1. **V 和 G 必须成对旁路** — 只旁路 V 不旁路 G，大电流会从驱动板 G 回流，照样过流
2. **驱动板自己的 V/G 仍要接**（供板上串口 IC），但与舵机动力线分开走
3. **线径按最坏电流选，不是按常态 0.4 A**

| 每根线带的舵机数 | 最坏电流 | 线径 |
|---|---|---|
| 3 个 | 6.0 A | 18 AWG |
| 4 个 | 8.0 A | 18 AWG |
| **6 个** | **12.0 A** | **16 AWG** |
| 12 个 | 24.0 A | 14 AWG |
| 电池 → PCB 主回路 | 26.5 A | **16 AWG + XT30** |

### 4.4 电容配置（尽量直插，尽量少焊）

**舵机内部已有电解电容**，所以最有效的一级已具备。按"需要程度"分三档：

| 位置 | 器件 | 封装 | 处理方式 |
|---|---|---|---|
| **舵机母线**（最关键） | 电解 **2200 µF / 25 V** | **直插** | ✅ **必须**，但**装在接线端子上，不碰 PCB**（见下） |
| ESP32 的 5 V 输入 | 电解 100 µF + 瓷片 100 nF | **直插** | 🟡 **建议焊上**（WiFi 500 mA 尖峰） |
| Mini560 输入/输出 | 电解 470~1000 µF / 25 V | 直插 | 🟡 留焊盘 |
| STM32 的 5 V | 贴片 100 nF + 10 µF | 贴片 | 🟡 留焊盘（核心板自身有，双保险） |
| JY901P 的 VCC | 贴片 10 µF + 100 nF | 贴片 | 🟢 可不做（模块自带） |

#### ⭐ 舵机母线电容：装在端子上，PCB 上零电容

```
电池 + ──┬─── [粗线 14AWG] ─── 舵机 V
         │
     ┌───┴───┐  ← 螺钉式接线端子（可插拔）
     │   ○   │
     │   ○   │ ← 电容两脚直接插进端子拧紧
     └───────┘
         │
      [ 直插电解 2200µF/25V ]
         │
     ┌───┴───┐
     │   ○   │
     └───┬───┘
电池 − ──┴─── [粗线 14AWG] ─── 舵机 G
```

**好处**：零 PCB 焊接、可随时更换、位置正好在舵机供电点（效果最好）、想加大容量就并联插一个。

#### 为什么母线电容不能省

```
12 舵机同时启动 → 24 A 电流阶跃
电池到驱动板的线 → 寄生电感约 1 µH
压降 = L·di/dt → 无电容吸收会直接打在舵机供电上
```

#### 选型要点

- **耐压必须 25 V**（3S 满电 12.6 V，16 V 太紧）
- 低 ESR 即可（红宝石 ZLH / 丰宾 FR 等国产品牌），**不需要音响补品电容**
- **不要用一个大电容**：多个小电容并联的效果远好于 1 个大电容（降低 ESR/ESL，分散纹波电流）
- 如果做在 PCB 上：焊盘骑在铺铜上，**负极旁放 2~4 个过孔**到底层 GND；铜箔要"**先过电容、再进负载**"

#### 不同容值管不同时间尺度（不是重复）

| 容值 | 响应尺度 | 作用 |
|---|---|---|
| 2200 µF 电解 | ms 级 | 撑住 24 A 阶跃的持续时间 |
| 100 µF 电解 | µs 级 | 中期补充 |
| 10 µF 陶瓷 | 高频 | µs 级尖峰 |
| 100 nF 陶瓷 | 极高频 | ns 级开关噪声 |

### 4.5 电池电压检测（STM32 内部分压）

**方案：PA0 + 两个电阻 + 一个电容，全部直插。**

```
电池 + ──[ R1 = 100 kΩ ]──┬────────────→ PA0 (ADC1_IN0)
                          │
                     [ C1 = 100 nF ]   ← 与 R2 并联
                          │
                         GND
                          │
                    [ R2 = 22 kΩ ]
                          │
                         GND
```

| 项 | 数值 |
|---|---|
| 分压比 | `22 / (100+22) = 0.1803` |
| **12.6 V（满电）→ PA0** | **2.27 V** ✅ 余量充足（换 4S 也不用改） |
| 11.1 V → PA0 | 2.00 V |
| 9.0 V（空电）→ PA0 | 1.62 V |
| 静态耗流 | `12.6 / 120k = 105 µA` |
| 分辨率 | 0.806 mV/LSB ÷ 0.1803 = **4.5 mV** |
| 有效精度（含噪声） | **≈ 18 mV** ✅ 远超需求 |

#### 元件表（全部直插，总成本 ≈ ¥0.15）

| 元件 | 规格 | 封装 |
|---|---|---|
| R1 | **100 kΩ，1/4W，1% 金属膜** | 直插轴向 |
| R2 | **22 kΩ，1/4W，1% 金属膜** | 直插轴向 |
| C1 | **100 nF 直插瓷片**（标号 104） | 直插圆片 |

⚠️ **电阻必须买 1% 的金属膜**，不要买 5% 的碳膜。价格一样，但 5% 会让 12.6 V 读成 12.0 或 13.2 V。

#### C1 的作用（两个都不能省）

1. **解决源阻抗问题**：ADC 采样时从 C1 取电荷，不从 18 kΩ 电阻取，所以不受 STM32"源阻抗 < 1.2 kΩ"的限制
2. **低通滤波**：`f_c = 1/(2π·18k·100n) ≈ 88 Hz`，正好滤掉舵机 PWM 开关噪声，而电池电压变化是 Hz 级

**如果实在不想加 C1**：电阻要改成 **R1 = 4.7 kΩ / R2 = 1 kΩ**（源阻抗 825 Ω，合格），但静态耗流涨到 2.2 mA，且**抗噪差很多**——24 A 舵机电流下读数会明显跳动。**不推荐。**

#### 电池电压表（已有）

外接电压显示模块（直显式、不可通信）保留，用途：**充电时看电压、调试时人工确认**。它和内部检测不冲突，各司其职。

#### 3S 低压报警器（¥5，强烈建议）

```
3S 平衡头低压报警器 → 直接插在电池的 3 芯平衡头上
  · 8 个 LED 显示每一节电压
  · 任意一节 < 3.3 V 就蜂鸣
```

**为什么建议加**：STM32 检测的是**总电压**，看不出电芯不均衡。例如 `3.0 V + 3.5 V + 3.5 V = 10.0 V`，总压看着正常，但那一节 3.0 V 已接近损伤线。报警器按单体监测，正好补上这个盲区。

**零工作量**：不占引脚、不写固件、不碰 PCB、不破坏单点接地。

### 4.6 ⚠️ 接地（比电容重要得多）

**24 A 伺服电流流过逻辑地会产生 240 mV 地弹跳（按 10 mΩ 计），这会污染 IMU 读数并导致 1 Mbps 总线偶发通信错误。**

**四条铁律：**
1. **电池负极是唯一星点** — 舵机回流、降压模块回流都在这里汇合，不要互相串接
2. **伺服功率地 ≠ 逻辑地** — 让伺服电流的回流路径绕开逻辑区
3. **GND 铺铜分区**，中间留细连接带或 0 Ω 电阻单点连接
4. **1 Mbps 信号线远离功率铺铜**，间距 ≥3 mm，不要平行长距离走线

### 4.7 Pi 5 供电（⚠️ 不要直接接 GPIO 5V）

| 项 | 值 |
|---|---|
| Pi 5 官方推荐 | **5 V / 5 A（27 W）** |
| Pi 5 空闲 | ~3 W |
| Pi 5 推理负载 | 10~18 W（5 V 侧 2~3.5 A） |
| 模块发热（12.6→5 V，20 W 输出 @85%） | **3.5 W，需要散热片** |

**正确做法：**
```
3S → 5V/5A 降压 → PCB 上的 USB-C 母座（CC 各 5.1kΩ 下拉）→ C-to-C 线 → Pi 5 USB-C 口
```

| # | 要求 |
|---|---|
| 1 | 降压模块 **≥5 A**（航模 UBEC 或 MP1584/TPS54560 级） |
| 2 | **必须用 C-to-C 线**（A-to-C 线大概率不上电） |
| 3 | USB-C 座要接 **CC 下拉 5.1 kΩ × 2**，否则 Pi 5 可能不认 |
| 4 | 3S 最低 9.0 V → 5 V 压差 4 V，**任何 buck 都够，无 dropout 问题** |

⚠️ 若只给 5 V/3 A，Pi 5 能跑但会有欠压警告、限制 USB 供电预算。本项目不从 Pi USB 带大负载，**3 A 实际够用，但建议直接买 5 A 模块**。

**上电后实测：`vcgencmd get_throttled`，看是否出现 `0x50000`（欠压标志）。**

### 4.8 其它保护电路（建议做，但可留焊盘不焊）

| 电路 | 器件 | 为什么建议 |
|---|---|---|
| **TVS 钳位** | SMBJ15A（单向，钳 15~16 V） | 舵机堵转断开瞬间的电机反电动势尖峰可能到 20 V+，会击穿舵机内部 16 V 电容 |
| **反接保护** | P-MOS（AO3401）+ 10 kΩ 栅极电阻 | 比二极管好（压降只有几 mΩ，不是 0.5 V） |
| **母线保险** | 25~30 A 快熔或自恢复保险 | 舵机短路时防止 24 A 持续烧线 |
| **心跳看门狗** | PA8 心跳 → RC + MOS → 切断舵机母线使能 | **Pi 一崩，舵机保持最后指令不动**（`§6.6`）。成本约 ¥5 |

> ⚠️ **电池电压监测已移至 §4.5**（STM32 内部分压方案）。

---

## 5. 通信架构

### 5.1 总线舵机驱动板：Waveshare Bus Servo Adapter (A)（SKU 25514）

| 参数 | 值 |
|---|---|
| 输入电压 | 9 ~ 12.6 V（也支持 5~8.4 V，需与舵机匹配） |
| 通信接口 | UART |
| 波特率 | 与舵机一致（出厂 1000000） |
| **最大电流** | **5 A** ⚠️ |
| 板载稳压 | **无**（输入多少输出多少） |
| 驱动芯片 | **无**，板上是串口转换 IC（USB 侧是 **CH343**） |
| 尺寸 | 42 × 33 mm |
| 供电接口 | DC 5.5×2.1 mm + 绿色接线端子 |
| 舵机接口 | 2 个（**共享同一条 D 信号线**），标注 D / V / G |
| 跳线帽 | **A = UART 外部控制**；B = USB 控制 |

⚠️ **接线必须 RX-RX、TX-TX（不是交叉），跳线帽必须在 A 位置。**

⚠️ **只买 1 块驱动板即可** — 两个舵机接口共享同一条信号线，12 个舵机挂同一条总线。

### 5.2 串口分配（F103C8 的 3 个 USART 刚好用尽）

| 接口 | 连接 | 波特率 | 说明 |
|---|---|---|---|
| **USART1** | 树莓派 | 1 Mbps | 200 Hz 下 obs 240 B + act 24 B 仅需 53 kbps，余量巨大 |
| **USART2** | Bus Servo Adapter (A) | **1 Mbps** | 与舵机一致，不可改 |
| **USART3** | ESP32-C3 无线模块 | 115200~921600 | 低频调试用 |
| **I2C1（软件）** | JY901P | ~89 kHz 等效 | 约 7% CPU @200 Hz |
| SPI1 / SPI2 | 空闲 | — | 留给以后扩展 |

### 5.3 ⚠️ 为什么选 100 Hz 控制环（不是 200 Hz 或 1 kHz）

**关键约束：1 块驱动板 = 1 条 1 Mbps 总线 = 12 个舵机全在这一条线上。**

**读取是逐个舵机串行进行的**（发命令 → 舵机转向 → 回包 → 下一个），**瓶颈是串行转向延迟，不是带宽利用率。**

**实测/推算的时间账（1 Mbps，含舵机转向延迟 20 µs）：**

| 操作 | 字节数 | 耗时 |
|---|---|---|
| SyncWrite 下发 12 舵机 | 103 B | **1.02 ms** |
| syncRead 回读 12 舵机（位置+速度，4 B/舵机） | 136 B | **1.53 ms** |
| **合计** | | **2.55 ms / 10 ms = 26%** |
| 剩余给 IMU / 树莓派 / 无线 | | **7.45 ms（74%）** |

**替代方案：库自带的 `FeedBack(ID)` 逐舵机读（15 字节全字段）≈ 3.72 ms，总占用 47%，也装得下 100 Hz。** 建议先用它起步。

**❌ 已否决：200 Hz / 1 kHz 控制环。** 12 舵机挂单总线时，读一轮的串行时间就吃掉大半周期；1 kHz 物理上不可能（需要 2 块驱动板，但那样 USART3 就没法给无线了）。

**RL 策略在 50~100 Hz 完全够用**，而且舵机内部有 PID 内环，扰动抑制不依赖外环带宽。

### 5.4 总线物理层

| 项 | 结论 | 依据 |
|---|---|---|
| 舵机输出类型 | **开漏** | 已与卖家确认 |
| 上拉电阻 | **驱动板已有内置上拉** → PCB 上不需要 | 已确认 |
| 备选焊盘 | ⚠️ **建议留一个 1 kΩ 焊盘** | 万一内置上拉偏大、1 Mbps 下边沿不够快，可并联降阻 |
| TX 串阻 | 建议 100~220 Ω | 防"发送时舵机同时驱动"的短瞬间 |
| STM32 半双工 | 库用**普通全双工 UART**（TX/RX 分立），靠驱动板把两线并在总线 D 上 | 见库 `uart.c` |
| 依据 | Waveshare 官方参考原理图 | files.waveshare.com/upload/d/d3/Bus_servo_control_circuit.pdf |

**⚠️ 已知的物理层风险（待实测）**：开漏 + 1 Mbps + 12 舵机这个组合，上升沿时间 `t_r = 2.2·R·C` 可能不够快（`C_bus` 估计 340~630 pF）。**驱动板内置上拉的实际阻值决定了这件事。** 验证方法见 §8。

### 5.5 引脚分配表（STM32F103C8T6 / Blue Pill）

#### 通信

| 引脚 | 丝印 | 资源 | 连接 | 波特率 |
|---|---|---|---|---|
| **PA9** | USART1_TX | USART1 | **树莓派 RX** | 1 Mbps |
| **PA10** | USART1_RX | USART1 | **树莓派 TX** | 1 Mbps |
| **PA2** | USART2_TX | USART2 | **驱动板**（标 TX 的脚） | 1 Mbps |
| **PA3** | USART2_RX | USART2 | **驱动板**（标 RX 的脚） | 1 Mbps |
| **PB10** | USART3_TX | USART3 | **ESP32-C3 RX** | 921600 |
| **PB11** | USART3_RX | USART3 | **ESP32-C3 TX** | 921600 |
| **PB8** | TIM4_CH3 | GPIO（软件 I2C SCL） | **JY901P SCL** | 外接 4.7 kΩ 上拉到 3.3 V |
| **PB9** | TIM4_CH4 | GPIO（软件 I2C SDA） | **JY901P SDA** | 同上 |

⚠️ **驱动板接线是 RX→RX、TX→TX（不是交叉）**，且跳线帽必须在 **A** 位置。见 `§5.1`。

#### 模拟输入

| 引脚 | 丝印 | 资源 | 连接 |
|---|---|---|---|
| **PA0** | ADC12_IN0 | ADC1_IN0 | **电池电压分压**（100 kΩ / 22 kΩ + 100 nF，见 `§4.5`） |
| PA1 | ADC12_IN1 | ADC1_IN1 | **空闲**（电流检测已放弃） |

#### 状态与安全

| 引脚 | 丝印 | 资源 | 连接 |
|---|---|---|---|
| **PA8** | TIM1_CH1 | GPIO OUT | **心跳 → 硬件看门狗**（每 20 ms 翻转，见 `§4.8`） |
| **PB0** | ADC12_IN8 | GPIO OUT | 状态 LED（**外部**，串 1 kΩ；板载 PC13 的 LED 未引出） |
| PB1 | ADC12_IN9 | GPIO OUT | 蜂鸣器 / 备用 |
| PA4 | SPI1_NSS | GPIO OUT | [预留] 舵机使能 / 急停继电器 |
| PA5 | SPI1_SCK | GPIO OUT | [预留] 蜂鸣器 PWM |

#### 预留：足底开关（v1 不装，留结构）

> 决定见 `§9`：v1 用舵机 `Present Load` 字段代替足底传感器。但**结构上预留**（脚垫空腔 + 膝髋走线松弛环），**PCB 上引出接插件并留上拉焊盘**。

| 引脚 | 丝印 | 复用能力 | 分配给 |
|---|---|---|---|
| **PB12** | SPI2_NSS | EXTI12 | 左前 (FL) 足底开关 |
| **PB13** | SPI2_SCK | EXTI13 | 右前 (FR) 足底开关 |
| **PB14** | SPI2_MISO | EXTI14 | 左后 (RL) 足底开关 |
| **PB15** | SPI2_MOSI | EXTI15 | 右后 (RR) 足底开关 |
| — | — | — | GND（第 5 脚） |

**接插件：5 脚 2.54 mm 排针（PB12~PB15 + GND）。** 另在 PB12~PB15 各自到 3.3 V 之间留 10 kΩ 焊盘（默认用内部上拉，不焊）。

固件预配置（即使不接开关也先写上，无害）：
```c
GPIO_InitTypeDef g;
RCC_APB2PeriphClockCmd(RCC_APB2Periph_GPIOB, ENABLE);
g.GPIO_Pin   = GPIO_Pin_12|GPIO_Pin_13|GPIO_Pin_14|GPIO_Pin_15;
g.GPIO_Mode  = GPIO_Mode_IPU;   // 上拉输入
g.GPIO_Speed = GPIO_Speed_50MHz;
GPIO_Init(GPIOB, &g);
```

#### 调试（⚠️ 必须保留）

| 引脚 | 丝印 | 用途 |
|---|---|---|
| **PA13** | SWDIO | **SWD 调试数据 — 绝对不要复用** |
| **PA14** | SWCLK | **SWD 调试时钟 — 绝对不要复用** |

#### 空闲 / 不可用

| 引脚 | 状态 |
|---|---|
| PA6, PA7, PA11, PA12, PB1, PB5 | 空闲（PA6/PA7 留给以后换 SPI IMU） |
| **PB2** | ⚠️ **BOOT1，必须悬空** |
| **PA15 / PB3 / PB4** | JTAG 脚（JTDI/JTDO/NJTRST），**要用必须先禁用 JTAG**（见下） |
| PC13 / PC14 / PC15 | PC13 灌电流仅 3 mA；PC14/PC15 接了 32.768 kHz 晶振 → 不可用 |

⚠️ **如果以后要用 PA15 / PB3 / PB4**，固件里必须加：
```c
GPIO_PinRemapConfig(GPIO_Remap_SWJ_JTAGDisable, ENABLE);
```
**千万不要写成 `GPIO_Remap_SWJ_Disable`** —— 那会把 SWD 也关掉，之后就下载不进程序了（只能靠拉高 BOOT0 进 ISP 模式救回）。

#### 电源引脚

| 引脚 | 连接 |
|---|---|
| **5V** | 板上 5 V/5 A 降压输出 |
| **3V3** | JY901P 的 3.3 V（⚠️ **不给 ESP32-C3** — 板载 AMS1117 只有 ~300 mA，ESP32 WiFi 峰值 500 mA） |
| **GND** | 公共地（单点星型汇接，见 `§4.6`） |

---

## 6. 固件方案

### 6.1 官方 F103 库评估（`doc/STServoBCL_keil_f103`）

**结论：✅ 用。协议层完全现成。**

#### 可直接原样搬用的文件

| 文件 | 内容 |
|---|---|
| `SCSLib/INST.h` | 指令码定义（PING/READ/WRITE/REG_WRITE/REG_ACTION/SYNC_READ/SYNC_WRITE） |
| `SCSLib/SC.c` / `SC.h` | 协议层：`genWrite` / `regWrite` / `regAction` / `syncWrite` / `Read` / `Ping`，含校验和、帧头检测、同步读 |
| `SCSLib/ST.c` / `ST.h` | 应用层：**`SyncWritePosEx`**（批量下发）/ `WritePosEx` / `WheelMode` / `EnableTorque` / **`FeedBack`**（一次读回 15 字节全字段）/ `ReadPos`/`ReadSpeed`/`ReadLoad`/`ReadVoltage`/`ReadTemper`/`ReadMove`/`ReadCurrent` / `getErr` |
| `SCSLib/SCServo.h` | 汇总头 |
| `examples/wiring.c` / `wiring.h` | `SysTick` + `millis()` + `delay()` |

**`SyncWritePosEx` + `FeedBack` 正好就是"批量下发 + 批量回读"这两件事。** 这省掉的工作量按周计。

#### 必须替换的文件

| 文件 | 原因 | 替换工作量 |
|---|---|---|
| `SCSLib/uart.c` | 用 **StdPeriph 库**，与 Cat 项目的 **HAL** 冲突 | **40~60 行**（只需实现 4 个函数） |

**库需要你提供的接口只有 4 个：**
```c
void    Uart_Init(uint32_t baudRate);
void    Uart_Send(uint8_t *buf, uint8_t len);
int16_t Uart_Read(void);      // 返回 -1 表示无数据
void    Uart_Flush(void);
```

`SCSerail.c` 里的 `writeSC` / `readSC` / `rFlushSC` / `wFlushSC` 都是纯软件逻辑，**不依赖任何外设库。**

### 6.2 ⚠️ 必须修改的 5 处（否则会出问题）

| # | 问题 | 位置 | 修改 |
|---|---|---|---|
| **1** | **StdPeriph / HAL 冲突** | `uart.c` | 用 HAL 或寄存器重写那 4 个函数 |
| **2** | **接收缓冲可能溢出** | `uart.c` `uartBuf[128]` | 环形缓冲扩到 **512 B**。syncRead 读完整 15 字节需要 `12×(6+15)=252 B`，超 128 B。只读位置+速度需 120 B（压线通过） |
| **3** | **环形缓冲无溢出检测** | `uart.c` `USART1_IRQHandler` | 加溢出计数 |
| **4** | **`syncReadBegin` 用了 `malloc`** | `SC.c:337` | 换成静态缓冲。STM32 上控制循环用动态内存有堆碎片化风险，且失败返回 NULL 无人检查 |
| **5** | **`IOTimeOut` 是"每字节超时"不是"整帧超时"** | `SCSerail.c:11` `IOTimeOut = 5000` | `readSC` 每收到一字节就 `t_user=0`，所以是每字节超时。**舵机不存在时一帧阻塞 ~0.5~1 ms；12 个全失联累计 6~12 ms，直接吃掉整个 10 ms 周期。必须在外层加整帧超时** |

**另外两个要注意：**
- **`SyncWritePosEx` 返回 `void`**（无错误码）→ **必须用 `getErr()` 监视通信状态**
- `SCDelay()` 里有总线切换延时（约 10 µs）→ 说明库是认"半双工需要转向延时"的

### 6.3 控制环设计（100 Hz）

```
【每周期 10 ms】
  ① syncRead 回读 12 舵机（位置+速度，4 B/舵机）   1.53 ms
     起步方案：FeedBack(ID) 逐舵机读，15 B/舵机     3.72 ms
  ② 读 JY901P（软件 I2C）                          ~0.20 ms
  ③ 组 obs → 发树莓派                              ~0.05 ms
  ④ 收 action                                     ~0.03 ms
  ⑤ SyncWritePosEx 下发 12 舵机                    1.02 ms
  ⑥ 安全层：整帧超时 / 限幅 / 心跳 / 无线遥测
  ─────────────────────────────────────────────
  总线占用 26%，CPU 预估 30~40%
```

### 6.4 内存表（`ST.h`，标准 Feetech 布局）

```
EPROM: SMS_STS_ID=5, BAUD_RATE=6, MIN/MAX_ANGLE_LIMIT=9~12, OFS=31/32, MODE=33
SRAM 写: TORQUE_ENABLE=40, ACC=41, GOAL_POSITION=42/43, GOAL_TIME=44/45,
         GOAL_SPEED=46/47, LOCK=55
SRAM 读: PRESENT_POSITION=56/57, PRESENT_SPEED=58/59, PRESENT_LOAD=60/61,
         PRESENT_VOLTAGE=62, PRESENT_TEMPERATURE=63, MOVING=66,
         PRESENT_CURRENT=69/70
```

`FeedBack(ID)` 读回的连续块 = `56` 到 `70` = **15 字节**。

### 6.5 移植动作清单（总计约 150 行改动）

| # | 动作 | 工作量 |
|---|---|---|
| 1 | 用 HAL 重写 `Uart_Init/Send/Read/Flush`（指向 USART2） | 40~60 行 |
| 2 | 环形缓冲 128 B → **512 B** | 改 1 个宏 |
| 3 | 环形缓冲加**溢出计数** | 3 行 |
| 4 | `syncReadBegin` 的 `malloc` → **静态缓冲** | ~10 行 |
| 5 | `IOTimeOut` 调小（如 500）+ **外层加整帧超时** | ~15 行 |
| 6 | 用 `getErr()` 监视通信状态 | ~5 行 |
| 7 | 保留 Cat 的 `robot_config.h` 配置化分层 | 复用 |

### 6.6 ❌ 已否决：只用树莓派（去掉 STM32）

| 理由 | 说明 |
|---|---|
| 失去实时性 | Linux 调度抖动 1~10 ms，1 kHz 环做不到，200 Hz 都有风险 |
| **失去安全层** | **Pi 一崩，舵机保持最后指令不动，直到电池耗尽或齿轮烧掉** |
| 规范 | 保留 STM32 后，半双工物理层的麻烦有库和驱动板分担，且固件工作量可控 |

### 6.7 电池电压监测（ADC + 低压保护）

**电路见 `§4.5`。这里只讲固件侧。**

#### ADC 配置

```
ADC1，通道 0（PA0）
  · 12 bit，右对齐
  · 采样时间：239.5 周期（最长，配合 18 kΩ 源阻抗 + C1 更稳）
  · 定时器触发 + DMA，采集频率 10 Hz
  · 每通道 16 次滑动平均 → 等效精度约 2 个码
```

#### 换算

```c
// ⚠️ ADC_VREF 必须按实测值填，不能写死 3.3f（AMS1117 精度 ±2~3%）
#define ADC_VREF    3.28f                        // ← 校准值（见下）
#define BATT_DIV    (22.0f/(100.0f+22.0f))       // 0.18033
#define BATT_GAIN   (ADC_VREF / 4095.0f / BATT_DIV)

vbat = adc_avg[0] * BATT_GAIN;                   // 伏特
```

#### ⚠️ 必做：两步校准（一次性，5 分钟）

Blue Pill 的 **VDDA 直接连 VDD**，没有独立基准，所以 ADC 的"3.3 V"其实是"当前的 3.3 V"。

```
第 1 步：万用表量 STM32 模块的 3.3V 引脚 → 填入 ADC_VREF
第 2 步：机器人静止，万用表量电池电压，与固件读数对比
        → 差值用于微调 BATT_DIV
```

**两步做完精度可达 ±50 mV，对电池监测完全够用。**

#### 低压保护阈值（按 `§3.3` 的扭矩余量推导）

| 电压 | 每节 | 膝扭矩余量 | 动作 |
|---|---|---|---|
| > 10.5 V | > 3.50 V | > 25% | ✅ 正常 |
| **10.5 V** | 3.50 V | 25% | ⚠️ **警告**（LED 闪 / 无线推一条告警 / 上报树莓派） |
| **9.9 V** | 3.30 V | 16% | 🔴 **建议停机**（主动上报树莓派） |
| **9.3 V** | 3.10 V | < 10% | 🚨 **强制保护：全部舵机 Torque Disable（失力趴下）** |

**为什么最低阈值要"失力趴下"而不是"保持站姿"：**

> 电池快空时若让舵机继续保持站姿，电流会持续拉高 → 电压进一步塌陷 → 舵机可能进入欠压保护或直接掉电。
> **主动失力趴下比硬撑到掉电安全得多**，而且趴下后电流立刻降下来。

#### 实现注意

| # | 注意点 |
|---|---|
| 1 | **`EnableTorque(ID, 0)` 对每个舵机是一次单独通信**（12 个 ≈ 3.3 ms）。只在上电和停机时做，**不要放进 100 Hz 控制环** |
| 2 | **不要"检测到就立刻切"** —— 电池在舵机启动瞬间会跌几百 mV。**要连续 N 次采样（如 20 次 = 2 秒）都低于阈值才触发**，否则误判 |
| 3 | ADC 走线要**远离舵机功率区**（模拟信号，24 A 开关噪声会耦合） |
| 4 | 分压电阻要**靠近电池接入点**，避免走长线后再分压 |

#### 兜底：3S 低压报警器（¥5）

见 `§4.5`。**报警器按单体监测，补上"总压看不出电芯不均衡"的盲区**，且完全不占固件资源。

#### 电流检测：已放弃

**不做。** 丢失的能力（记录备用）：
- 电量精确估算、续航预测
- 硬件级堵转检测（现在依赖舵机自带的 2 A 过流保护 + 固件 `getErr()`）
- 碰撞检测（少了 `Present Current` 这个观测）
- 电池内阻趋势

**替代**：固件可轮询 `FeedBack(ID)` 读 `PRESENT_LOAD`（地址 60/61）做软件级堵转兜底，低频（20 Hz）读 4 个膝关节即可。

---

## 7. 无线模块（ESP32-C3）

**用途：低频调试，接 STM32 的 USART3。**

| 项 | 内容 |
|---|---|
| 型号 | **ESP32-C3 开发板** |
| 接口 | UART（3.3 V 电平，与 STM32 直接匹配，**不需要电平转换**） |
| 固件 | ESP-AT 固件，或自写 UART↔WiFi 透传（几十行） |
| 使用方式 | ESP32 开 WiFi 热点，笔记本连上后用 TCP/UDP 工具收发，**PC 侧零驱动** |
| 波特率 | 115200 ~ 921600 |
| **供电** | ⚠️ **必须独立 3.3 V（≥800 mA）** — WiFi 发射峰值 500 mA，挂在 STM32 核心板 LDO 上会拉垮 3.3 V 导致 STM32 复位 |

**带宽需求（USART1 对树莓派，200 Hz 下 obs 240 B + act 24 B）：**
| 频率 | 需要波特率 |
|---|---|
| 100 Hz | 26.4 kbps |
| **200 Hz** | **52.8 kbps** → 115200 已够 |

**无线只做低频监控 + 遥控。完整遥测日志应走有线（Pi↔PC）。**

### 7.1 ❌ 已否决的无线方案

| 方案 | 否决理由 |
|---|---|
| ESP32 跑 BLE NUS | 延迟 10~50 ms，看日志够用但遥控会很难受 |
| Zigbee | PC 侧需要协调器，多一层工程量 |
| 经典蓝牙串口（HC-05 类） | 115200 上限，老，Android 9+ 兼容差 |
| LoRa | 速率 kbps 级，差三个数量级 |
| 2.4G 透传模块（nRF24L01+PA 等） | 延迟最低（<5 ms），但 PC 侧要再插一个模块；**保留为备选** |

---

## 8. 待实测 / 待确认清单

### 8.1 硬件到货后立即验证（国庆前，约 1 个下午）

| # | 验证项 | 方法 | 判据 |
|---|---|---|---|
| **1** | **驱动板 + 舵机基本功能** | 跳线 **B**（USB），跑官方 Python 例程 `ping.py` | 能改 ID、能转位置 |
| **2** | **UART 接线正确性** | 跳线 **A**，STM32 跑 `examples/Ping.c` | 能 Ping 到 ID → 证明 RX-RX/TX-TX 接法正确 |
| **3** | **`FeedBack(1)` 实际耗时** | 用 `millis()` 夹住单次调用 | 单次 ≈300 µs、12 次 ≈3.6 ms → 100 Hz 设计成立 |
| **4** | **总线上升沿** | 示波器量 D 线（满 12 舵机接上） | `t_r < 300 ns` 可跑 1 Mbps；`300~600 ns` 需观察误码率 |
| **5** | **通信误码率** | 连续发 10000 帧，统计校验失败 | `< 1e-4` 可接受（有 checksum 兜底 + 重发） |
| **6** | **驱动板 D 线内置上拉阻值** | 万用表量 D 对 V 的电阻 | 若偏大（>3 kΩ），加 1 kΩ 并联 |
| **7** | **舵机内部电解电容容量** | 拆开看 / 问卖家 | 决定 PCB 上是否需要额外去耦 |
| **8** | **ADC 分压校准** | 万用表量 STM32 模块 3.3 V 真实值 → 填 `ADC_VREF`；再对比固件读数与万用表电池电压 → 微调 `BATT_DIV` | 读数与万用表差 **< 50 mV**（见 `§6.7`） |

### 8.1b 原理图评审遗留项（2026-09 评审）

| # | 项目 | 状态 |
|---|---|---|
| 1 | I2C 上拉到 3.3 V（4.7 kΩ ×2） | ✅ 已修 |
| 2 | Mini560 输入 2200 µF | ✅ 已修（现改为装在接线端子上，见 `§4.4`） |
| 3 | ESP32 侧电容 | ✅ 已修 |
| 4 | 驱动板电源独立端子 | ✅ 已修 |
| 5 | **电池电压分压** | ✅ 已定为 STM32 内部 ADC（`§4.5`） |
| 6 | **U9（ESP32-C3）是否自带 LDO** | ⚠️ **待确认** — 若靠 STM32 模块的 3.3 V 供电，WiFi 发射峰值 500 mA 会拉垮 3.3 V 导致 STM32 复位 |
| 7 | **UART3 是否挂了两个负载** | ⚠️ **待确认** — 图中同时有 U6（标 ESP32）和 U9（标 ESP32-C3）用 TX3/RX3。若是同一接口的两种画法则无碍；若是两个独立接口，两个 TX 会互相打架 |
| 8 | Mini560 输出电容、STM32 5V 去耦 | 🟡 留焊盘，不焊 |
| 9 | TVS / 反接保护 / 保险 / 看门狗 | 🟡 建议做，至少留焊盘 |
| 10 | 足底开关接插件 + 4 个上拉焊盘 | 🟡 留位置（`§5.5`） |

### 8.2 传感器配置

| # | 项目 | 建议 | 状态 |
|---|---|---|---|
| 1 | **JY901P 波特率** | **调到 921600**（默认 115200 会吃 19% CPU） | ⚠️ 待配置 |
| 2 | JY901P 输出率 | 200 Hz 以上 | ⚠️ 待配置 |
| 3 | **关闭磁力计，只用 6 轴** | 舵机电机磁场会破坏磁力计读数 | ⚠️ 待配置 |
| 4 | **RL 观测用哪两个量** | **重力向量（3 维，从四元数反算）+ 角速度（3 维）**。**不要直接喂欧拉角**（±90° 附近有奇异） | ✅ 已定 |
| 5 | **延迟实测** | 用已知角速度旋转，互相关求延迟 | ⚠️ 待实测。`<5 ms` 够用；`>15 ms` 需换 SPI IMU |
| 6 | 安装方向标定 | 标出外壳 XYZ 到机身坐标系的旋转矩阵 | ⚠️ 待做 |

### 8.3 机械 / 装配待验证

| # | 项目 | 说明 |
|---|---|---|
| 1 | **机身长度能否压到 230 mm** | 4 组舵机 + Pi 5 在 230 mm 内的排布余量仅 ~5 mm，**必须 CAD 试装配** |
| 2 | **外摆舵机侧挂的总宽** | 算出 125 mm；若能嵌入侧壁 10 mm 可到 105 mm。**这是最需要 CAD 试的地方** |
| 3 | 髋俯仰轴横向偏移 40 mm | 由"避开机身侧壁"推出，可微调到 36~38 mm |
| 4 | 电池布局 | 3S 21700 ×3 横排 = 66 × 74 mm；若改 2+1 布局可把机身芯宽降到 64 mm，但高度涨到 67 mm |

### 8.4 上电后验证

| # | 项目 | 方法 |
|---|---|---|
| 1 | Pi 5 欠压检查 | `vcgencmd get_throttled` → 看是否出现 `0x50000` |
| 2 | 24 A 电流下的地弹跳 | 示波器量逻辑地对电池负极的压差，应 <50 mV |
| 3 | IMU 在舵机运动时的噪声 | 静止 vs 舵机全速运动，对比加速度计读数标准差 |

---

## 9. 决策记录（为什么这么定）

| 决策 | 结论 | 关键理由 |
|---|---|---|
| 自由度 | 3 DOF/腿（外摆+髋俯仰+膝） | 2 DOF 失去侧向平衡能力，转向和抗侧推全靠策略硬扛 |
| 腿型 | **串联直驱** | 仿真里 1:1 对应，故障可诊断，标定工作量最小。四连杆的转动惯量优势在 1~2 Hz 步频下不到 5% |
| 舵机 | **ST-3215-C018** | **3S 电压范围只有它兼容**（6~14 V），且额定扭矩是三款里最强的 |
| 电源 | **3S 21700** | 用户已有电池盒；Pi 5 供电从"升压"变"降压"，更简单 |
| 控制环 | **100 Hz** | 单总线带 12 舵机时，读一轮的串行时间决定上限；RL 50~100 Hz 已够 |
| STM32 | **保留 F103C8** | 复用 Cat 项目那块板 + 已有固件分层 |
| 驱动板 | **1 块 + 电源旁路** | 5 A 限制靠外接粗线绕开；1 块板带 12 舵机（两个接口共线） |
| ROS 2 | **不用** | DDS 抖动大，不能进控制环；等接 LiDAR 时再引入 |
| IMU 接口 | **软件 I2C** | **F103 硬件 I2C 有真实勘误**（BUSY 卡死、总线锁死难恢复）；软件 I2C 在此场景 CPU 开销相近且风险为零 |
| IMU 选型 | **JY901P（已有）** | 模块内部做融合，MCU 零算力开销；前提是波特率调到 921600 |
| 无线 | **ESP32-C3** | 灵活（以后可扩展手机遥控/网页调参），UART 3.3 V 直连 |
| 电容 | **母线 2200 µF 为主，装在接线端子上** | 舵机内部已有电解电容；**母线电容装在螺钉端子上，PCB 上零电容**；其余留焊盘 |
| 元件封装 | **尽量直插** | 可焊贴片但优先直插。实际必须直插的只有：母线 2200 µF、ESP32 的 100 µF + 100 nF、分压的 2 电阻 + 1 瓷片 |
| **电池电压检测** | **STM32 内部 ADC + 分压**（100 kΩ / 22 kΩ + 100 nF，全直插） | 让低压保护自动化，不依赖人工看显示模块。成本 ¥0.15。**需两步校准**（`§6.7`） |
| **电流检测** | **❌ 不做** | 省掉 INA181 + 采样电阻。堵转保护降级为依赖舵机自带 2 A 过流保护 + 固件 `getErr()` 兜底 |
| **电压显示模块** | 保留（外接、直显，不通信） | 用途：充电时看电压、调试时人工确认 |
| **3S 低压报警器** | **建议加（¥5，插平衡头）** | 补上"总压看不出电芯不均衡"的盲区；零工作量、不碰 PCB |
| **足底传感器** | **v1 不加**（结构预留） | 用舵机 `Present Load` 字段代替。走线要跨 3 个关节，是小型四足最常见故障源；Load 是舵机内部量，无额外故障点 |
| Pi 5 供电 | **USB-C 母座 + C-to-C 线** | 不直接接 GPIO 5V（绕过 PD 协商和保护电路） |

---

## 10. 后续推进顺序

| 阶段 | 内容 | 依赖 |
|---|---|---|
| **A. 采购与验证** | 下单 2 舵机 + 1 驱动板 + STM32F405 或复用 F103；做 §8.1 的全部验证项 + §8.1b 的待确认项 | — |
| **B. 机械 CAD** | 按 §1 的尺寸表建模；重点验 §8.4 的 1、2 两项 | A 的舵机实物尺寸 |
| **C. PCB 设计** | 按 §4、§5 画板：功率区 + 逻辑区 + 电容 | A 的验证结果 |
| **D. 固件** | 按 §6 移植库 + 写控制环 | A、C |
| **E. 上位机** | 策略推理 + 日志 + 遥测（不用 ROS 2） | D |
| **F. 仿真** | MuJoCo / Isaac Lab 建模 + 域随机化 + PPO 训练 | 可与 E 并行 |
| **G. sim-to-real** | 系统辨识 → 真机迁移（**最耗时**） | D、F |

### 关键提醒

1. **系统辨识不能省。** 要实测每个关节的阶跃响应，把舵机内环的延迟/带宽/饱和/背隙拟合进仿真。这是 sim-to-real 成败的分水岭。
2. **机械要早冻结。** 改结构 = 标定全废 = 策略重训。"小巧美观"的优化推迟到功能跑通之后。
3. **国庆前的时间账**：距 10/1 只剩约 10 天，能做完"结构件 + 打印 + PCB 发打样"；**装配调试会滑到国庆之后**。国庆 7 天的产出应该是"软件全部就位，等硬件"，不要期待"国庆结束就能跑 RL"。

---

## 附录 A：关键物理公式（已在本轮讨论中验证）

```
【膝扭矩】（站立姿态，大腿 = 小腿 = L/2）
  b = 膝力臂 = 髋俯仰轴到足端的垂直投影的一半 × 2      ← 由站姿 h/L 决定
  τ_knee = D · (m·g/4) · b
  其中 D = 动态系数（四腿静态 1.0，单腿支撑 2.0，落地下压 2.5，奔跑 3.5）
  站立 h/L = 0.88 时：b = 28.5 mm（L=120mm）

【髋俯仰扭矩】
  τ_hip ≈ D · (m·g/4) · b_hip      b_hip = 足相对髋的水平偏移

【髋外摆扭矩】（极小，通常可忽略）
  τ_abd = m_leg · g · L_coxa · sin(θ_abd_max)

【舵机工作点电流】（扭矩与电流近似线性）
  I = τ / Kt        Kt = 11 kg·cm/A = 0.1079 N·m/A（C018）

【开漏总线上升时间】
  t_r(10-90%) = 2.2 · R_pullup · C_bus
  1 Mbps 要求 t_r ≤ 0.3 bit = 300 ns

【总线带宽占用】
  利用率 = (下行字节 + 上行字节) × 10 bit/字节 × 频率 / 波特率
```

## 附录 B：参考链接

| 内容 | 链接 |
|---|---|
| ST3215 舵机规格（Waveshare Wiki） | https://www.waveshare.com/wiki/ST3215_Servo |
| Bus Servo Adapter (A) 文档 | https://docs.waveshare.net/Bus_Servo_Adapter_A/ |
| Bus Servo Adapter (A) 接线示例 | https://docs.waveshare.net/Bus_Servo_Adapter_A/Product-Wiring-Example |
| Bus Servo Adapter (A) FAQ | https://docs.waveshare.net/Bus_Servo_Adapter_A/FAQ |
| 总线舵机驱动电路参考原理图 | https://files.waveshare.com/upload/d/d3/Bus_servo_control_circuit.pdf |
| 飞特 ST3215 官方页 | https://www.feetech.cn/525603.html |
| Waveshare 12DOF 机器狗开源模型 | https://files.waveshare.com/upload/b/b5/ROBOTIC_DOG_-STEP.zip |

## 附录 C：本地资料位置

| 内容 | 路径 |
|---|---|
| 三份舵机规格书 | `doc/ST-3215-C018串型规格书-20241024.pdf`、`doc/ST-3215-C044串型规格书-20251122.pdf`、`doc/STS3215-C001串型规格书(增加运动曲线图)-20230624.pdf` |
| 官方 F103 舵机库 | `doc/STServoBCL_keil_f103/STServoBCL_keil_f103/`（注意有一层嵌套目录） |
| 上一台四足（Cat）项目 | `<另一个项目>` — 可复用 `App/robot_config.h` 的配置化分层、`BSP/uart_port.c` 的中断+环形缓冲写法、左右镜像公式 |
