vrrrrs/RL-CAT/Sim/RL/plots/final_run9_curves.png

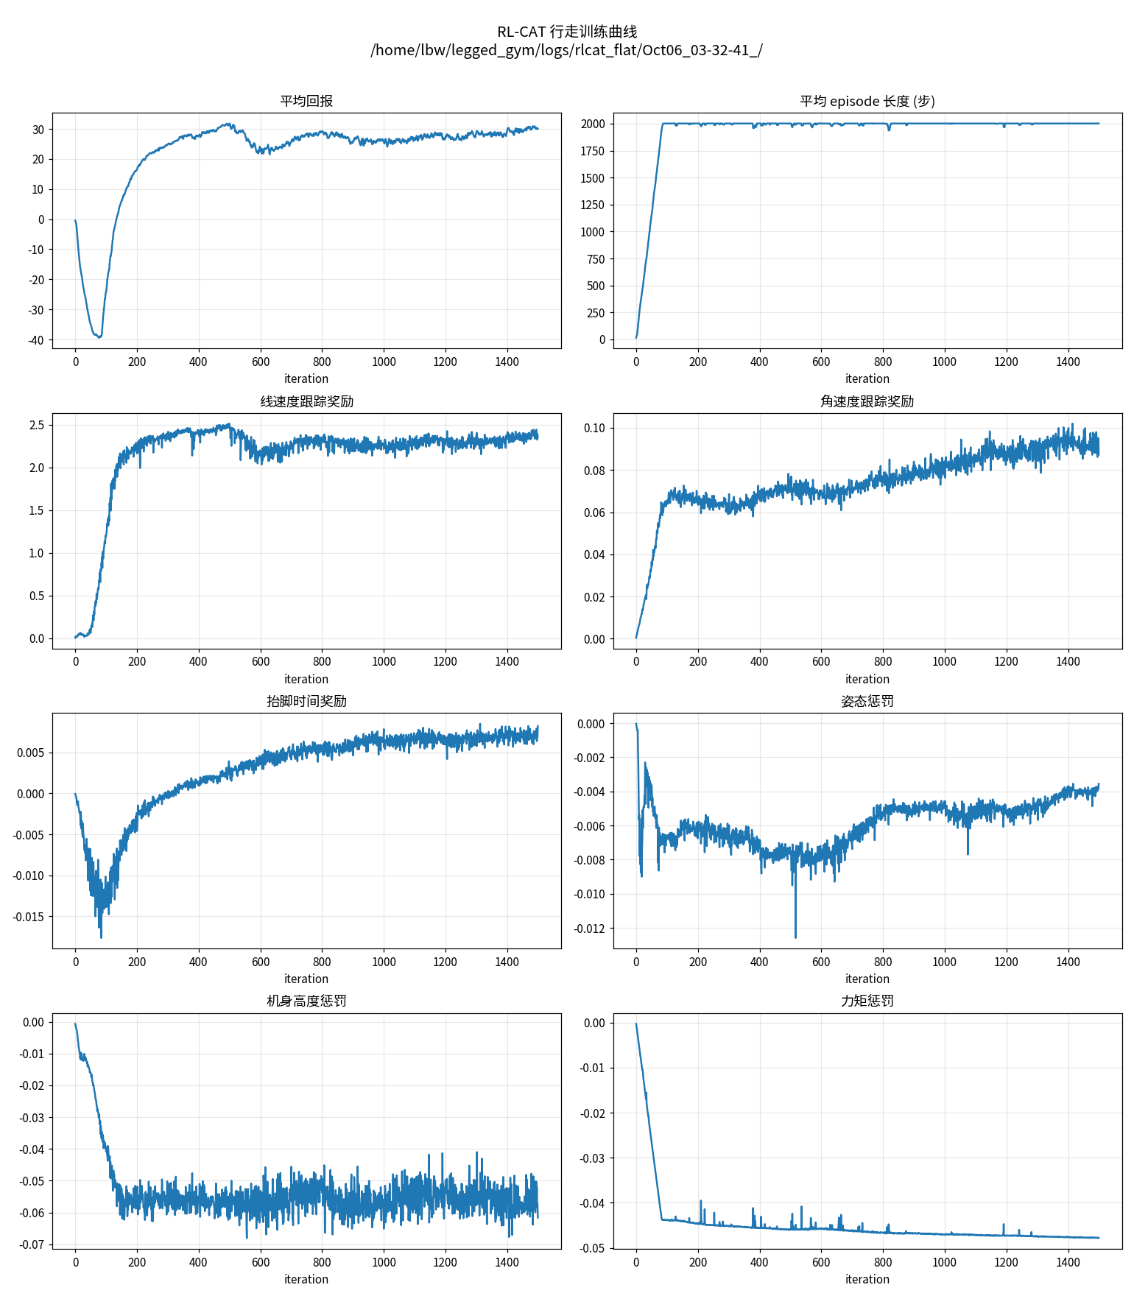
Sim/RL/plots/final_run9_curves.png
