vrrrrs/RL-CAT/Sim/RL/plots/run2_curves.png

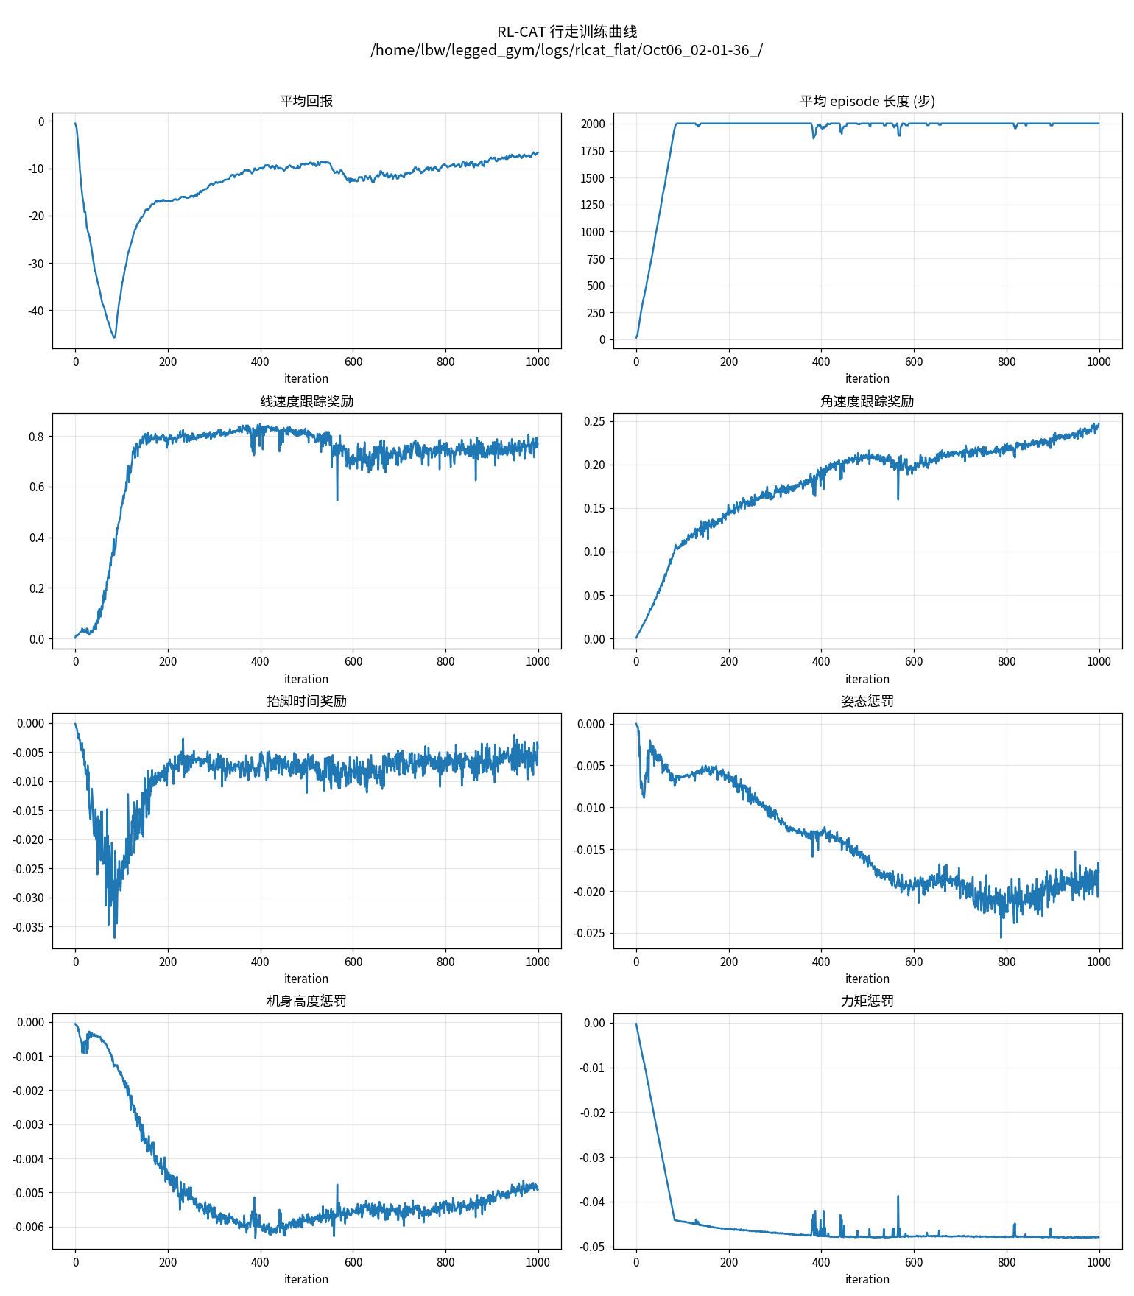
Sim/RL/plots/run2_curves.png
