vrrrrs/RL-CAT/Sim/RL/plots/run5_symmetric_curves.png

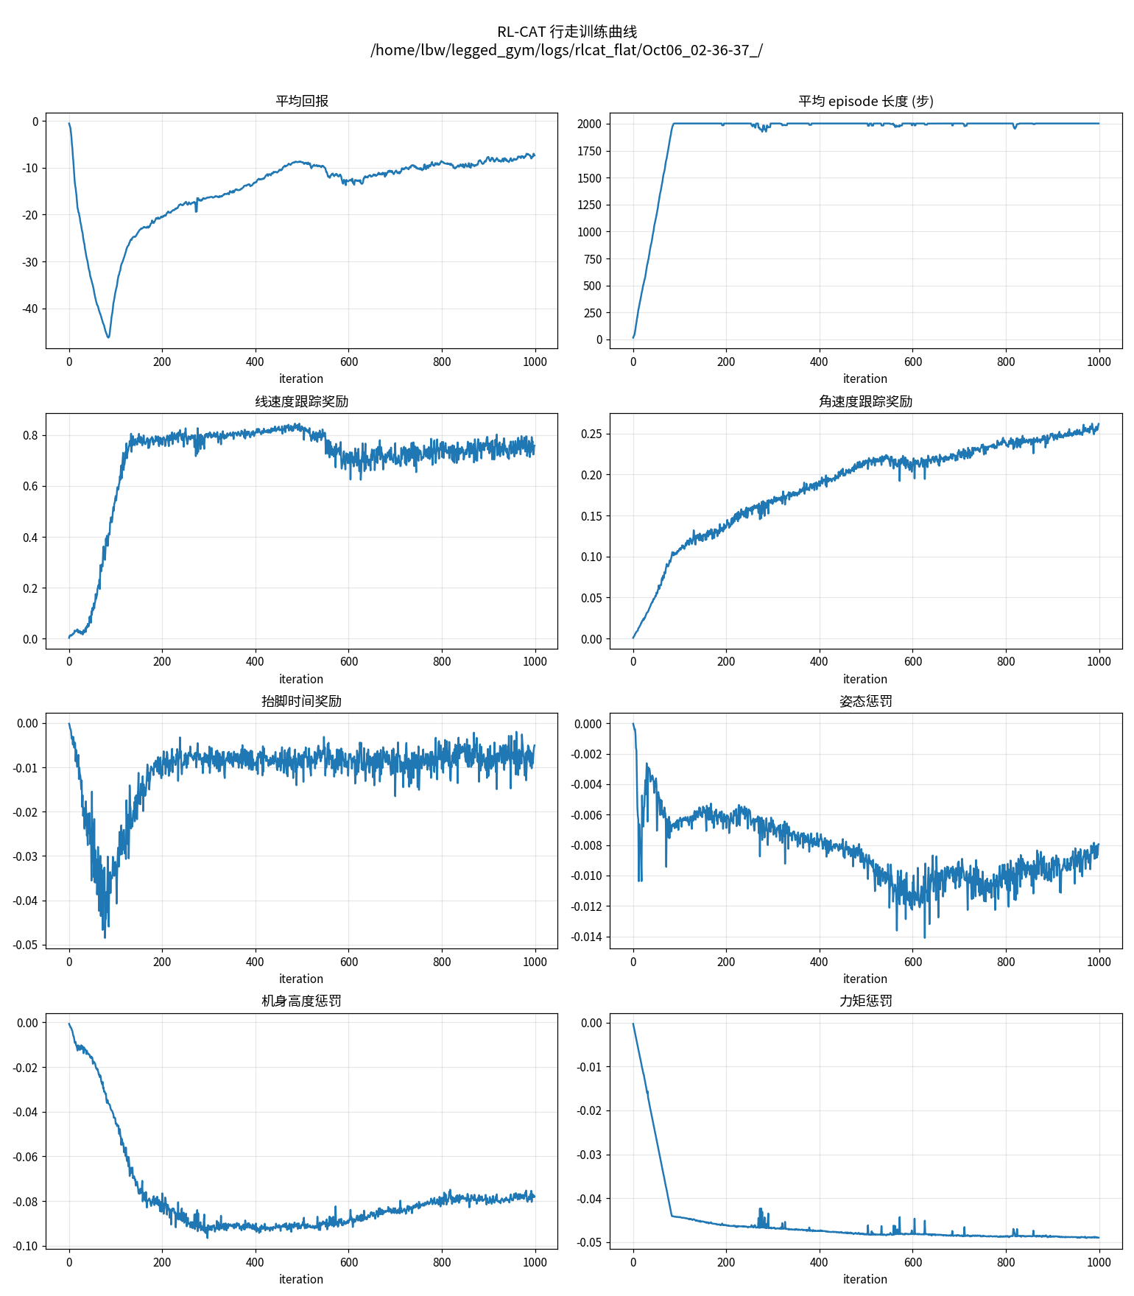
Sim/RL/plots/run5_symmetric_curves.png
