vrrrrs/RL-CAT/Sim/RL/plots/run7_best_curves.png

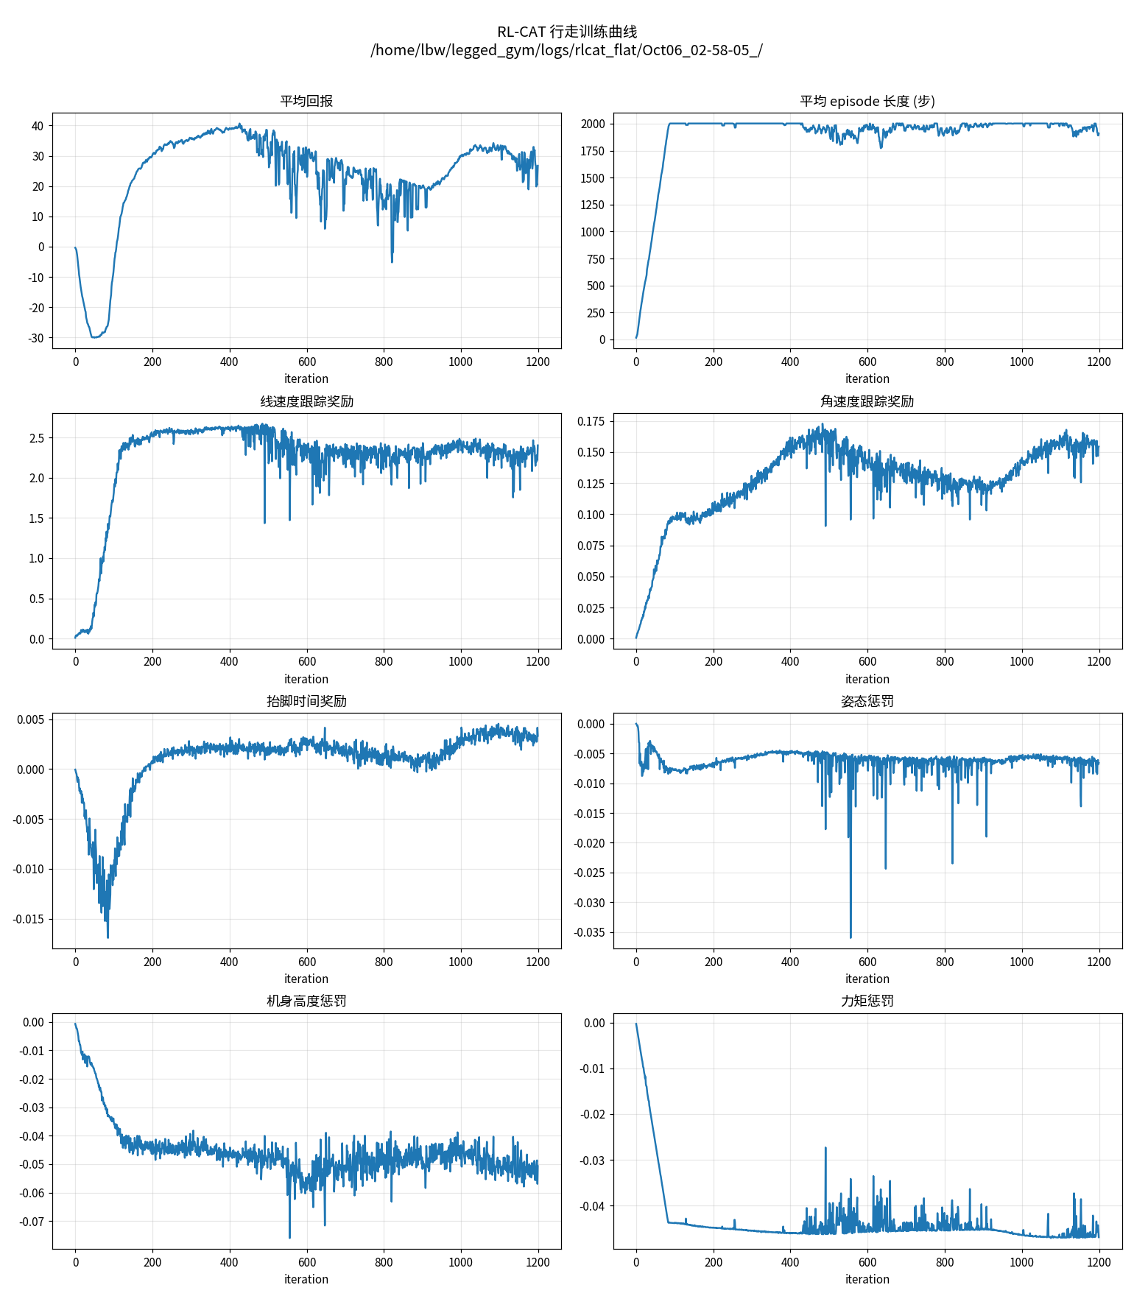
Sim/RL/plots/run7_best_curves.png
