vrrrrs/RL-CAT/hardware/BOM.csv

Category | Item | Part number / model | Qty | Function | Notes | Unit price | Source
Mechanical | 3D printed parts (thigh, calf, hip1, hip2, base_link, link) | 6 designs | 1 set | Structural parts | PLA Basic; STEP/STL in hardware/mechanical/
Actuator | Serial bus servo | Feetech ST-3215-C018 | 12 | One per joint | 4096 steps/rev, 1 Mbps bus, 12 V
Servo driver | Bus servo adapter board | Waveshare Bus Servo Adapter (A), SKU 25514 | 1 | STM32 <-> servo bus | Handles the 1 Mbps half-duplex bus
Realtime MCU | STM32F103C8T6 board | Generic "blue pill" / custom PCB | 1 | 100 Hz control loop | 72 MHz Cortex-M3, 64 KB flash
Host computer | Raspberry Pi 5 | 4 GB RAM | 1 | RL policy inference | Fed via USB-C from Mini560
Wireless | ESP32-C3 module | ESP32-C3 (any dev board with UART) | 1 | Optional Wi-Fi/TCP bridge | 115200 baud to STM32 USART3
IMU | Attitude sensor | WitMotion JY901P | 1 | Roll/pitch/yaw + gravity vector | I2C, bit-banged on PB8/PB9
Power | Li-ion battery | 3S1P 18650 pack | 1 | 9.0 - 12.6 V | Direct to servo bus via 16 AWG
Power | Buck converter | Mini560 5V/5A | 1 | Pi 5 supply | Feeds USB-C female on PCB
Power | Voltage divider | R1 100 kOhm, R2 20 kOhm, 100 nF | 1 set | Battery voltage to ADC | Ratio 6.000 -> PA0 (ADC1_IN0)
Power | USB-C receptacle | 16-pin, CC 2x 5.1 kOhm pulldown | 1 | Pi 5 power input | Do NOT feed GPIO 5V directly
Wiring | Servo power cable | 16 AWG silicone | - | Battery to servo bus | Servo current bypasses the control board
Wiring | Signal / logic wiring | Dupont 24-28 AWG | - | USART1/USART2/USART3 | Keep away from servo power leads
Safety | LiPo low-voltage buzzer | 3S balance-plug alarm | 1 | Cell-level undervoltage backup | Catches single-cell imbalance that total-voltage ADC cannot
Fasteners | Screws / standoffs | TODO - count mounting holes in STEP files | TODO | Assembly | ⚠️ Not yet inventoried
