vrrrrs/RL-CAT/hardware/mechanical/step/thigh.step

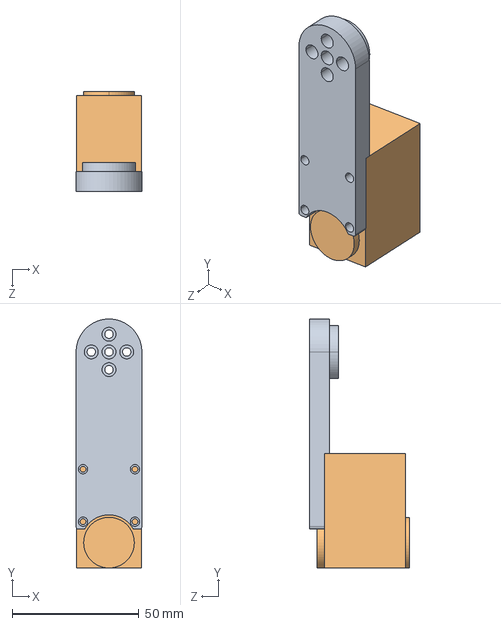
[picture p9: CAD file, 2026-10-19]
hardware/mechanical/step/thigh.step
26.0 x 98.3 x 39.5 mm
