vrrrrs/RL-CAT/hardware/mechanical/stl/link.stl

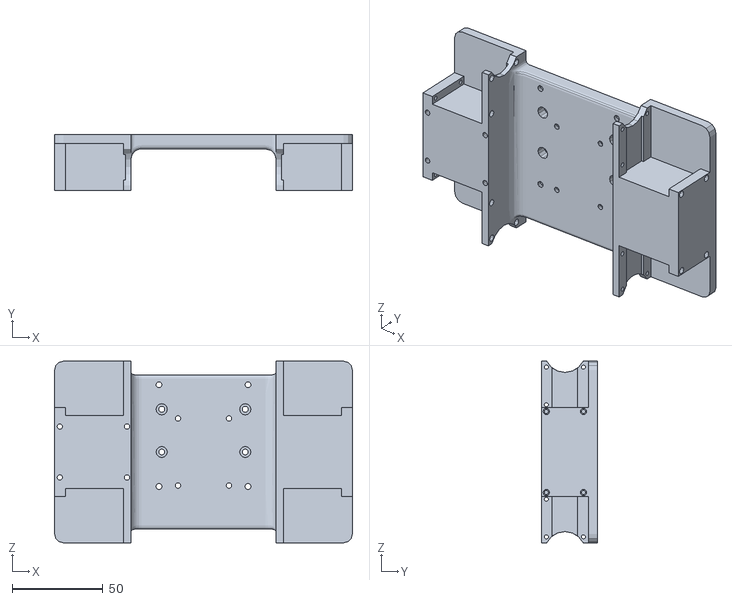
[picture p10: CAD file, 2026-10-19]
hardware/mechanical/stl/link.stl
164.0 x 31.0 x 100.0
