vrrrrs/RL-CAT/Sim/legged_gym/resources/robots/rlcat/urdf/meshes/part_12.stl

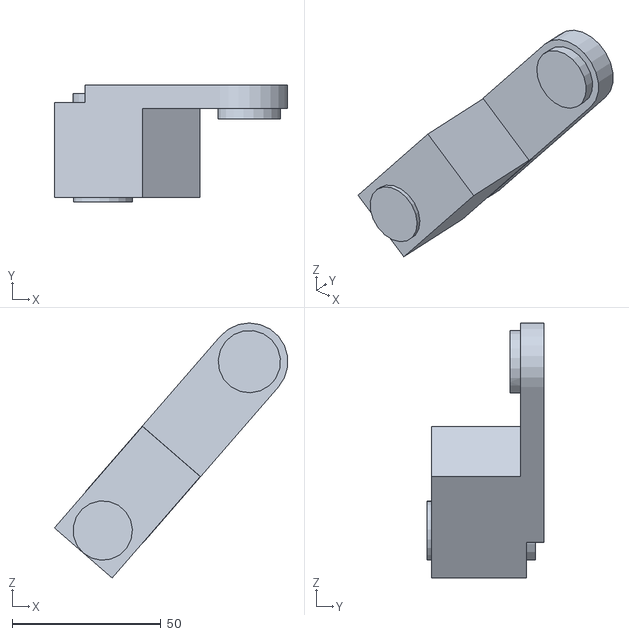
[picture p11: CAD file, 2026-10-19]
Sim/legged_gym/resources/robots/rlcat/urdf/meshes/part_12.stl
78.5 x 39.5 x 85.9
