vrrrrs/RL-CAT/Sim/RL/urdf/meshes/part_22.stl

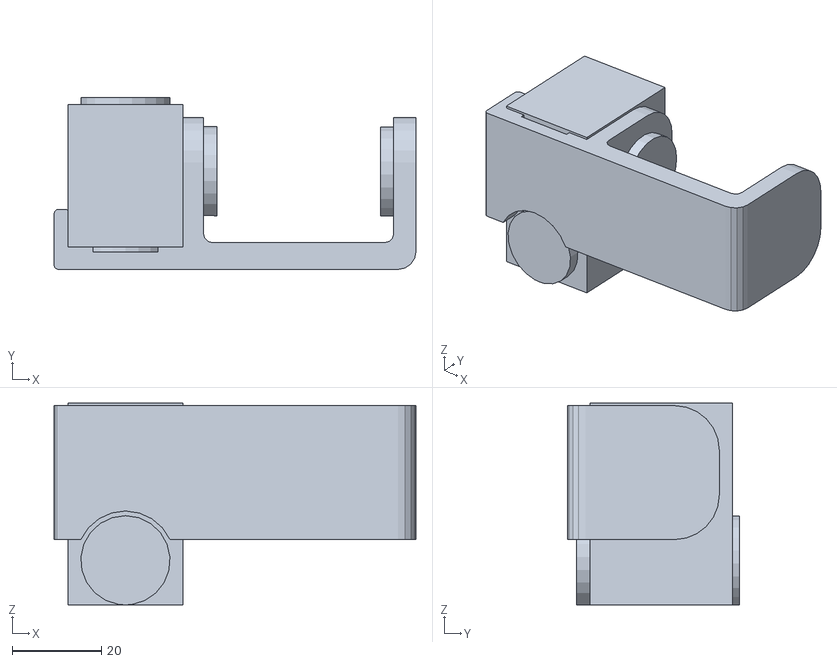
[picture p12: CAD file, 2026-10-19]
Sim/RL/urdf/meshes/part_22.stl
81.1 x 38.5 x 45.2
