vrrrrs/RL-CAT/hardware/mechanical/step/base_link.step

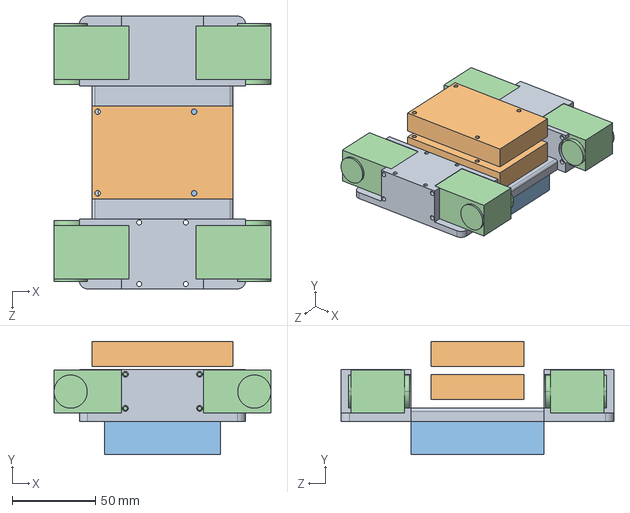
[picture p13: CAD file, 2026-10-19]
hardware/mechanical/step/base_link.step
130.5 x 68.0 x 164.0 mm
