vrrrrs/RL-CAT/Sim/legged_gym/resources/robots/rlcat/urdf/meshes/part_5.stl

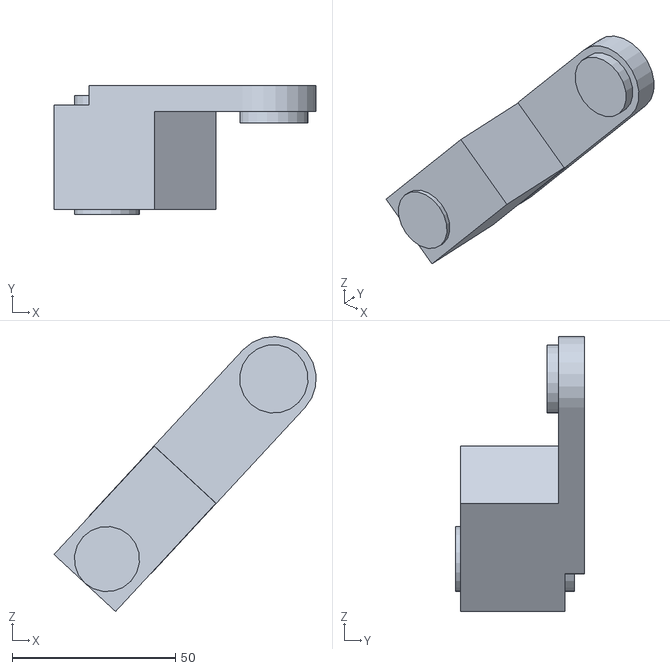
[picture p14: CAD file, 2026-10-19]
Sim/legged_gym/resources/robots/rlcat/urdf/meshes/part_5.stl
80.3 x 39.5 x 84.3
