vrrrrs/RL-CAT/hardware/mechanical/step/calf.step

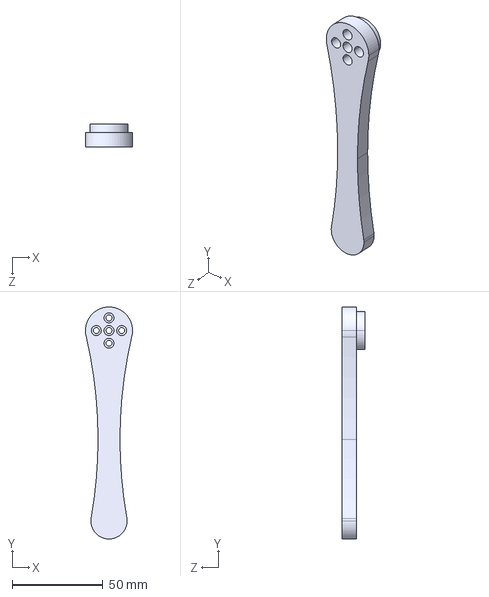
[picture p16: CAD file, 2026-10-19]
hardware/mechanical/step/calf.step
26.0 x 128.0 x 12.5 mm
