vrrrrs/RL-CAT/Sim/legged_gym/resources/robots/rlcat/urdf/meshes/part_2.stl

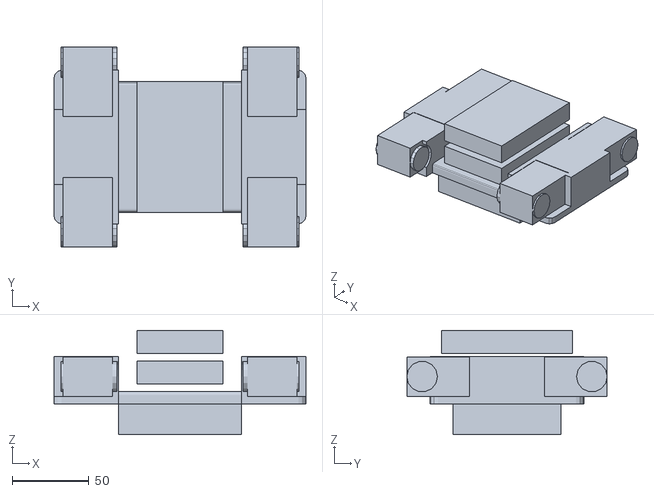
[picture p17: CAD file, 2026-10-19]
Sim/legged_gym/resources/robots/rlcat/urdf/meshes/part_2.stl
164.0 x 130.5 x 68.0
