vrrrrs/RL-CAT/Sim/RL/urdf/meshes/part_8.stl

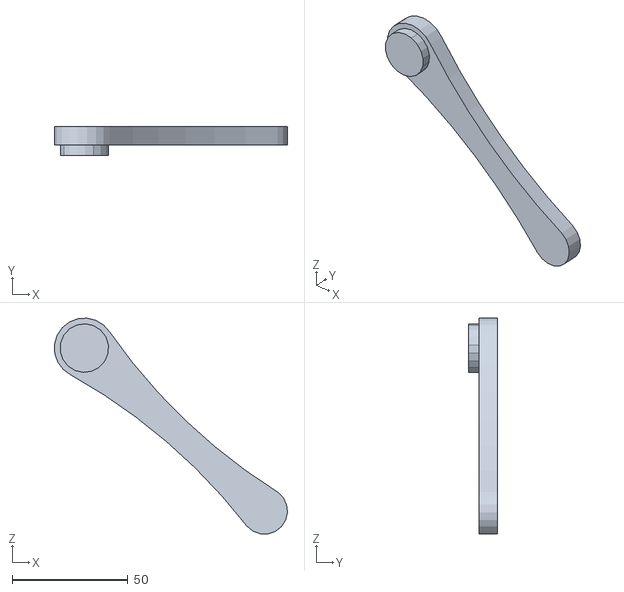
[picture p18: CAD file, 2026-10-19]
Sim/RL/urdf/meshes/part_8.stl
100.7 x 12.5 x 93.3
