vrrrrs/RL-CAT/hardware/mechanical/step/hip1.step

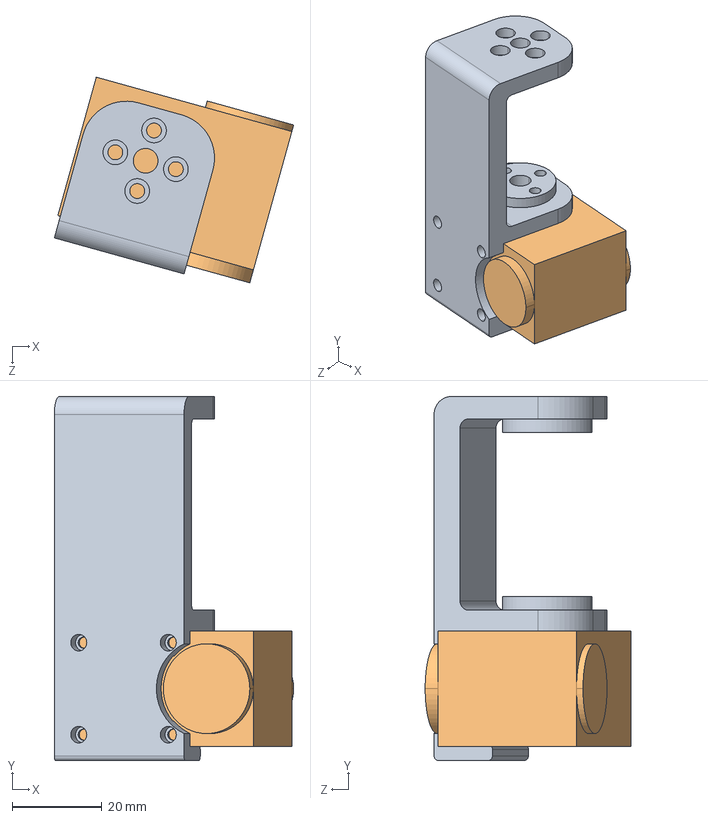
[picture p19: CAD file, 2026-10-19]
hardware/mechanical/step/hip1.step
53.3 x 81.1 x 45.8 mm
