vrrrrs/RL-CAT/hardware/mechanical/step/hip2.step

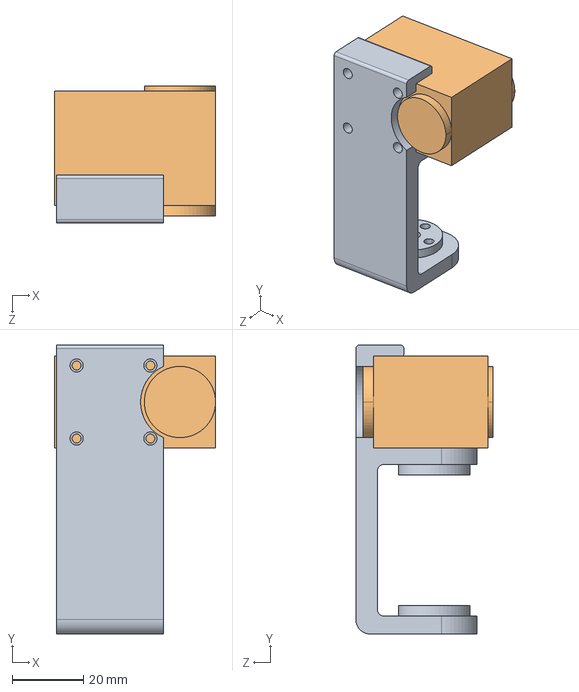
[picture p20: CAD file, 2026-10-19]
hardware/mechanical/step/hip2.step
45.2 x 81.1 x 38.5 mm
