vrrrrs/RL-CAT/Sim/RL/urdf/meshes/part_24.stl

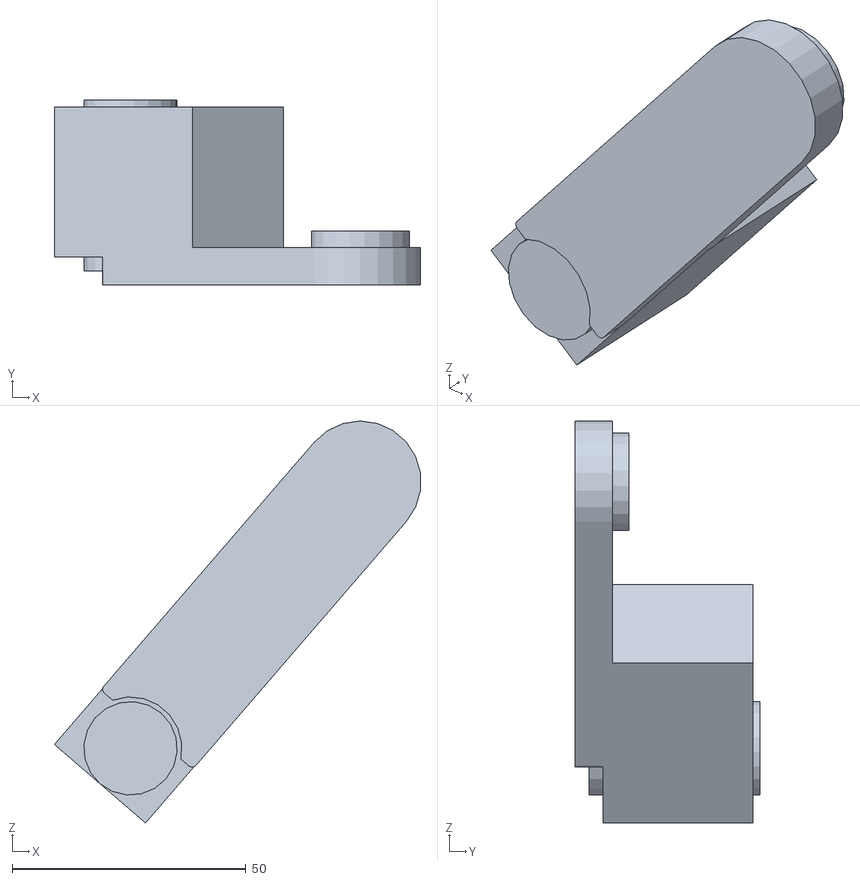
[picture p21: CAD file, 2026-10-19]
Sim/RL/urdf/meshes/part_24.stl
78.3 x 39.5 x 86.0
