vrrrrs/RL-CAT/Sim/RL/urdf/meshes/part_13.stl

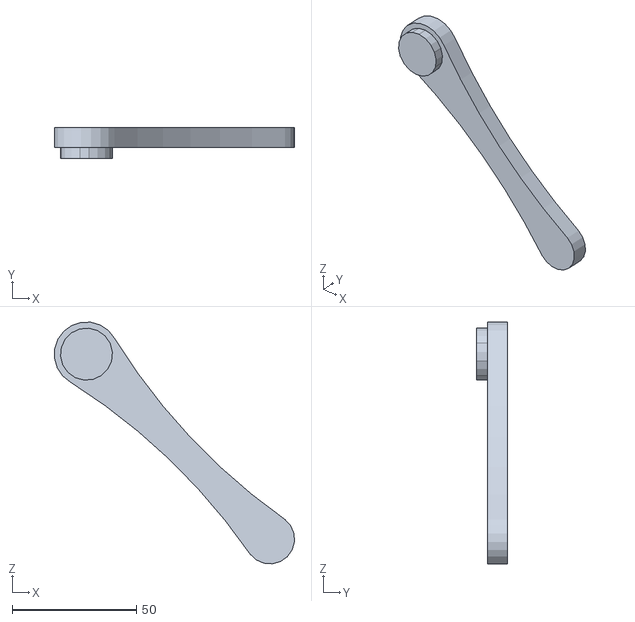
[picture p22: CAD file, 2026-10-19]
Sim/RL/urdf/meshes/part_13.stl
96.8 x 12.5 x 97.4
