vrrrrs/RL-CAT/Sim/RL/urdf/meshes/part_17.stl

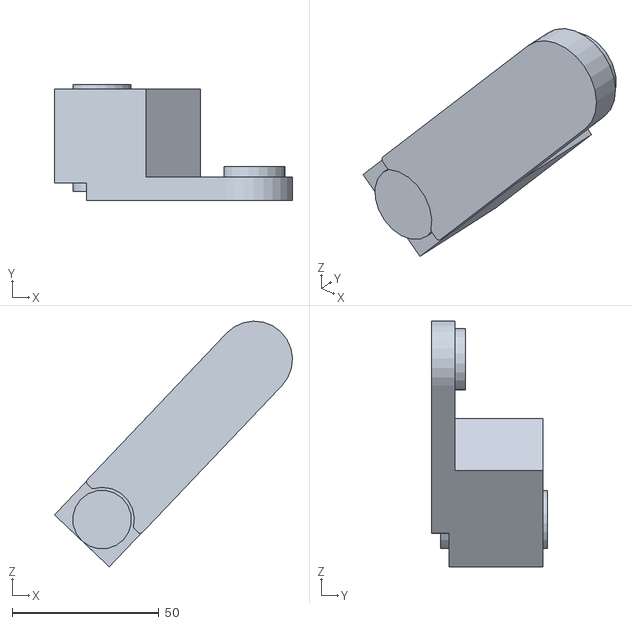
[picture p23: CAD file, 2026-10-19]
Sim/RL/urdf/meshes/part_17.stl
81.1 x 39.5 x 83.7
