vrrrrs/RL-CAT/Sim/RL/urdf/meshes/part_26.stl

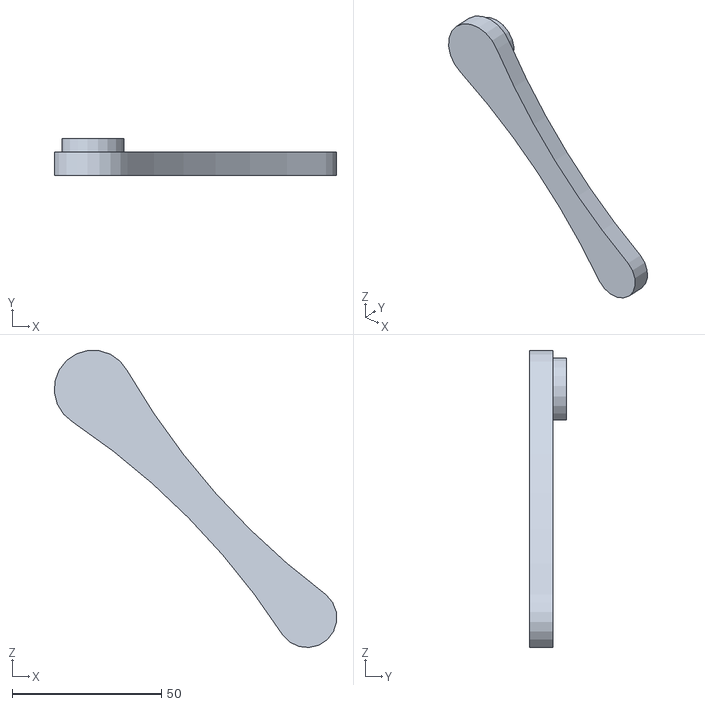
[picture p24: CAD file, 2026-10-19]
Sim/RL/urdf/meshes/part_26.stl
94.6 x 12.5 x 99.5
