vrrrrs/RL-CAT/Sim/RL/urdf/meshes/part_20.stl

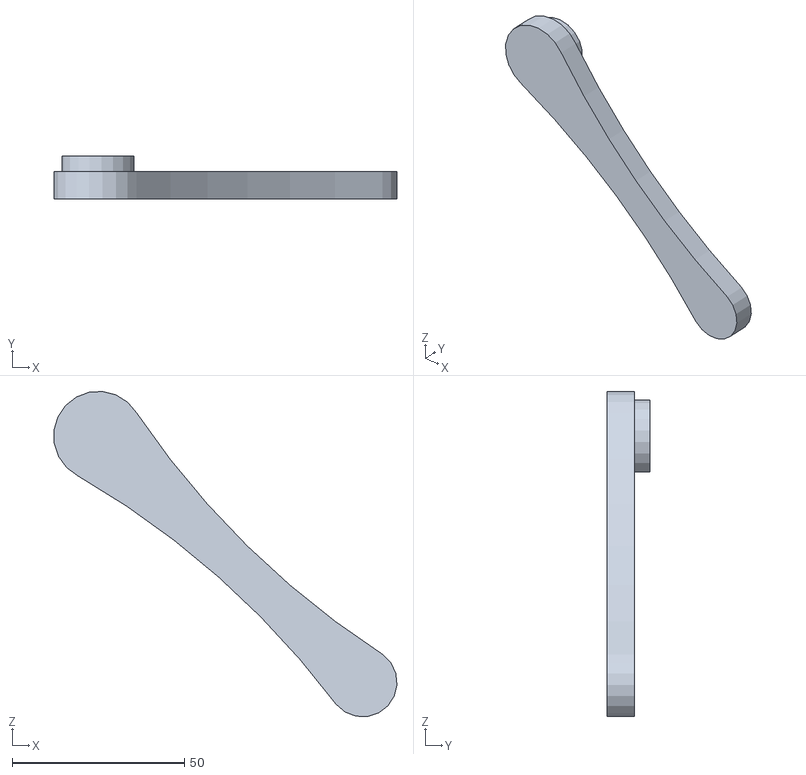
[picture p25: CAD file, 2026-10-19]
Sim/RL/urdf/meshes/part_20.stl
99.7 x 12.5 x 94.4
