vrrrrs/RL-CAT/(list of files, cad)

Other CAD files:
Sim/RL/urdf/meshes/part_4.stl
Sim/RL/urdf/meshes/part_16.stl
hardware/mechanical/stl/calf.stl
hardware/mechanical/stl/hip1.stl
hardware/mechanical/stl/hip2.stl
hardware/mechanical/stl/thigh.stl
