vrrrrs/RL-CAT/firmware/stm32/Core/Inc/main.h

#define LED_Pin GPIO_PIN_13
#define LED_GPIO_Port GPIOC
#define HEARTBEAT_Pin GPIO_PIN_8
#define HEARTBEAT_GPIO_Port GPIOA
#define SCL_Pin GPIO_PIN_8
#define SCL_GPIO_Port GPIOB
#define SDA_Pin GPIO_PIN_9
#define SDA_GPIO_Port GPIOB
